floesche/LED-Display_G4_Hardware_Driver/README.md

---
title: Panel PCB 2017
parent: Hardware
grand_parent: Generation 4
---

# G4 Panel

```
├── Design      - OrCAD `.BRD` file
├── Production  - Gerber + BOM
└── Schematic   - pdf with schematic
```
