floesche/LED-Display_G4_Hardware_Driver/driver_40mm_atmega_v1/production_v1/placement_pin1.txt

VERSION = 2.0
UUNITS = MILLIMETERS

#    refdes          !   symbol_x !   symbol_y ! rotation ! mirror ! symbol_name                      ! embedded_layer                  
#-----------------------------------------------------------------------------------------------------------------------
Y1                   !    15.5000 !    11.7000 !      180 !        ! CSTCE_V_C                        !                                 
Y2                   !    14.2000 !    33.2000 !        0 !        ! CSTCE_V_C                        !                                 
Y3                   !     7.7000 !    22.5000 !        0 !        ! CSTCE_V_C                        !                                 
Y4                   !    13.2000 !     3.6000 !       90 !        ! CSTCE_V_C                        !                                 
R11                  !    15.8001 !    31.3000 !      180 !        ! EIA0402                          !                                 
R12                  !    19.5250 !    29.8657 !      270 !        ! EIA0402                          !                                 
R13                  !    18.7440 !    29.8657 !      270 !        ! EIA0402                          !                                 
R14                  !    15.8077 !    35.3012 !      180 !        ! EIA0402                          !                                 
R15                  !    15.8077 !    36.0822 !      180 !        ! EIA0402                          !                                 
R16                  !    17.9630 !    38.2375 !       90 !        ! EIA0402                          !                                 
R17                  !    18.7440 !    38.2375 !       90 !        ! EIA0402                          !                                 
R18                  !    19.5250 !    38.2375 !       90 !        ! EIA0402                          !                                 
R2                   !    18.6193 !    13.5894 !      180 !        ! EIA0402                          !                                 
R20                  !    16.4944 !    19.8689 !      270 !        ! EIA0402                          !                                 
R21                  !    15.7134 !    19.8689 !      270 !        ! EIA0402                          !                                 
R22                  !    12.4647 !    21.5556 !      180 !        ! EIA0402                          !                                 
R23                  !    12.4647 !    24.9920 !      180 !        ! EIA0402                          !                                 
R24                  !    12.4647 !    25.7730 !      180 !        ! EIA0402                          !                                 
R25                  !    14.8390 !    28.5531 !       90 !        ! EIA0402                          !                                 
R26                  !    15.7762 !    28.5531 !       90 !        ! EIA0402                          !                                 
R27                  !    16.5572 !    28.5531 !       90 !        ! EIA0402                          !                                 
R29                  !    15.3391 !     3.4364 !      180 !        ! EIA0402                          !                                 
R3                   !    22.4928 !    11.9027 !      270 !        ! EIA0402                          !                                 
R30                  !    19.2126 !     1.9059 !      270 !        ! EIA0402                          !                                 
R31                  !    18.4316 !     1.9059 !      270 !        ! EIA0402                          !                                 
R32                  !    15.4953 !     7.1852 !      180 !        ! EIA0402                          !                                 
R33                  !    15.4953 !     7.9662 !      180 !        ! EIA0402                          !                                 
R34                  !    17.9630 !    10.4339 !       90 !        ! EIA0402                          !                                 
R35                  !    18.7440 !    10.4339 !       90 !        ! EIA0402                          !                                 
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
R54                  !    22.8999 !    24.6000 !        0 !        ! EIA0402                          !                                 
R55                  !    22.8999 !    25.4000 !        0 !        ! EIA0402                          !                                 
R56                  !    22.8999 !    26.2000 !        0 !        ! EIA0402                          !                                 
R57                  !    22.8999 !    27.0000 !        0 !        ! EIA0402                          !                                 
R58                  !    22.8999 !    27.8000 !        0 !        ! EIA0402                          !                                 
R59                  !    18.8000 !    19.6001 !      270 !        ! EIA0402                          !                                 
R60                  !    19.6000 !    19.6001 !      270 !        ! EIA0402                          !                                 
R61                  !    29.8371 !     3.6830 !      180 !        ! EIA0402                          !                                 
R62                  !    26.9161 !     3.6830 !      180 !        ! EIA0402                          !                                 
R63                  !    25.9080 !     9.0091 !      270 !        ! EIA0402                          !                                 
R64                  !    29.7101 !     8.1280 !      180 !        ! EIA0402                          !                                 
R65                  !    33.7741 !     7.7470 !      180 !        ! EIA0402                          !                                 
R66                  !    36.0680 !     7.1199 !       90 !        ! EIA0402                          !                                 
R67                  !    35.4251 !     3.6830 !      180 !        ! EIA0402                          !                                 
R68                  !    32.7581 !     3.6830 !      180 !        ! EIA0402                          !                                 
R1                   !     1.0934 !    12.2151 !      270 !        ! EIA0402                          !                                 
R10                  !    28.5001 !    28.0000 !      180 !        ! EIA0402                          !                                 
R19                  !    12.1521 !    28.5846 !        0 !        ! EIA0402                          !                                 
R28                  !    38.7376 !    13.4017 !       90 !        ! EIA0402                          !
