floesche/LED-Display_G4_Hardware_Driver/docs/assets/driver_v1p2_back_photo.jpg

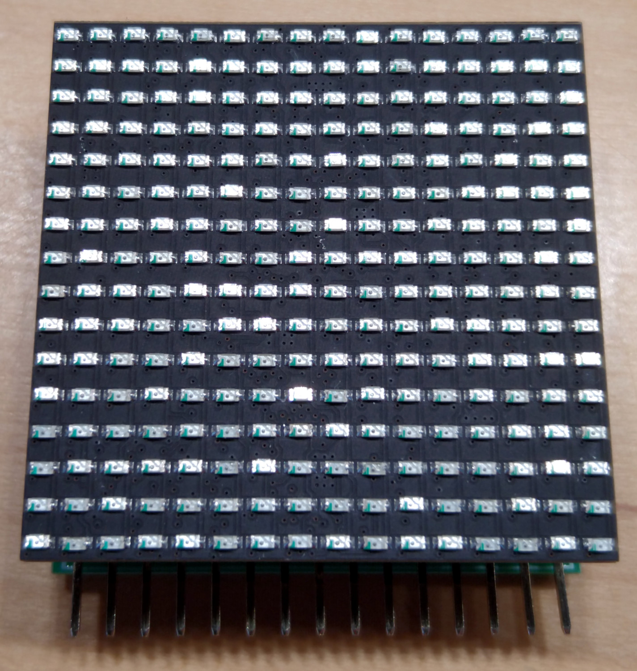
docs/assets/driver_v1p2_back_photo.jpg
