floesche/LED-Display_G4_Hardware_Driver/docs/assets/driver_v1p6_front_iso-photo.png

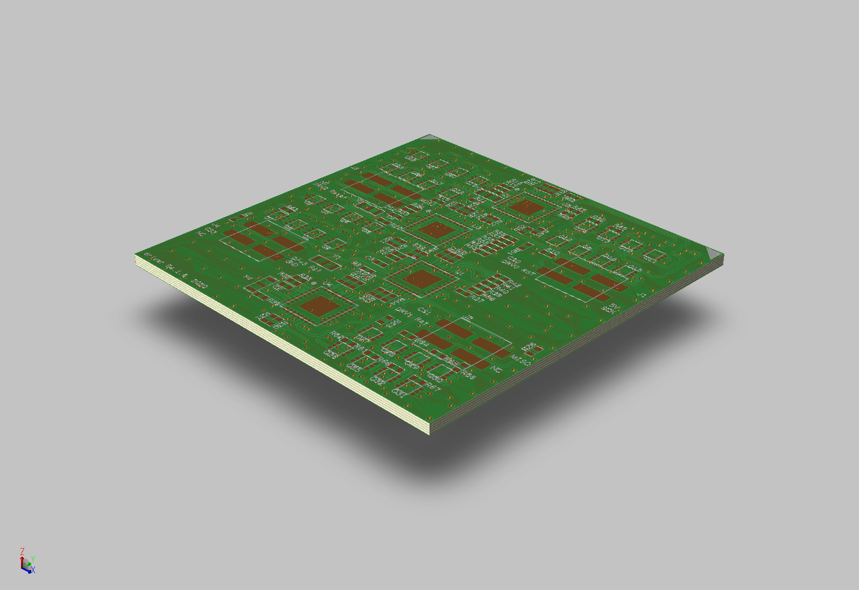
docs/assets/driver_v1p6_front_iso-photo.png
