floesche/LED-Display_G4_Hardware_Driver/docs/assets/driver_v1p6_front_render.jpg

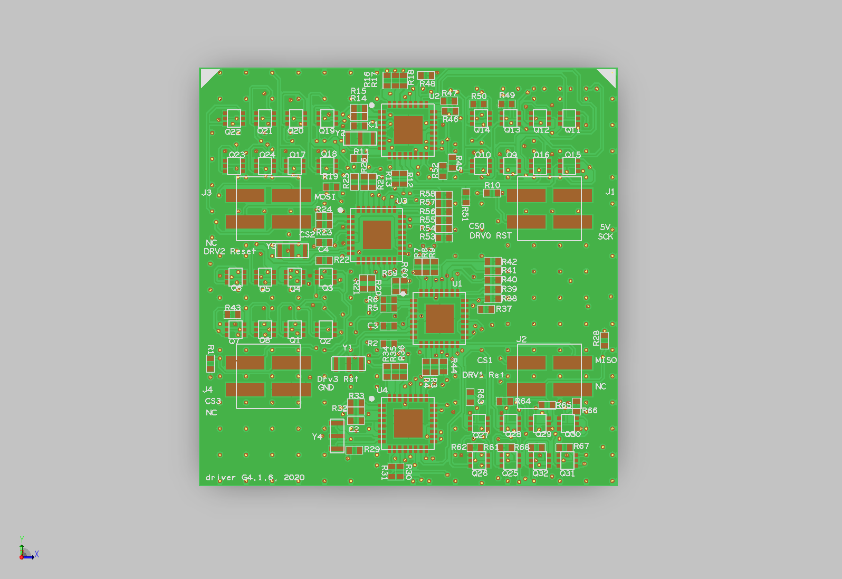
docs/assets/driver_v1p6_front_render.jpg
