floesche/LED-Display_G4_Hardware_Driver/docs/assets/driver_v2p0_back_photo.jpg

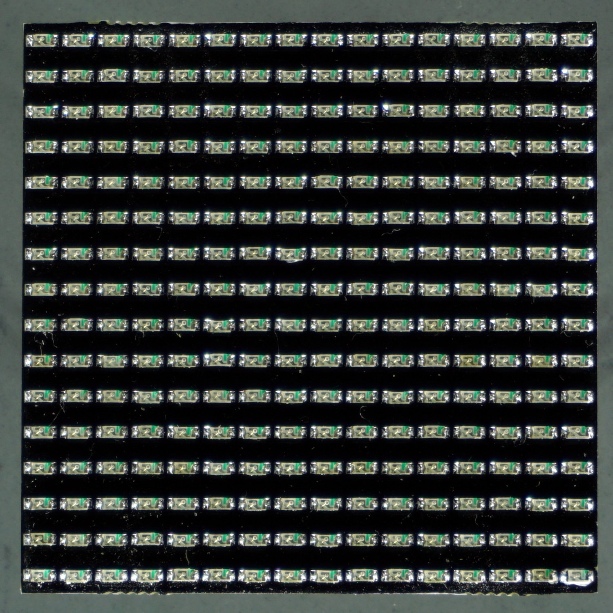
docs/assets/driver_v2p0_back_photo.jpg
