floesche/LED-Display_G4_Hardware_Driver/driver_40mm_max6960_v0/BOM.xls

Item # | Qty | Reference | Description | P/N | Vendor
1 | 1 | C1 | 0.47uf capacitor, SM0603 | 718-1609-6-ND | Digikey
2 | 2 | C2,C3 | 0.1uF capacitor, SM0603 | 1276-1258-6-ND | Digkey
3 | 2 | P1, P2 | 15x2 SMD conector, male | PTSHSM-515-D-06-T-AP- -XX-X-LF, note XX-X can be TR-P, TP-P or TR-0 | Major League Electronics
4 | 1 | P3 | 15 position right angle male header, 0.1” pitch | A32702-40-ND | Digikey
5 | 1 | P4 | 15 position right angle female header, 0.1” pitch | S5490-ND | Digikey
6 | 2 | U1, U3 | 8x8 Matrix Graphic LED Driver | 700-MAX6963ATH | Mouser
7 | 1 | U2 | Single buffer gate with 3-State Output | 74AHC1G126SE-7DIDKR-ND | Digikey
