floesche/LED-Display_G4_Hardware_Driver/driver_32mm_atmega_v0p2/BOM.xls

Sheet: Sheet1
Item# | Qty | References | part desc. | mfg P/N | vendor | price | $100 | $500 | $1000 | $1500 | $2000 | 100 | 500 | 1000 | 1500 | 2000 | price/board_100 | price/board_500 | price/board_1000 | price/board_1500 | price/board_2000 | MOQ | Availability | Comments_Lj | Your Comments
1 | 1 | U1 | IC DRIVER DARL 8CH 50V.5A 18-SO | ULN2804AFWG(CELHACT-ND) | Digikey | 0.92 | 0.63 | 0.462 | 0.3675 | 0.336 | 0.3045 | 100 | 500 | 1000 | 1500 | 2000 | 0.63 | 0.462 | 0.3675 | 0.336 | 0.3045 | 1 | 26688
2 | 1 | IC1 | IC AVR MCU 16K 20MHZ 32TQFP | ATMEGA168-20AU-ND | Digikey | 4.32 | 2.412 | 2.412 | 2.412 | 2.412 | 2.412 | 100 | 500 | 1000 | 1500 | 2000 | 2.412 | 2.412 | 2.412 | 2.412 | 2.412 | 1 | 53937
3 | 2 | P3, P4 | 8 POS PEEL-A-WAY SIP CONN. | Custom | Adv. Interconn. |  |  |  |  |  |  |  |  |  | 3000 | 4000 | 0 | 0 | 0 | 0 | 0 |  |  |  | Already purchased. This is a 32 position strip. The board requires 2x8 pos strips.
4 | 8 | R1, R2, R3, R4, R5, R6, R7, R8 | RES 0603 82 OHM 1/10W 1% | P82.0HCT-ND | Digikey | 0.8 | 0.0105 | 0.00576 | 0.00384 | 0.00198 | 0.00198 | 800 | 4000 | 8000 | 12000 | 16000 | 0.084 | 0.04608 | 0.03072 | 0.01584 | 0.01584 | 1 | 77007
5 | 1 | R9 | RES 0603 10K OHM 1/10W 5% | P10KGCT-ND | Digikey | 0.1 | 0.007 | 0.00384 | 0.00256 | 0.00256 | 0.00256 | 100 | 500 | 1000 | 1500 | 2000 | 0.007 | 0.00384 | 0.00256 | 0.00256 | 0.00256 | 1 | 13551465
6 | 2 | C1, C2 | CAP 0603 0.33 uF | PCC2274CT-ND | Digikey | 0.5 | 0.0573 | 0.0293 | 0.0207 | 0.0172 | 0.0172 | 200 | 1000 | 2000 | 3000 | 4000 | 0.1146 | 0.0586 | 0.0414 | 0.0344 | 0.0344 | 1 | 138896 | No stock available with major suppliers. Please provide an alternate p/n. | Providing alternative part number. Please purchase the 4,000 MOQ and keep the surplus in stock. We will be placing recurring orders.
7 | 1 | P2 | CONN RIGHT-ANGLE, 8 POS, MALE | LTSHR-108-S-02-A-T | MLE |  |  |  |  |  |  |  |  | 1000 | 1500 | 2000 | 0 | 0 | 0 | 0 | 0 |  |  |  | Already purchased
8 | 1 | P1 | CONN RIGHT-ANGLE, 8 POS, FEMALE | SSHR-108-S-02-L-T | MLE |  |  |  |  |  |  |  |  | 1000 | 1500 | 2000 | 0 | 0 | 0 | 0 | 0 |  |  |  | Already purchased
9 | 1 | X1 | CERAMIC RES 20 MHz | 490-1199-6-ND | Digikey | 0.95 | 0.4731 | 0.35862 | 0.32809 | 0.25637 | 0.25637 | 100 | 500 | 1000 | 1500 | 2000 | 0.4731 | 0.35862 | 0.32809 | 0.25637 | 0.25637 | 1 | 34790
 |  |  |  |  |  |  |  |  |  |  |  |  |  |  |  |  | 3.7207 | 3.34114 | 3.18227 | 3.05717 | 3.02567

Sheet: BOM_SS
Item# | Qty | References | part desc. | mfg P/N | vendor
2 | 1 | IC1 | IC AVR MCU 16K 20MHZ 32TQFP | ATMEGA168-20AU-ND | Digikey
3 | 16 | P3, P4 | PIN RECEPTACLES | Elpacko PN 4007-2-01-32-12 | Straight Road Electronics ( see * below)
4 | 8 | R1, R2, R3, R4, R5, R6, R7, R8 | RES 0603 160 OHM 1/10W 0.1% | RG16P160BCT-ND | Digikey
5 | 1 | R9 | RES 0603 10K OHM 1/10W 5% | P10KGCT-ND | Digikey
6 | 2 | C1, C2 | CAP 0603 0.33 uF | 445-12434-1-ND | Digikey
7 | 1 | P2 | CONN RIGHT-ANGLE, 8 POS, MALE | S1111EC-08-ND | Digikey
8 | 1 | P1 | CONN RIGHT-ANGLE, 8 POS, FEMALE | SAM1195-08-ND | Digikey
9 | 1 | X1 | CERAMIC RES 20 MHz | 490-1199-6-ND | Digikey
8 | 8 | U1-U8 | MOSFET N/P-CH 20V SOT563 | DMC2400UV-7DICT-ND | Digikey
* Supplied by Straight Road electronics http://www.straightroadelectronics.com/ Contact: Debby Arrin (949) 215-9449.
