floesche/LED-Display_G4_Hardware_Driver/driver_40mm_atmega_v0p1/BOM.xls

Item # | Qty | Reference | Description | P/N | Vendor
1 | 4 | C1 – C4 | 0.1uF ceramic capacitor, SM0603 | 1276-1258-1-ND | Digikey
2 | 4 | IC1 – IC4 | Atmel Atmega328 20MHz | ATMEGA328P-MURDKR-ND | Digikey
3 | 2 | P1, P2 | 3x2 female header, 0.1” pitch | S7106-ND | Digikey
4 | 4 | R1 – R4 | 1k Ohm resistor, SM0603 | P1.0KGCT-ND | Digikey
5 | 32 | R5 – R36 | 180 Ohm resistor, SM0603 | P180GCT-ND | Digikey
6 | 4 | X1 - X4 | 20MHz ceramic resonator | 490-1199-6-ND | Digikey
7 | 8 | K1 – K8 | 8x1 Recepticals for 0.015 to 0.021” Pins | NA | Customer will supply
