floesche/LED-Display_G4_Hardware_Driver/driver_40mm_atmega_v0p2/BOM.xls

Modifiied Components: P1-P4, R1-R4,
Item # | Qty | Reference | Description | P/N | Vendor
1 | 4 | C1 – C4 | 0.1uF ceramic capacitor, SM0603 | 1276-1258-1-ND | Digikey
2 | 4 | IC1 – IC4 | Atmel Atmega328 20MHz | ATMEGA328P-MURDKR-ND | Digikey
3 | 2 | P1-P4 | 2x2 male header, 0.1” pitch | 952-2119-ND | Digikey
4 | 4 | R1 – R4 | 4.7k Ohm resistor, SM0603 | 311-4.7KGRCT-ND | Digikey
5 | 32 | R5 – R36 | 180 Ohm resistor, SM0603, 1% | 311-180HRCT-ND | Digikey
6 | 4 | X1 - X4 | 20MHz ceramic resonator | 490-1199-6-ND | Digikey
7 | 8 | K1 – K8 | 8x1 Recepticals for 0.015 to 0.021” Pins | PN 4007-2-01-32-12 and PN 14-3-8-4007-2-TG | Elpacko (* see note below)
 |  |  |  |  | * Pin recepticals PN 4007-2-01-32-12 with PN 14-3-8-4007-2-TG single row, on the 8-pin pull away aluminum carrier w/ 0.1" pitch
 |  |  |  |  | Supplied by Straight Road electronics http://www.straightroadelectronics.com/ .
 |  |  |  |  | Contact: Debby Arrin (949) 215-9449.
