floesche/LED-Display_G4_Hardware_Driver/driver_40mm_max6960_v0/adapter_20mm-40mm_v0p1/BOM.xls

Item # | Qty | Reference | Description | P/N | Vendor
1 | 8 | K1 – K8 | 8x1 Recepticals for 0.015 to 0.021” Pins | NA | Customer will supply
2 | 1 | P1, P2 | 15x2 SMD connector, female | PSSHSM-515-D-T-AP- -XX-X-LF (Note, XX-X can be TR-P, TP-P, TP-0)
