floesche/LED-Display_G4_Hardware_Driver/driver_40mm_atmega_v1/production_v1/BOM.xlsx

item | Layer | Part number | SYM_NAME | COMP_DEVICE_TYPE | Digikey number | QUANTITY | Notes | COMP_CLASS | QUANTITY | REFDES
1 | TOP | CSTNE20M0V53Z000R0 | CSTCE_V_C | CERAMIC RES 20.0000MHZ 15PF SMD | 490-17955-6-ND | 4 |  | IC | 4 | Y1;Y2;Y3;Y4
2 | TOP | CC0402ZRY5V7BB104 | EIA0402 | CAP NP_EIA0402_CAP NP | 311-1047-6-ND | 4 | or similar | IC | 4 | C1;C2;C3;C4
3 | TOP | RC0402FR-074K7L | EIA0402 | RESISTOR_EIA0402_4.7K/1% | 311-4.7KLRDKR-ND | 36 | or similar | IC | 36 | R1;R10;R19;R28;R37;R38;R39;R40;R41;R42;R43;R44;R45;R46;R47;R48;R49;R50;R51;R52;R53;R54;R55;R56;R57;R58;R59;R60;R61;R62;R63;R64;R65;R66;R67;R68
4 | TOP | RT0402BRD07210RL | EIA0402 | RESISTOR_EIA0402_210/0.1% | YAG4205DKR-ND | 32 | Or similar; needs to match item 6 | IC | 32 | R2;R3;R4;R5;R6;R7;R8;R9;R11;R12;R13;R14;R15;R16;R17;R18;R20;R21;R22;R23;R24;R25;R26;R27;R29;R30;R31;R32;R33;R34;R35;R36
5 | TOP | 15912040 | HDR-SMD-2X2 | CONN HEADER SMD 4POS 2.54MM | WM9514-ND | 4 |  | IC | 4 | J1;J2;J3;J4
6 | BOTTOM | LTST-C191KGKT | LED-0603 | LED_LED-0603_LED | 160-1446-6-ND | 256 | an example, use whatever color required | IC | 256 | D1;D2;D3;D4;D5;D6;D7;D8;D9;D10;D11;D12;D13;D14;D15;D16;D17;D18;D19;D20;D21;D22;D23;D24;D25;D26;D27;D28;D29;D30;D31;D32;D33;D34;D35;D36;D37;D38;D39;D40;D41;D42;D43;D44;D45;D46;D47;D48;D49;D50;D51;D52;D53;D54;D55;D56;D57;D58;D59;D60;D61;D62;D63;D64;D65;D66;D67;D68;D69;D70;D71;D72;D73;D74;D75;D76;D77;D78;D79;D80;D81;D82;D83;D84;D85;D86;D87;D88;D89;D90;D91;D92;D93;D94;D95;D96;D97;D98;D99;D100;D101;D102;D103;D104;D105;D106;D107;D108;D109;D110;D111;D112;D113;D114;D115;D116;D117;D118;D119;D120;D121;D122;D123;D124;D125;D126;D127;D128;D129;D130;D131;D132;D133;D134;D135;D136;D137;D138;D139;D140;D141;D142;D143;D144;D145;D146;D147;D148;D149;D150;D151;D152;D153;D154;D155;D156;D157;D158;D159;D160;D161;D162;D163;D164;D165;D166;D167;D168;D169;D170;D171;D172;D173;D174;D175;D176;D177;D178;D179;D180;D181;D182;D183;D184;D185;D186;D187;D188;D189;D190;D191;D192;D193;D194;D195;D196;D197;D198;D199;D200;D201;D202;D203;D204;D205;D206;D207;D208;D209;D210;D211;D212;D213;D214;D215;D216;D217;D218;D219;D220;D221;D222;D223;D224;D225;D226;D227;D228;D229;D230;D231;D232;D233;D234;D235;D236;D237;D238;D239;D240;D241;D242;D243;D244;D245;D246;D247;D248;D249;D250;D251;D252;D253;D254;D255;D256
7 | TOP | ATMEGA328P-MUR | QFN32 | ATMEGA328P-MU_6_QFN32_ATMEGA328 | ATMEGA328P-MURDKR-ND | 4 |  | IC | 4 | U1;U2;U3;U4
8 | TOP | DMC2400UV-7 | SOT563 | MPM3002_0_SOT563_DMC2400UV | DMC2400UV-7DIDKR-ND | 32 |  | IC | 32 | Q1;Q2;Q3;Q4;Q5;Q6;Q7;Q8;Q9;Q10;Q11;Q12;Q13;Q14;Q15;Q16;Q17;Q18;Q19;Q20;Q21;Q22;Q23;Q24;Q25;Q26;Q27;Q28;Q29;Q30;Q31;Q32
