floesche/LED-Display_G4_Hardware_Driver/(threads)

Thread 1 (2022-12-16):

Files for the panel driver v2

phifisch, 2022-12-16:
Hi,
Thanks for the work, but I am missing the files for the version 2 of the driver panel. Information about it is included on the web page (github.io), so I suppose it is missing here, or is there a reason for that?
Best,
Philippe

floesche, 2022-12-16:
Hi @phifisch, thanks for your question. Can you please paste the link to the website where the missing information is mentioned? That would help identifying the problem.

floesche, 2022-12-16:
You probably mean this page, right? https://reiserlab.github.io/Modular-LED-Display/Generation%204/Panel/docs/driver.html#driver-v2

If so: we have not characterized the driver-v2 as well as v1, so we chose not to share it yet. I would like to understand better how and if we can help you with this. So if you shoot me an email (see https://reiserlab.github.io/Modular-LED-Display/Contact.html), maybe we continue the conversation that way?
