floesche/LED-Display_G4_Hardware_Driver/docs/assets/driver_40mm_atmega_v0p1_schematic.pdf

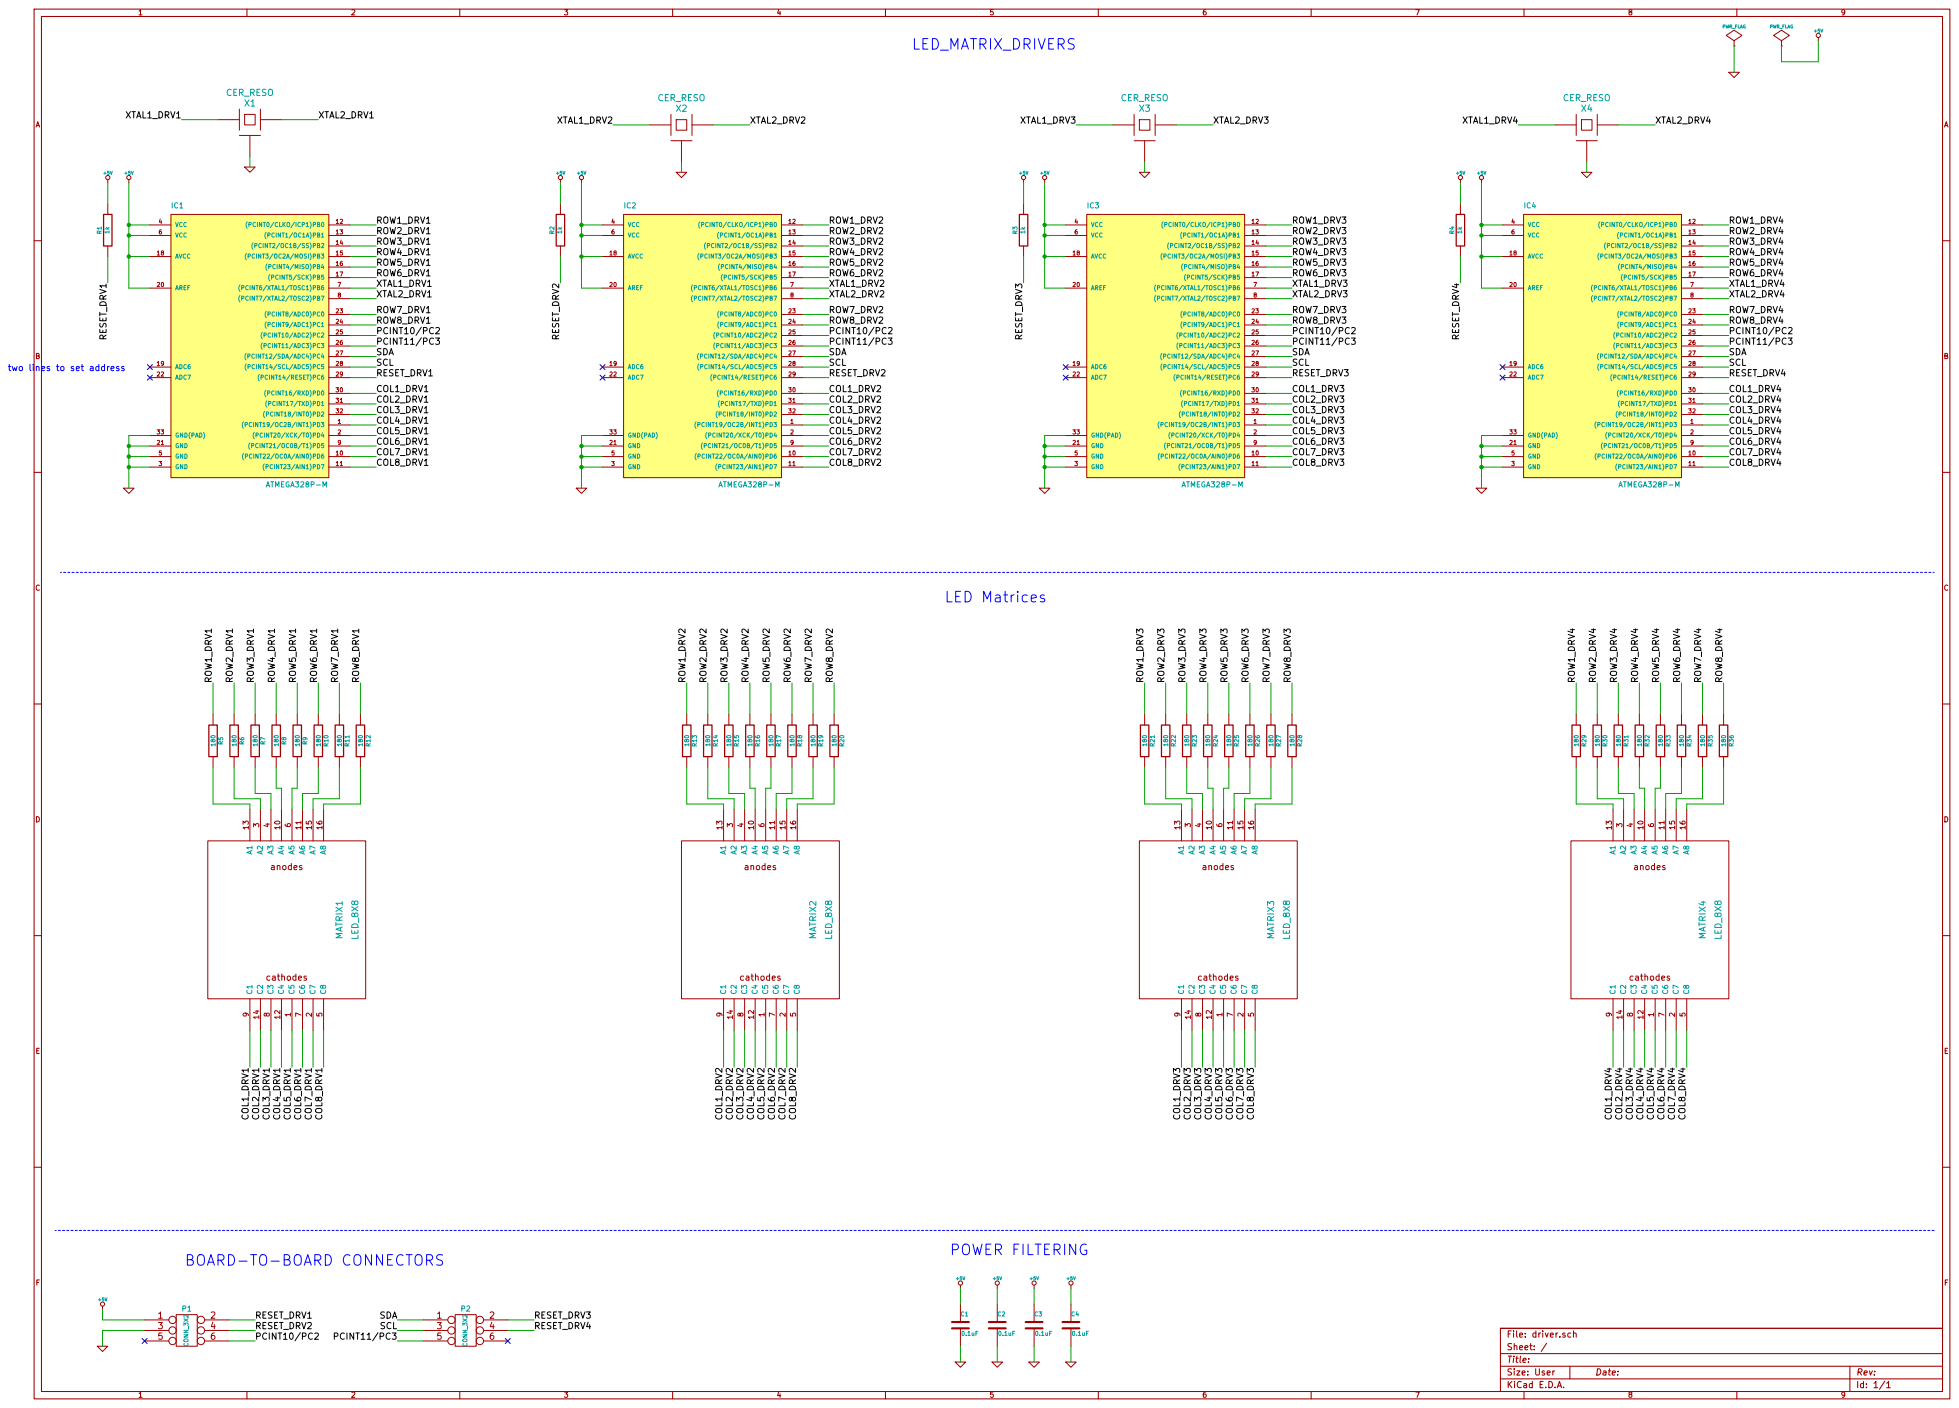
[picture p45: page 1]

two lines to set address

BOARD-TO-BOARD CONNECTORS

Id: 1/1 Title: File: driver.sch Sheet: /
