floesche/LED-Display_G4_Hardware_Driver/docs/assets/driver_40mm_atmega_v0p3_schematic.pdf

BOARD-TO-BOARD CONNECTORS

Id: 1/1 Title: File: driver.sch Sheet: /
