floesche/LED-Display_G4_Hardware_Driver/docs/assets/driver_40mm_atmega_v0p5_schematic.pdf

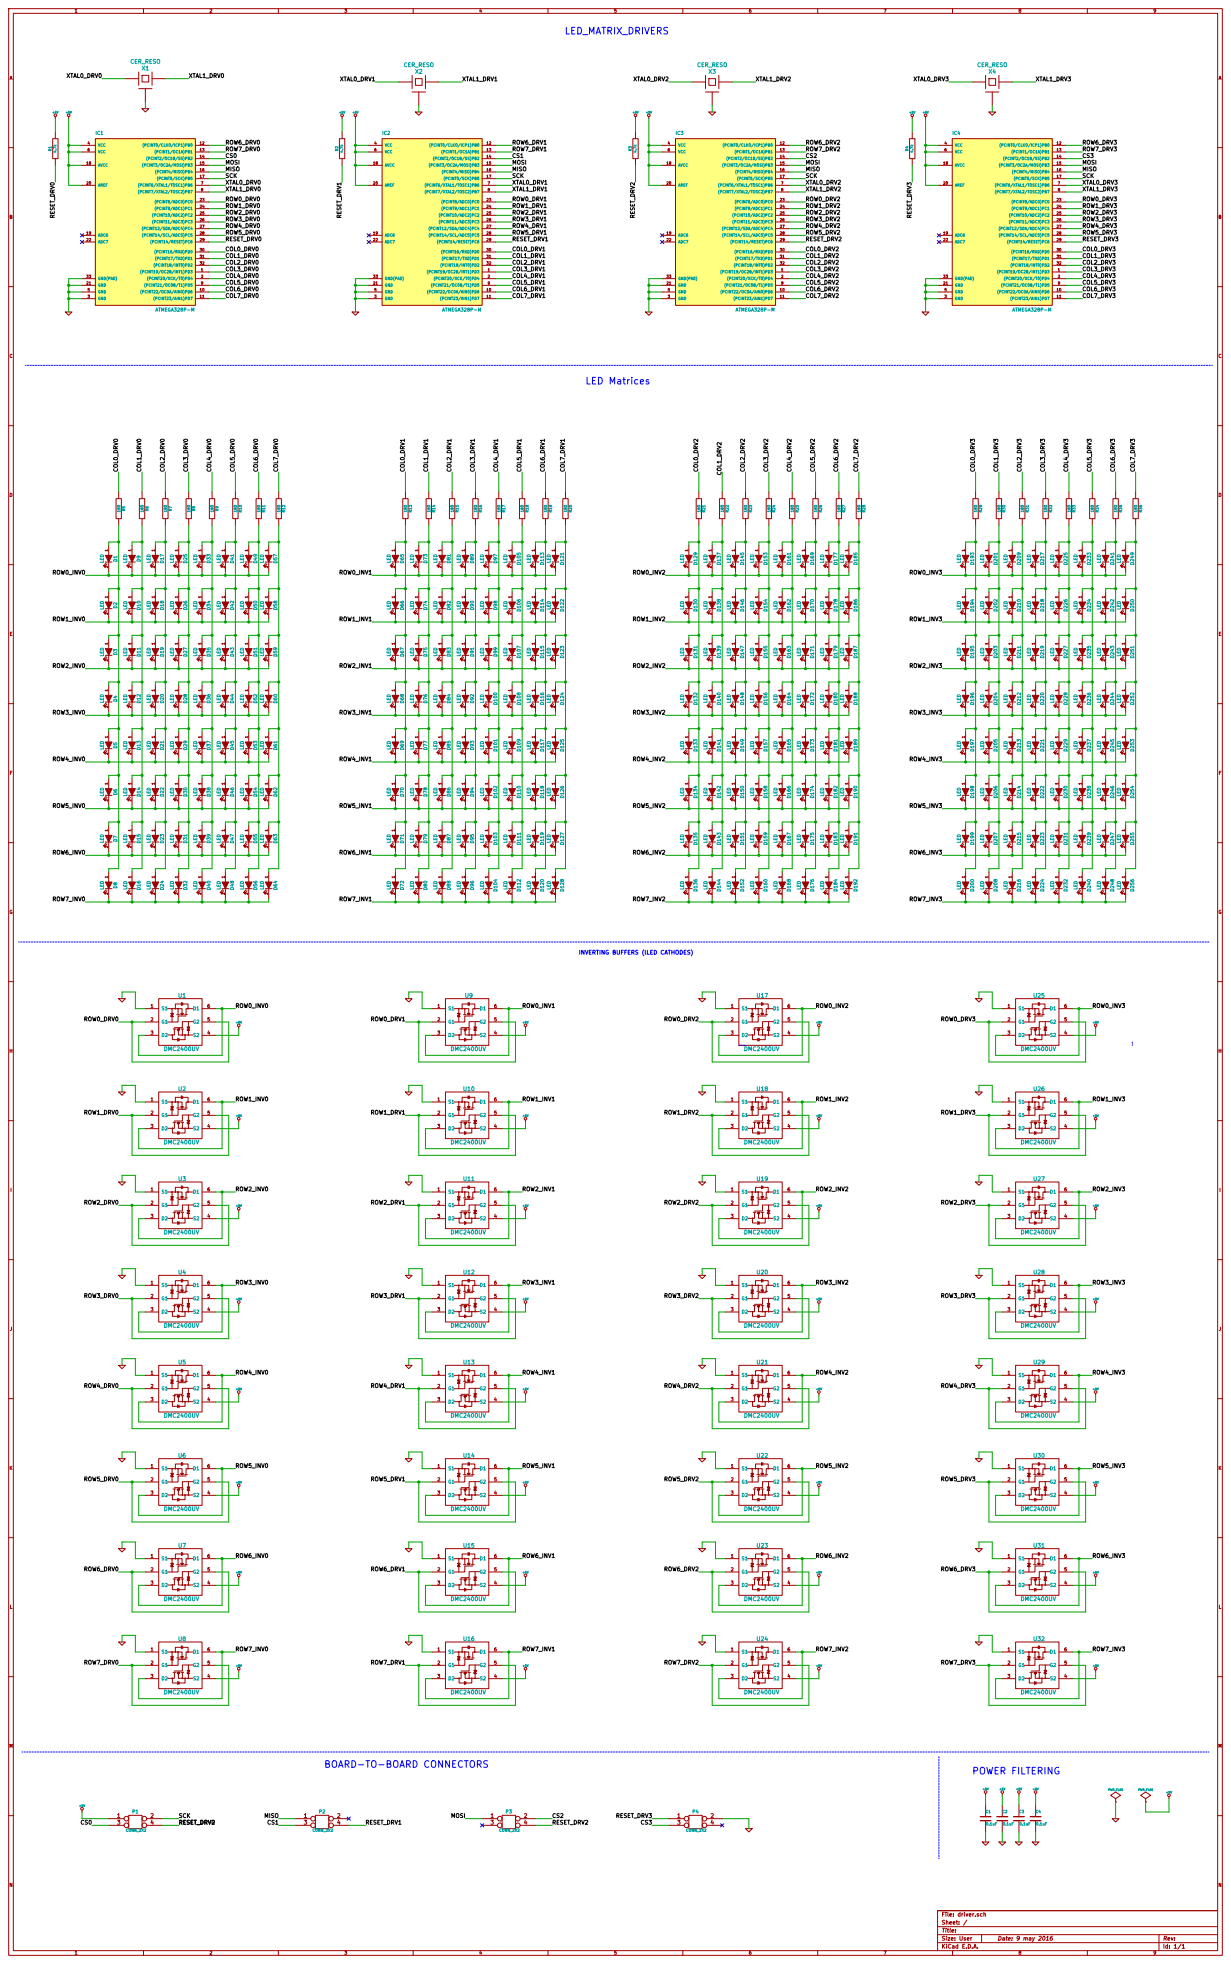
[picture p47: page 1]

INVERTING BUFFERS (lLED CATHODES)

BOARD-TO-BOARD CONNECTORS

Id: 1/1 Title: File: driver.sch Sheet: /
