floesche/LED-Display_G4_Hardware_Driver/docs/assets/driver_40mm_atmega_v0p4_schematic.pdf

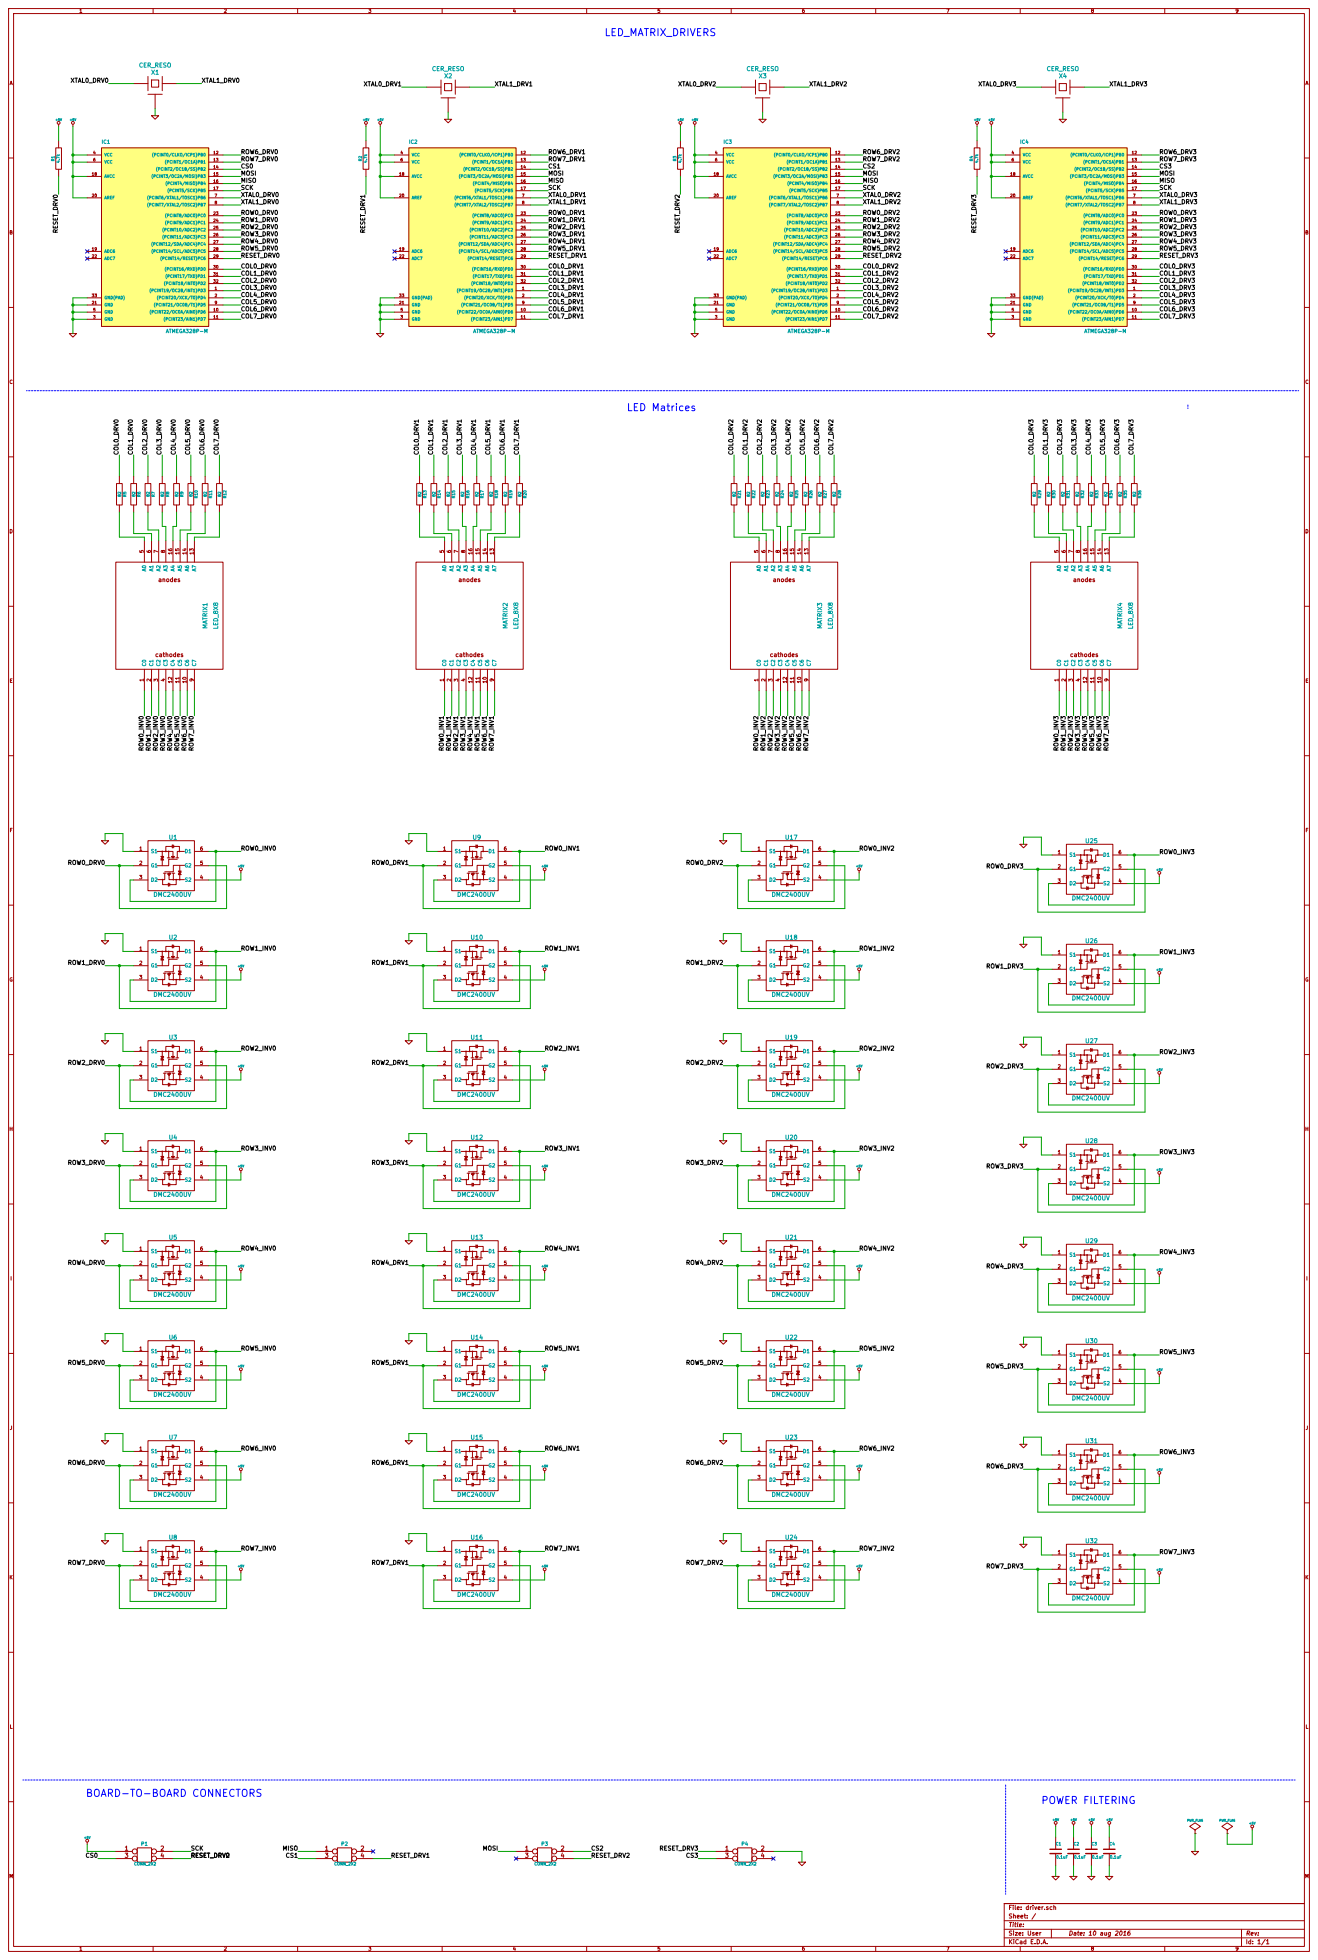
[picture p48: page 1]

BOARD-TO-BOARD CONNECTORS

Id: 1/1 Title: File: driver.sch Sheet: /
