floesche/LED-Display_G4_Hardware_Driver/docs/assets/driver_40mm_atmega_v1_schematic.pdf

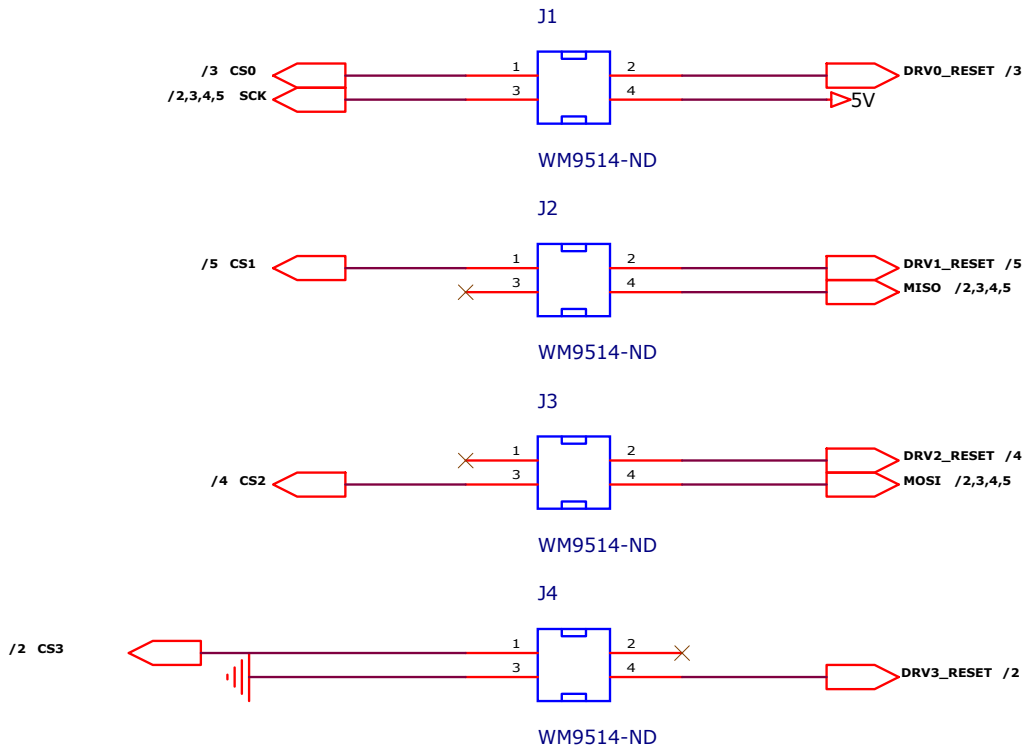
[picture p49: page 1]
DRV0_RESET /3; /2,3,4,5 SCK; DRV1_RESET /5; MOSI /2,3,4,5; DRV2_RESET /4; DRV3_RESET /2; MISO /2,3,4,5; Monday, November 07, 2016

Title
LED Matrix Connector

Size B | Document Number <Doc> | Rev A

Date: | Sheet of

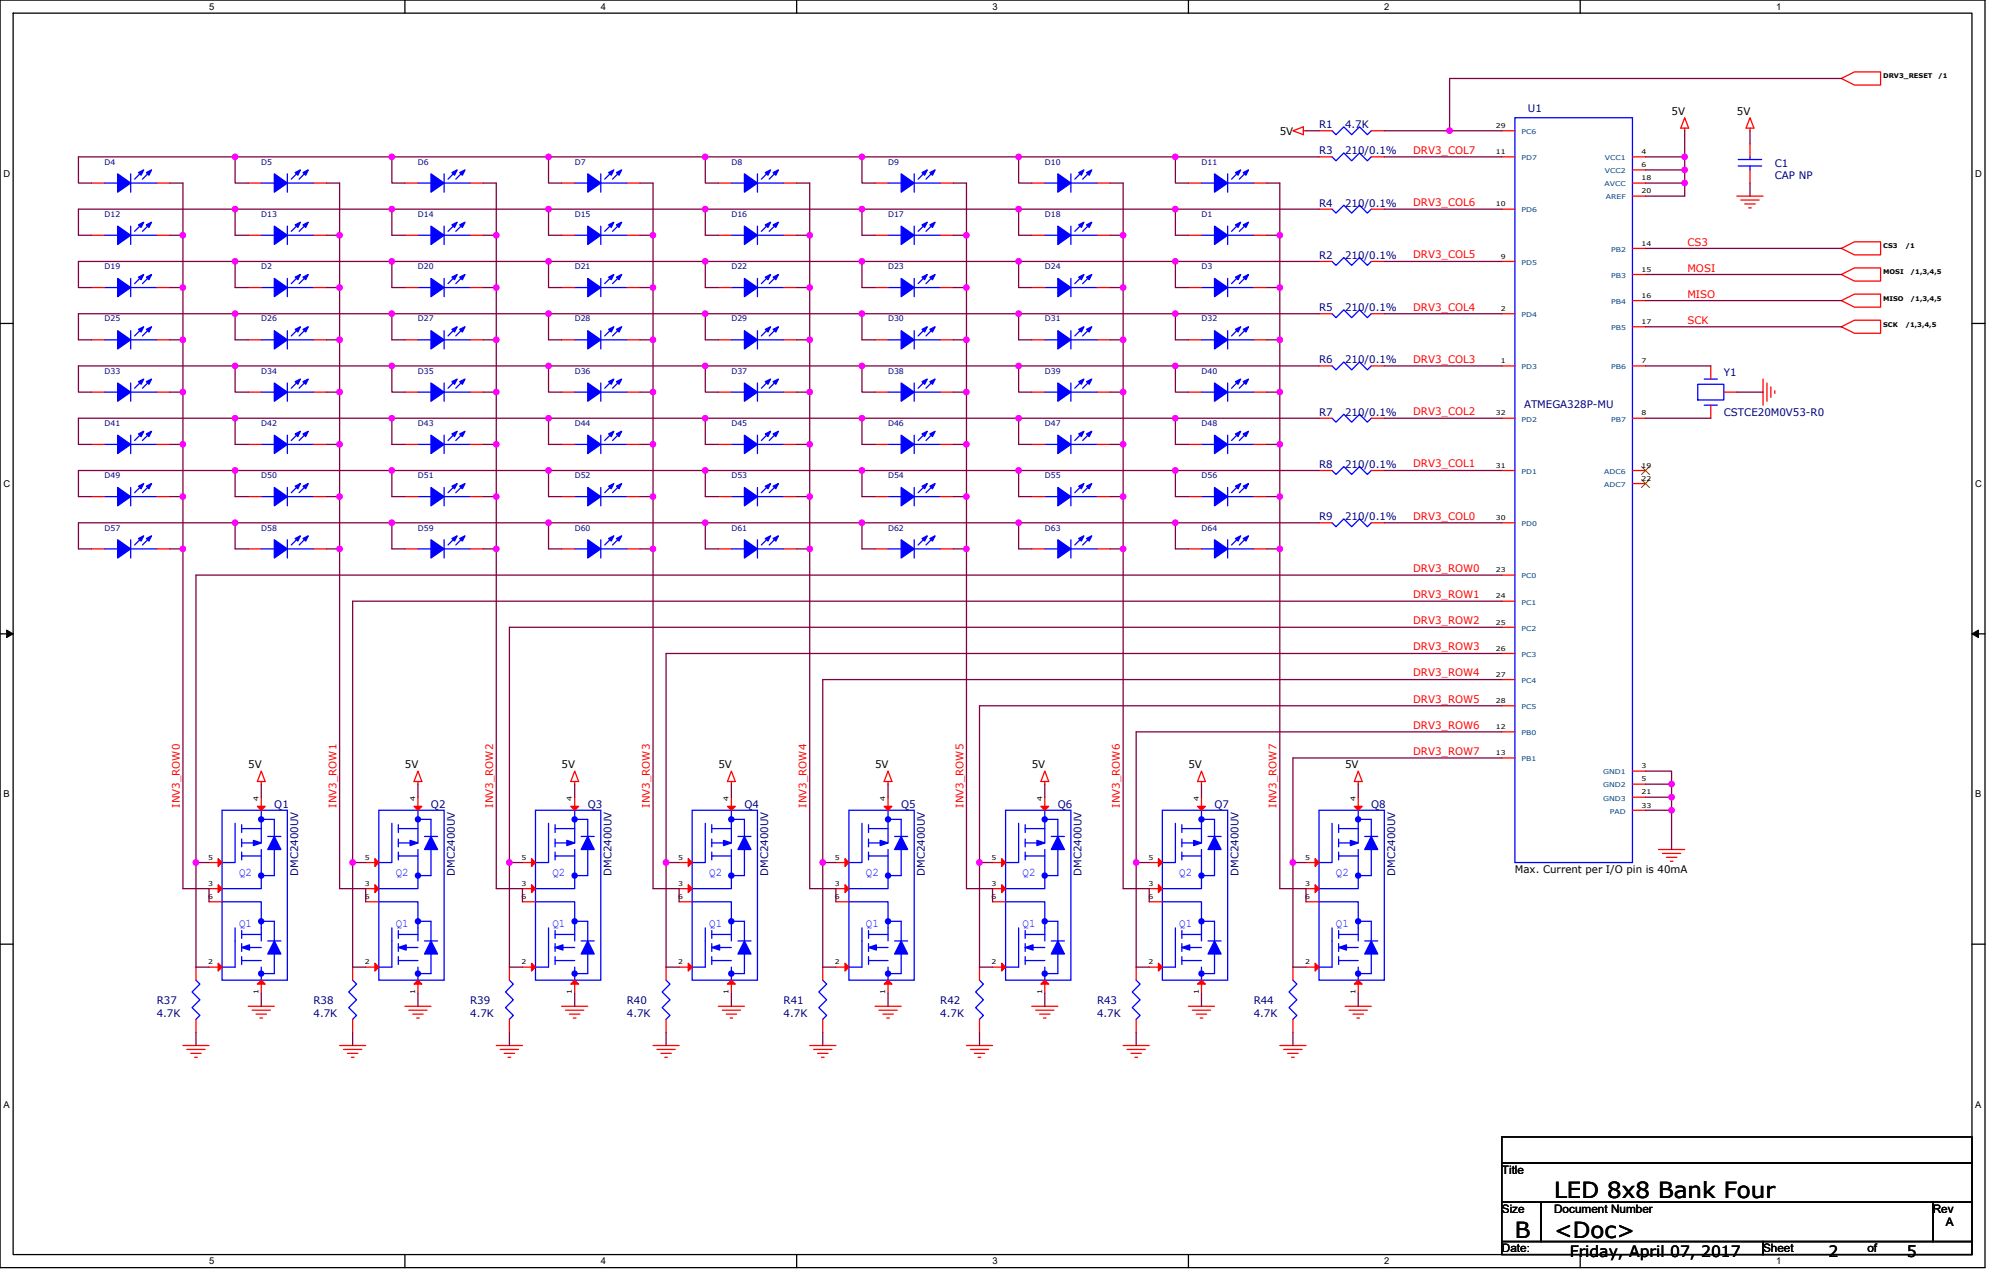
[picture p50: page 2]

5V | | | | | | | DRV3_ROW1 24

5V | | | | | | DRV3_ROW2 25

5V | | | | | DRV3_ROW3 26

5V | | | | DRV3_ROW4 27

5V | | | DRV3_ROW5 28

5V | | DRV3_ROW6 12

5V | 13
5V

Max. Current per I/O pin is 40mA

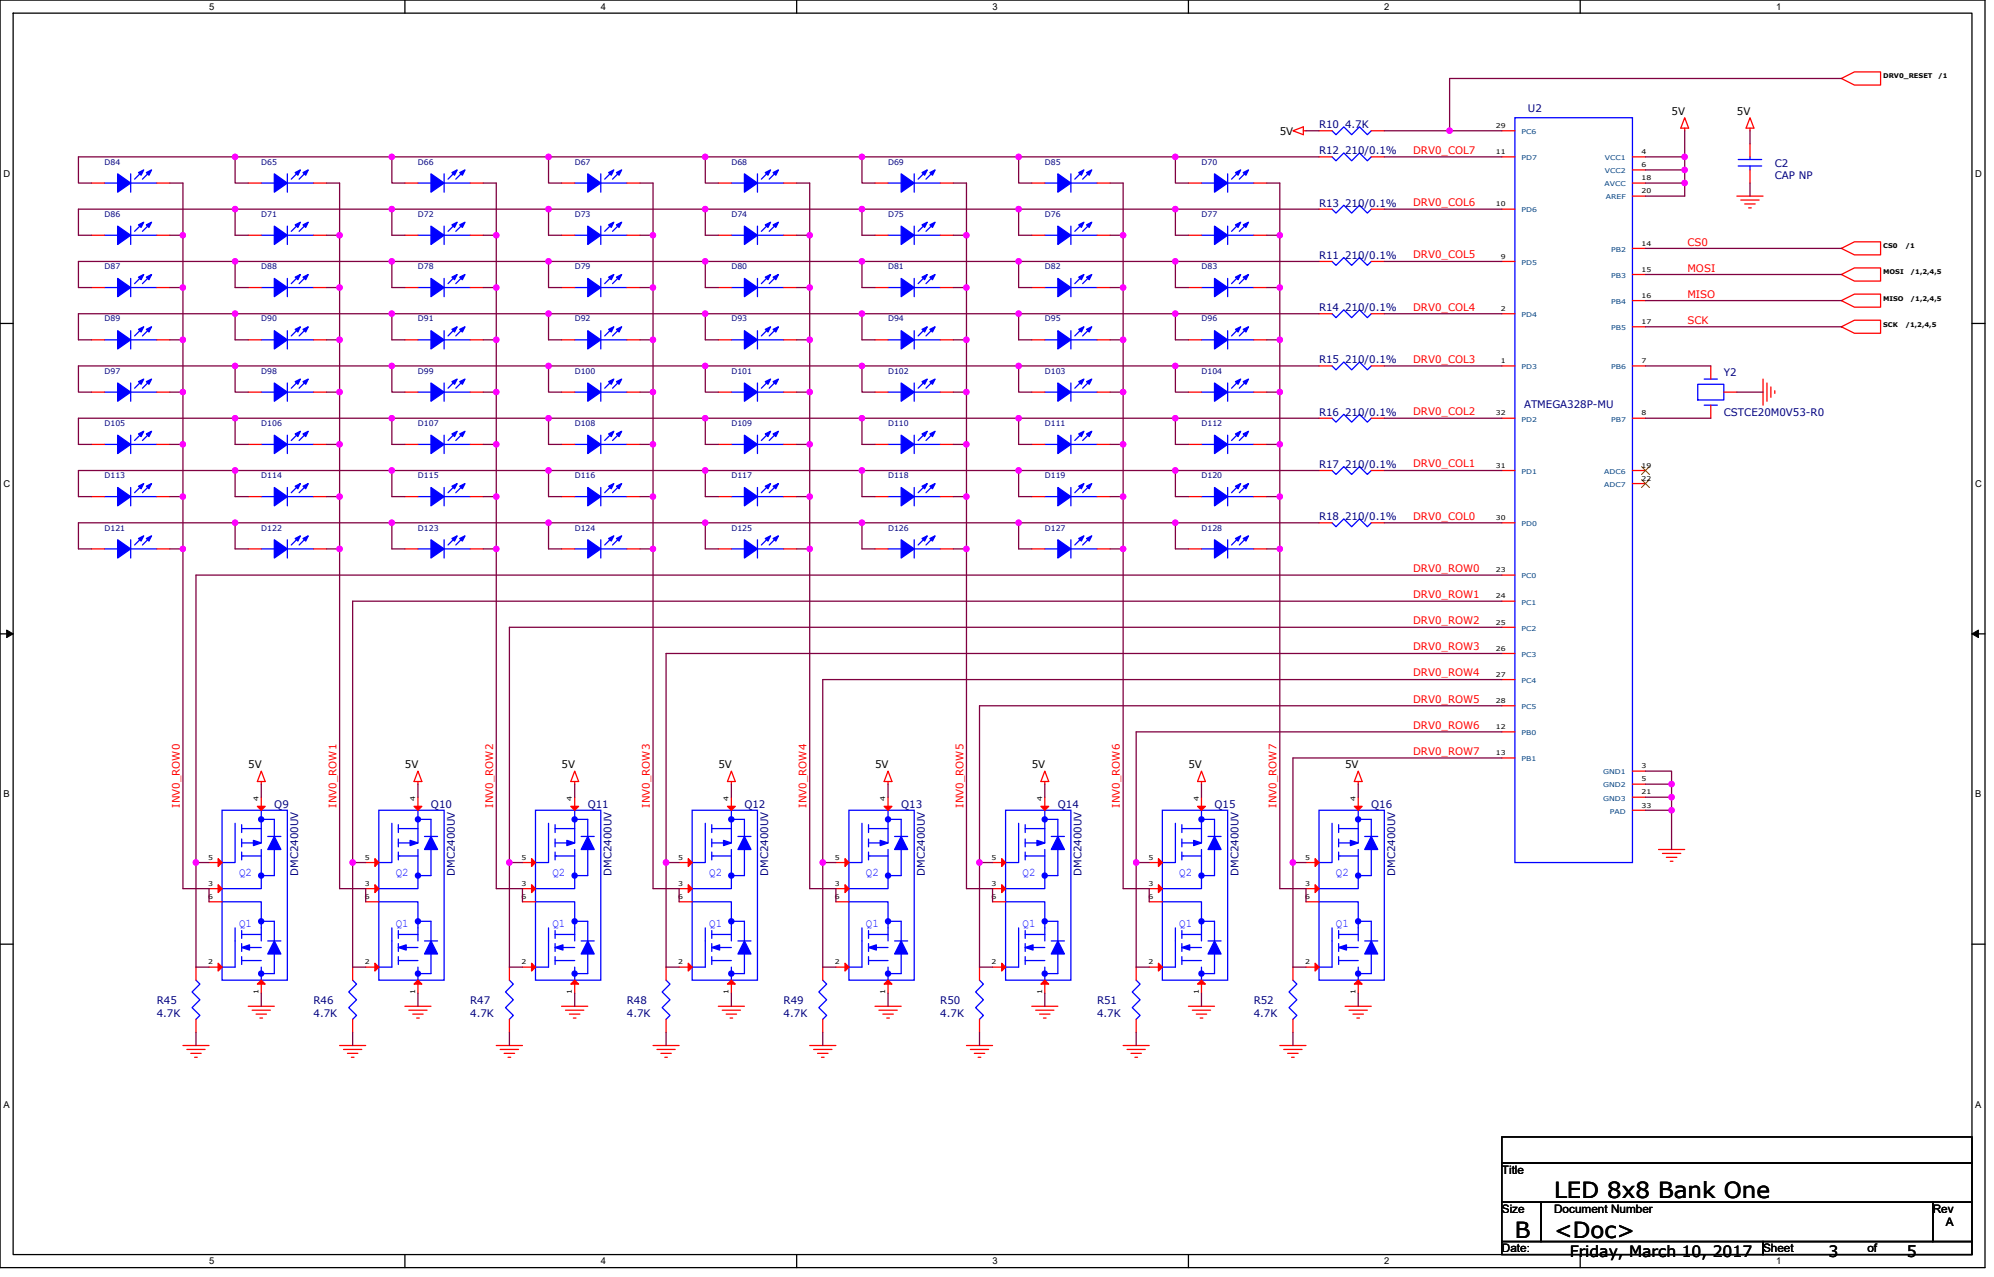
[picture p51: page 3]

5V | | | | | | | DRV0_ROW1 24

5V | | | | | | DRV0_ROW2 25

5V | | | | | DRV0_ROW3 26

5V | | | | DRV0_ROW4 27

5V | | | DRV0_ROW5 28

5V | | DRV0_ROW6 12

5V | 13
5V

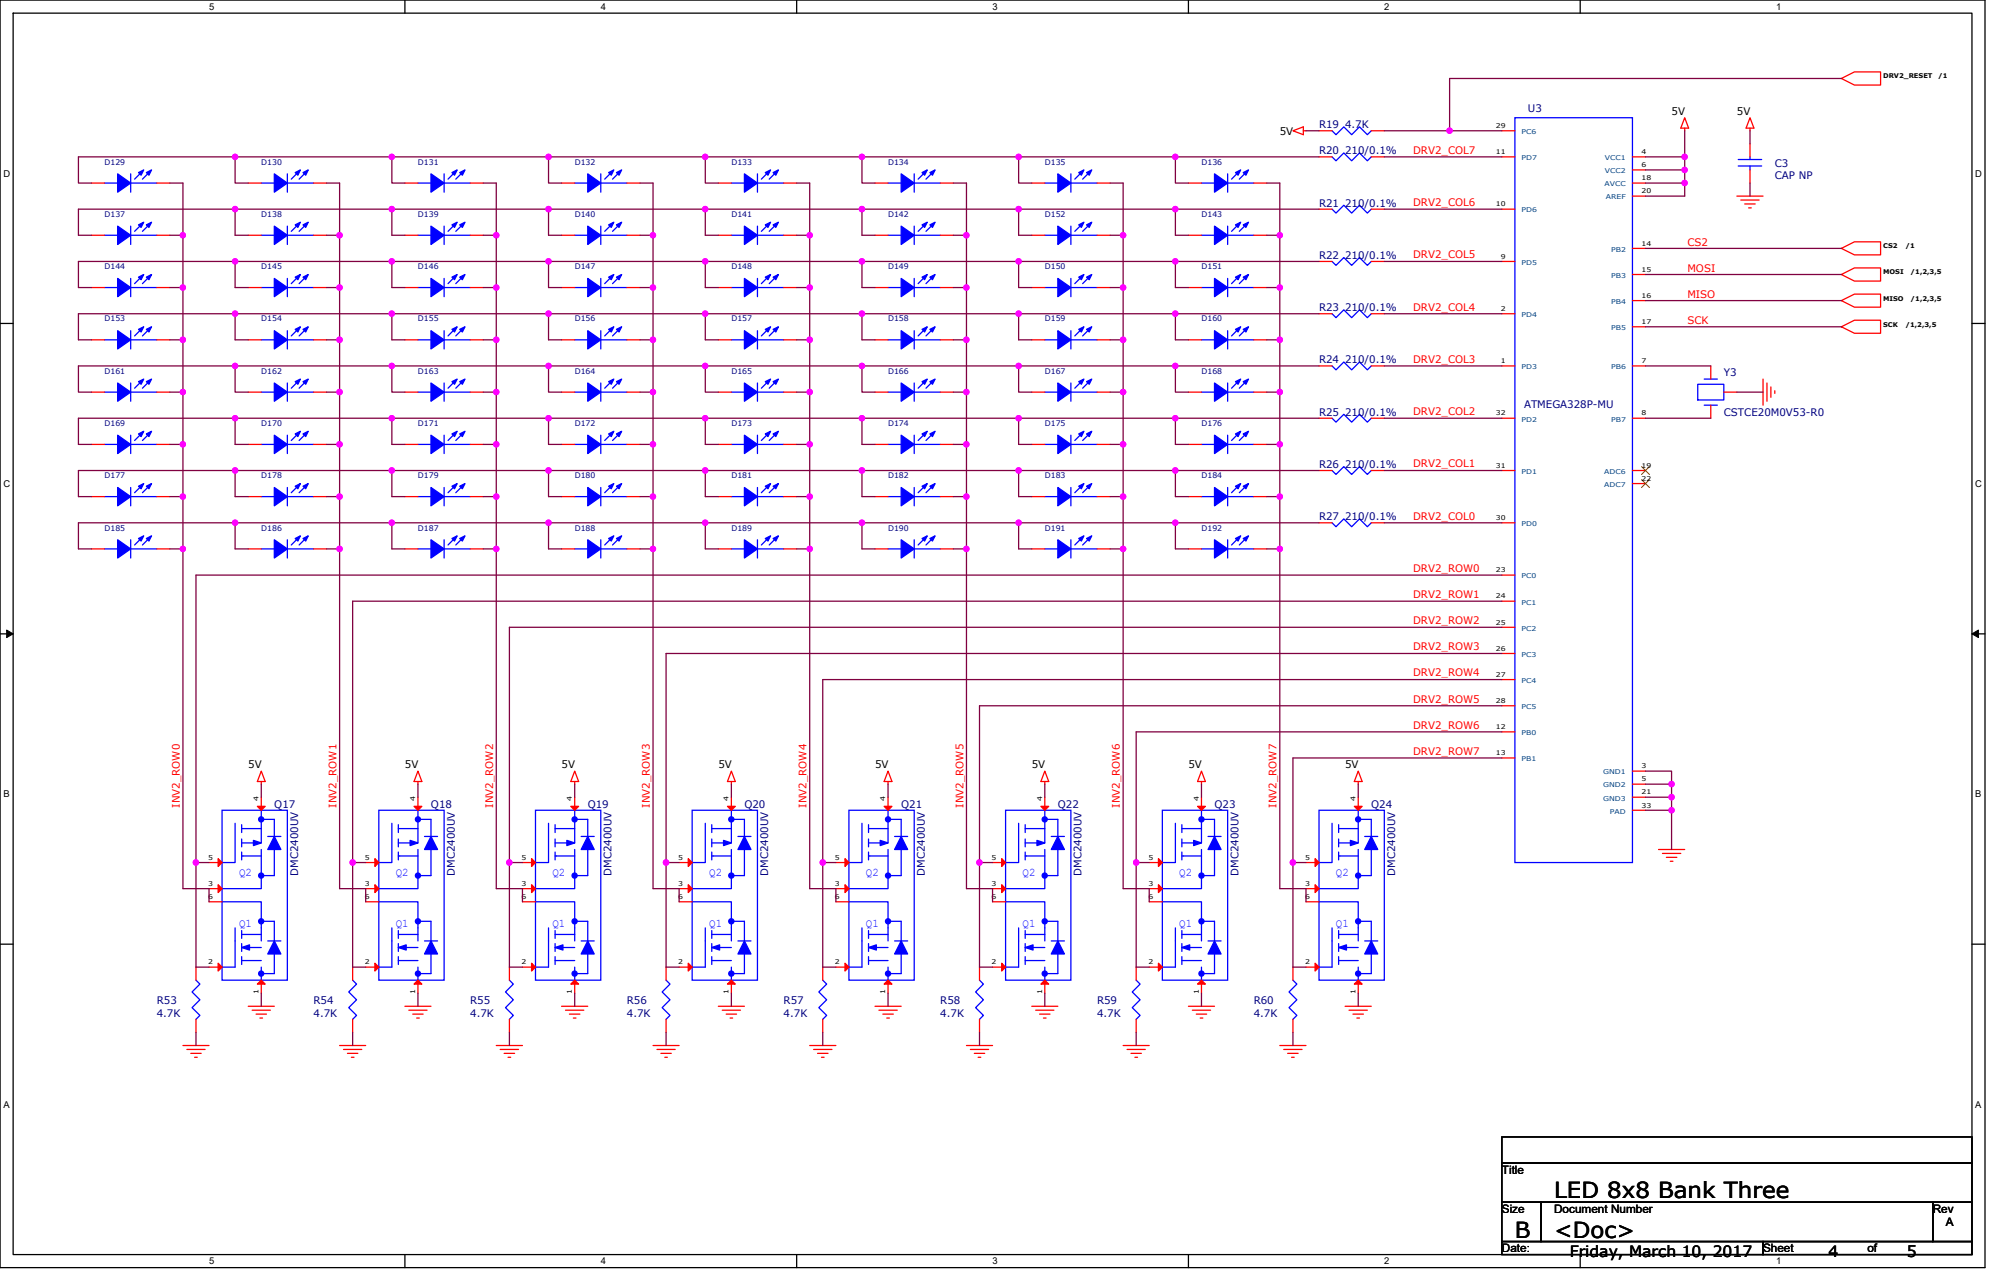
[picture p52: page 4]

5V | | | | | | | DRV2_ROW1 24

5V | | | | | | DRV2_ROW2 25

5V | | | | | DRV2_ROW3 26

5V | | | | DRV2_ROW4 27

5V | | | DRV2_ROW5 28

5V | | DRV2_ROW6 12

5V | 13
5V

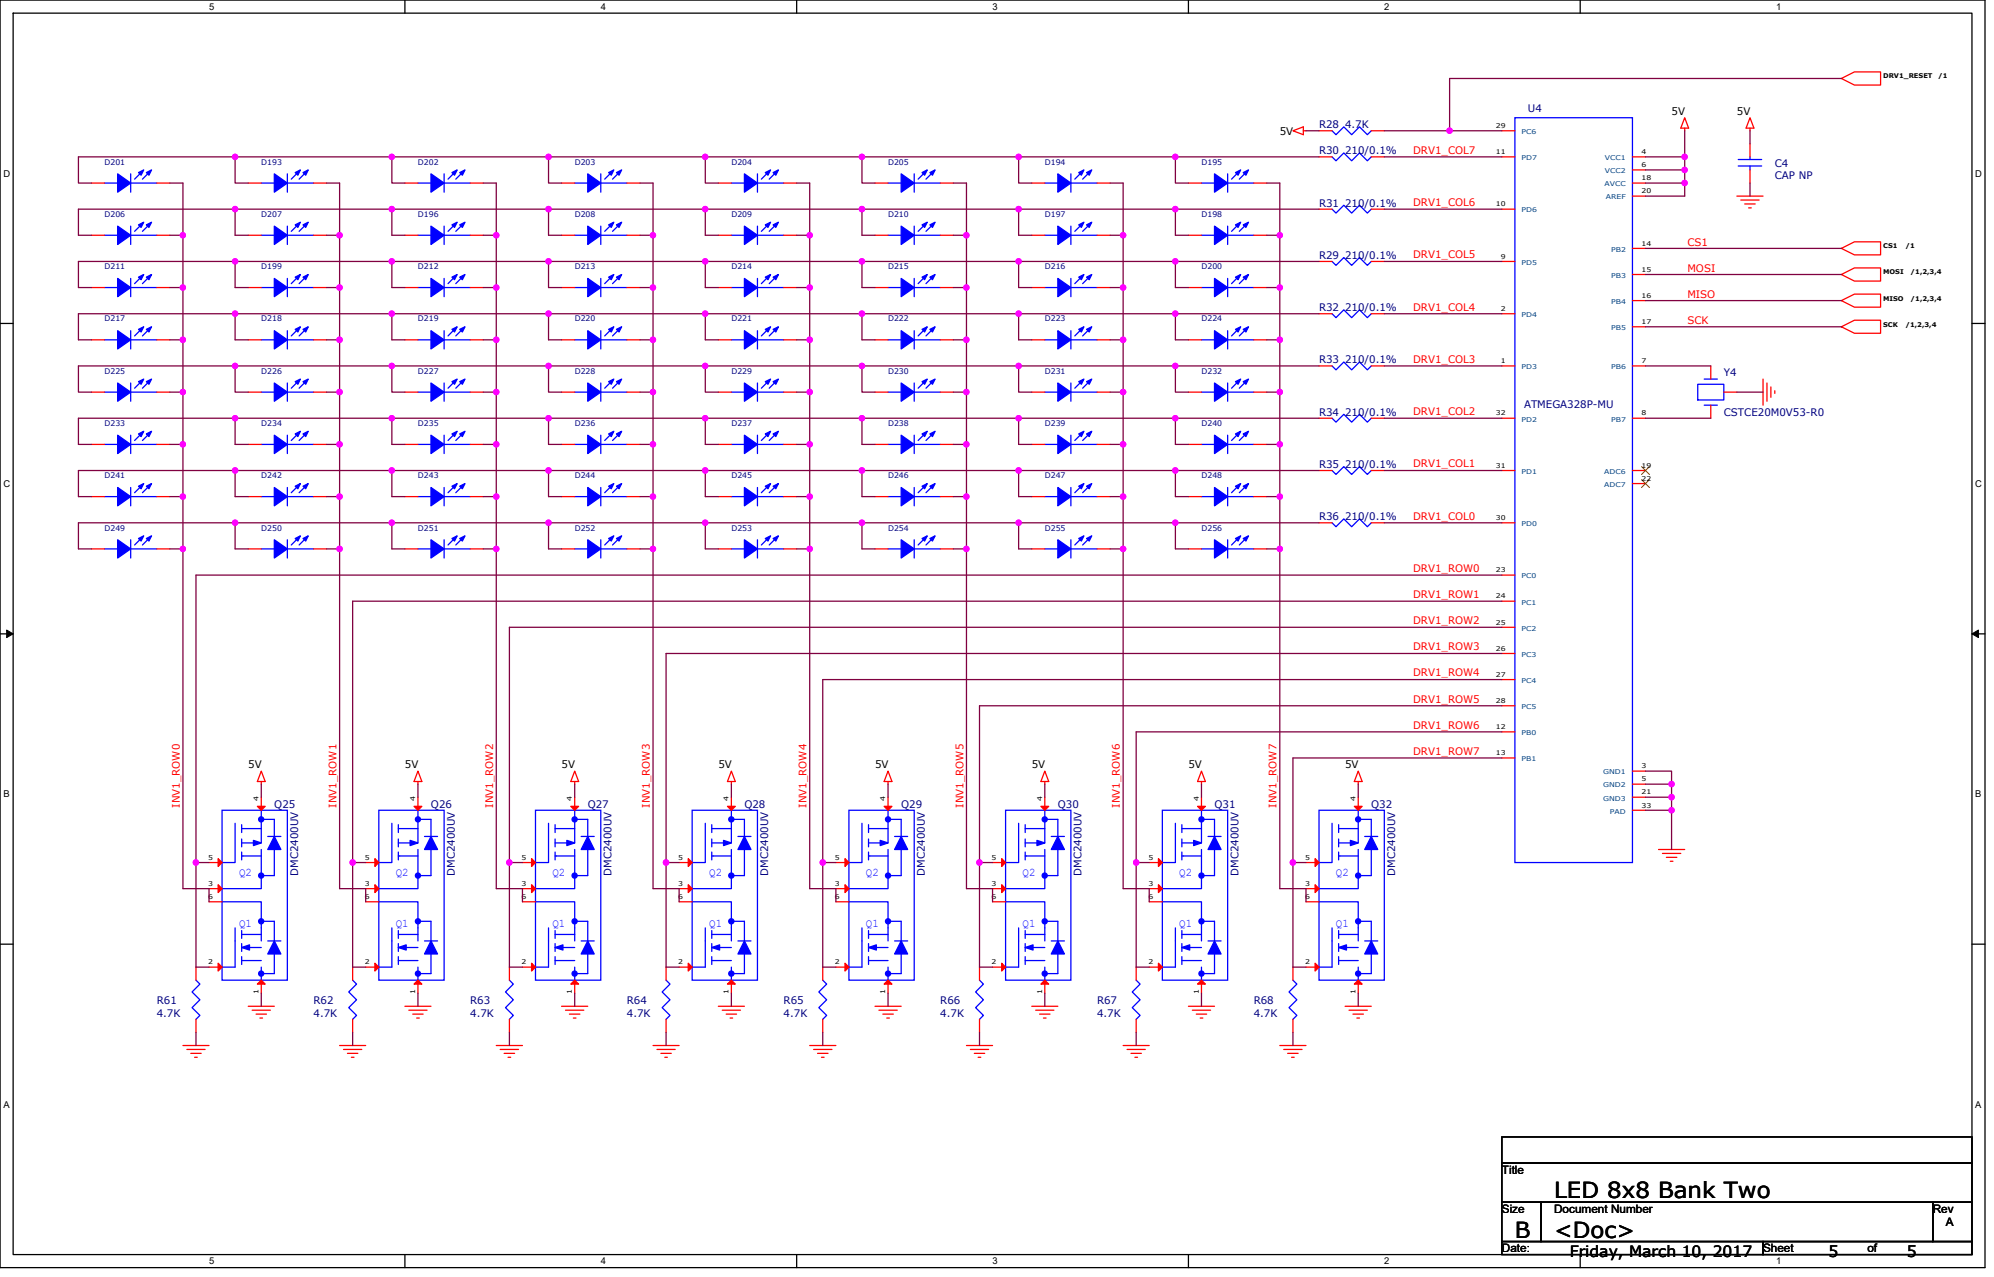
[picture p53: page 5]

5V | | | | | | | DRV1_ROW1 24

5V | | | | | | DRV1_ROW2 25

5V | | | | | DRV1_ROW3 26

5V | | | | DRV1_ROW4 27

5V | | | DRV1_ROW5 28

5V | | DRV1_ROW6 12

5V | 13
5V
