floesche/LED-Display_G4_Hardware_Driver/docs/assets/adapter_32-32mm-32-64mm-D_v0p1_schematic.pdf

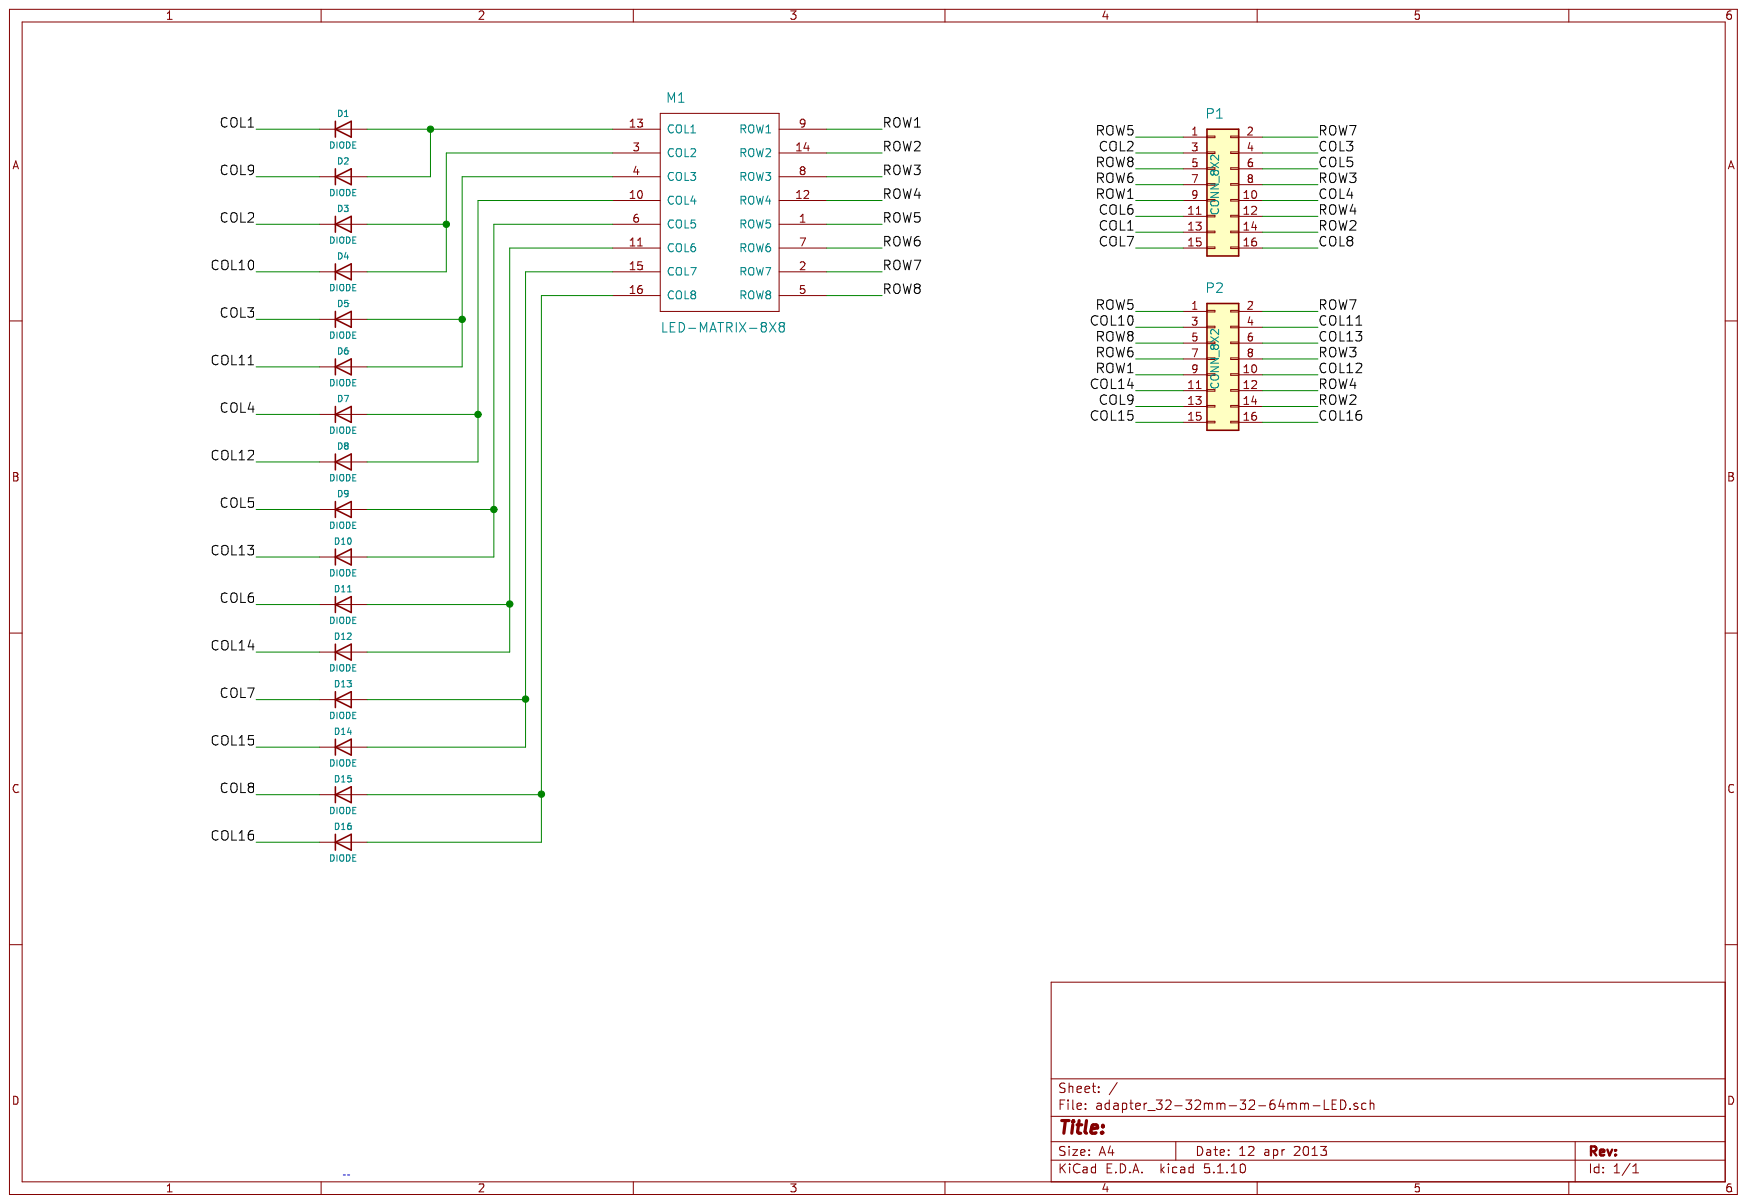
[picture p54: page 1]
