floesche/LED-Display_G4_Hardware_Driver/docs/assets/adapter_32-32mm-32-64mm_v0p1_schematic.pdf

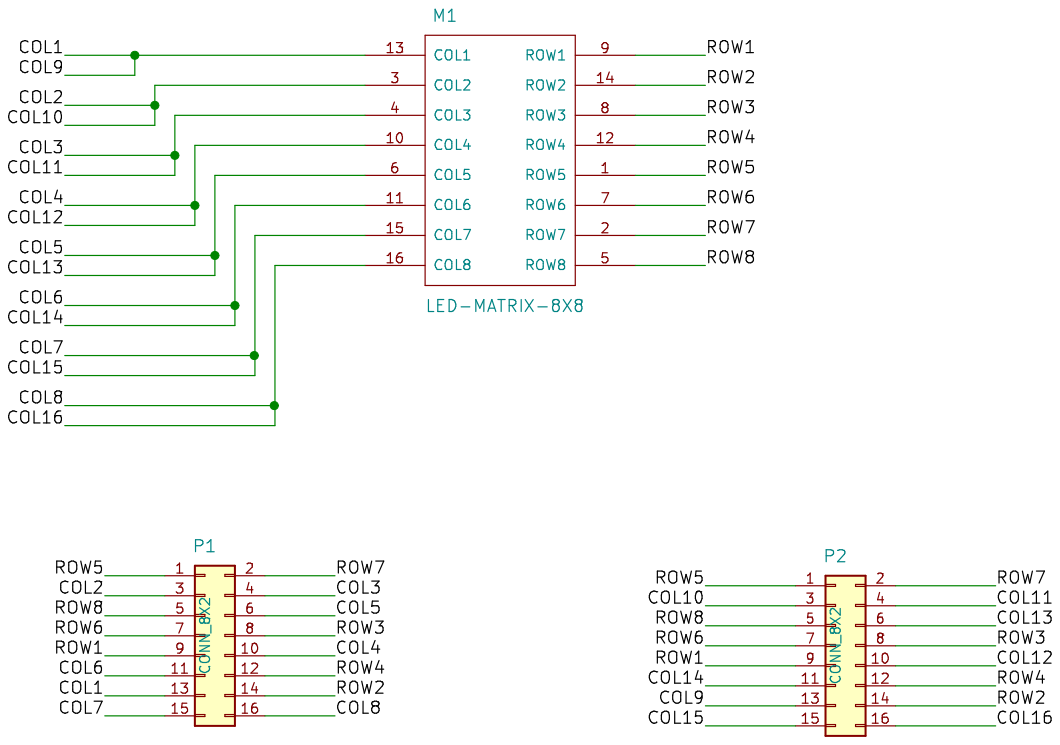
[picture p55: page 1]
