floesche/LED-Display_G4_Hardware_Driver/docs/assets/adapter_32-64mm-32-64mm_v0p1_schematic.pdf

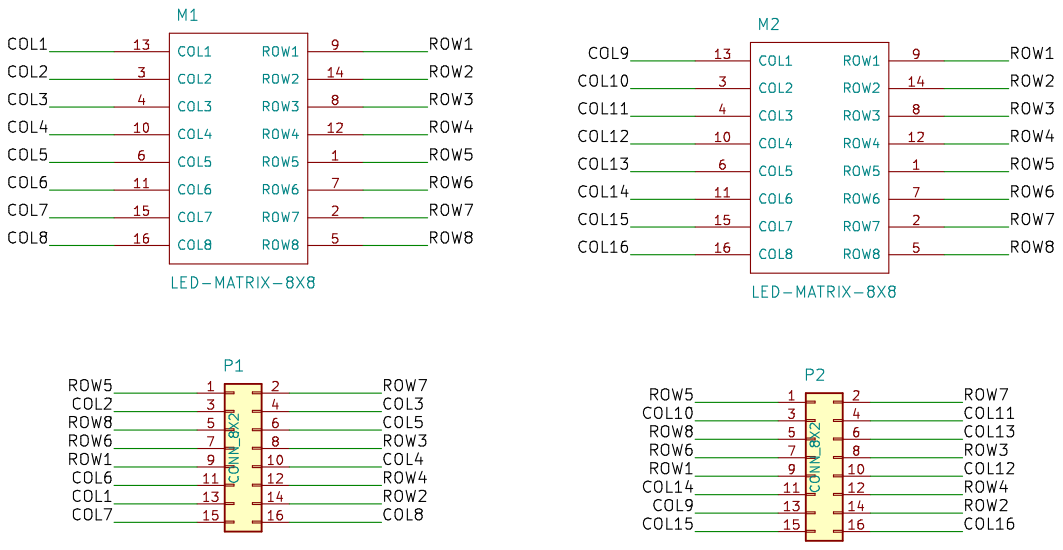
[picture p56: page 1]
