floesche/LED-Display_G4_Hardware_Driver/docs/assets/driver_32-64mm_max6960_v0p1_schematic.pdf

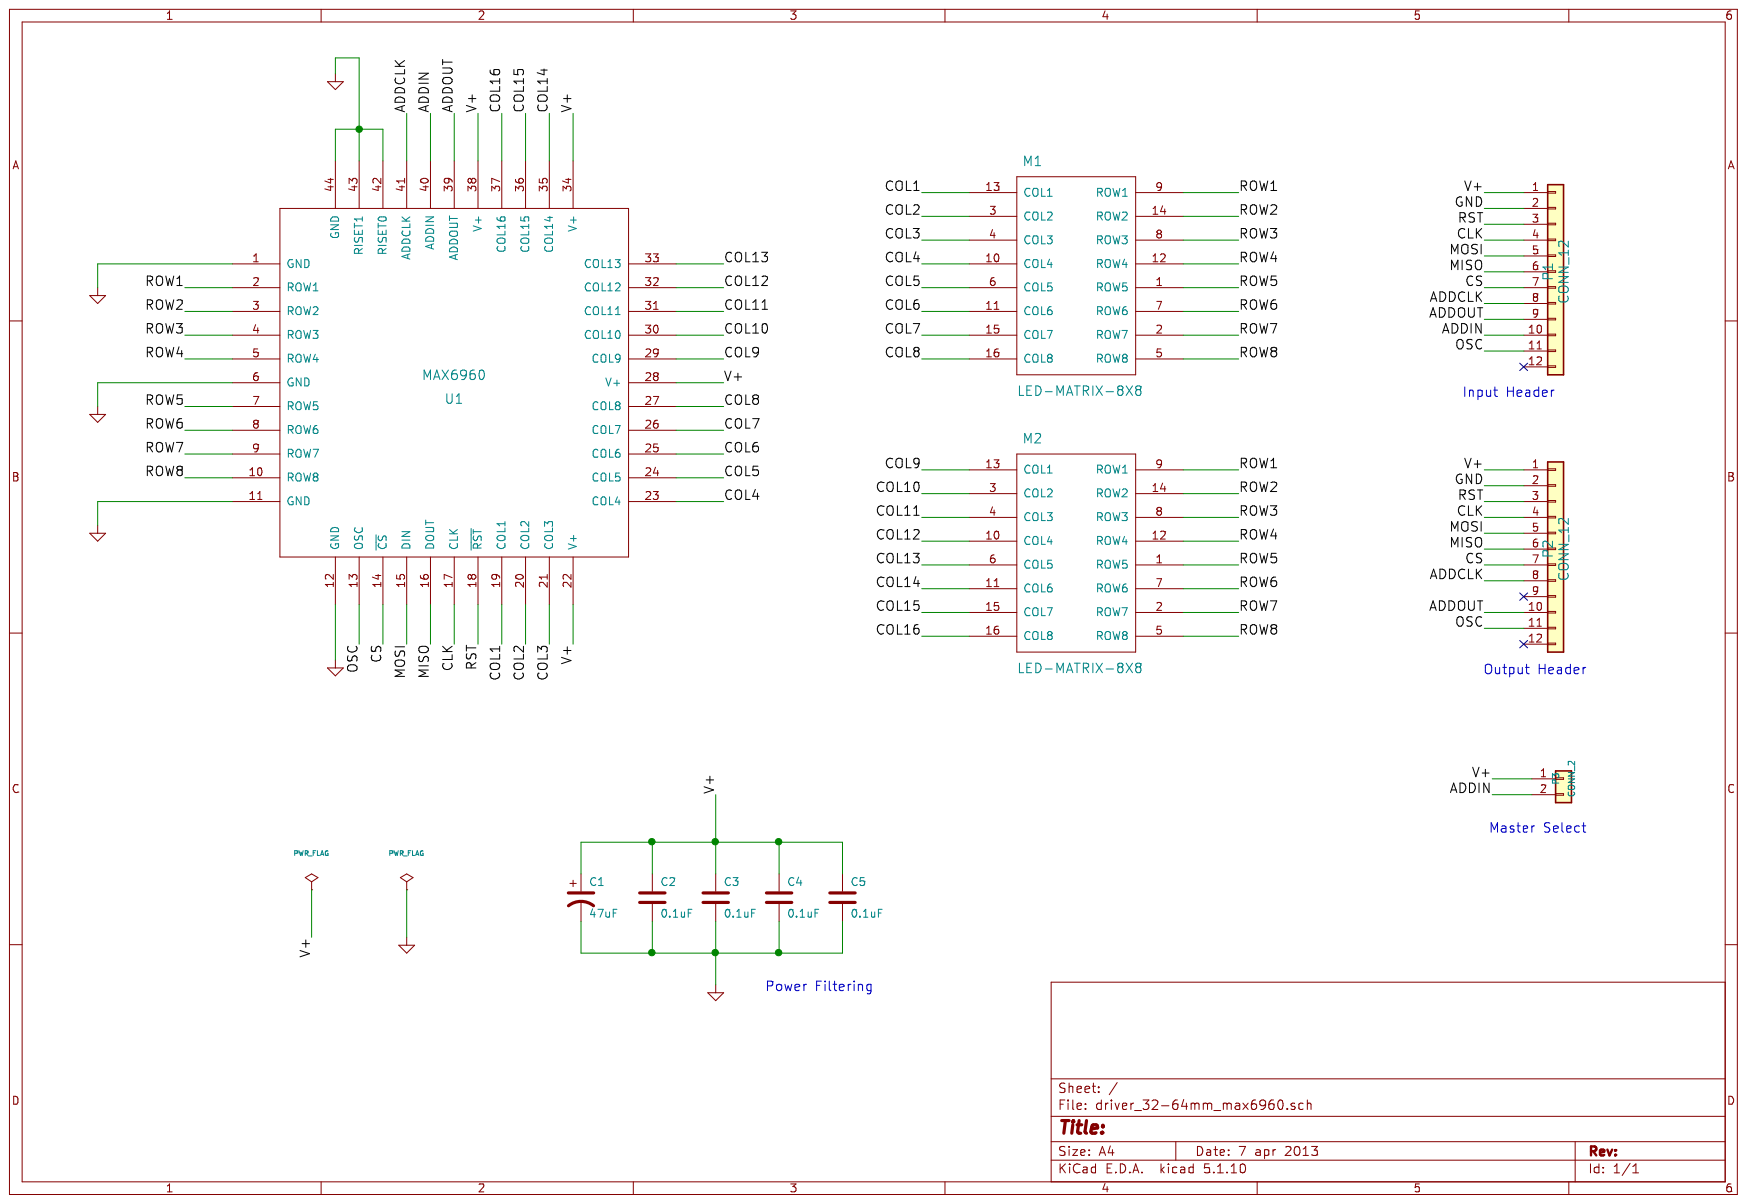
[picture p57: page 1]
