floesche/LED-Display_G4_Hardware_Driver/docs/assets/adapter_32mm-32mm_v0p1_schematic.pdf

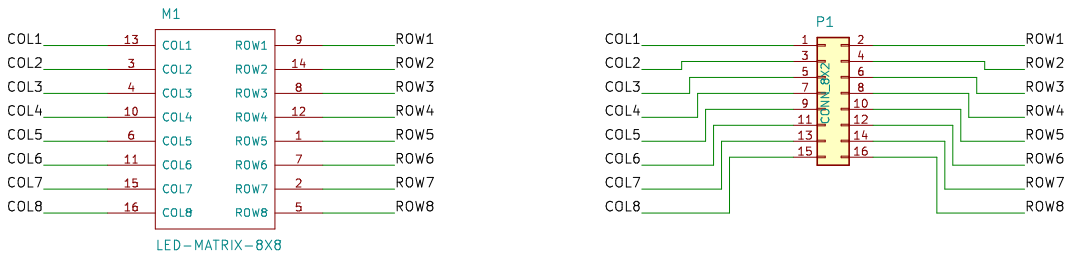
[picture p58: page 1]
