floesche/LED-Display_G4_Hardware_Driver/docs/assets/adapter_20mm-40mm_v0p1_schematic.pdf

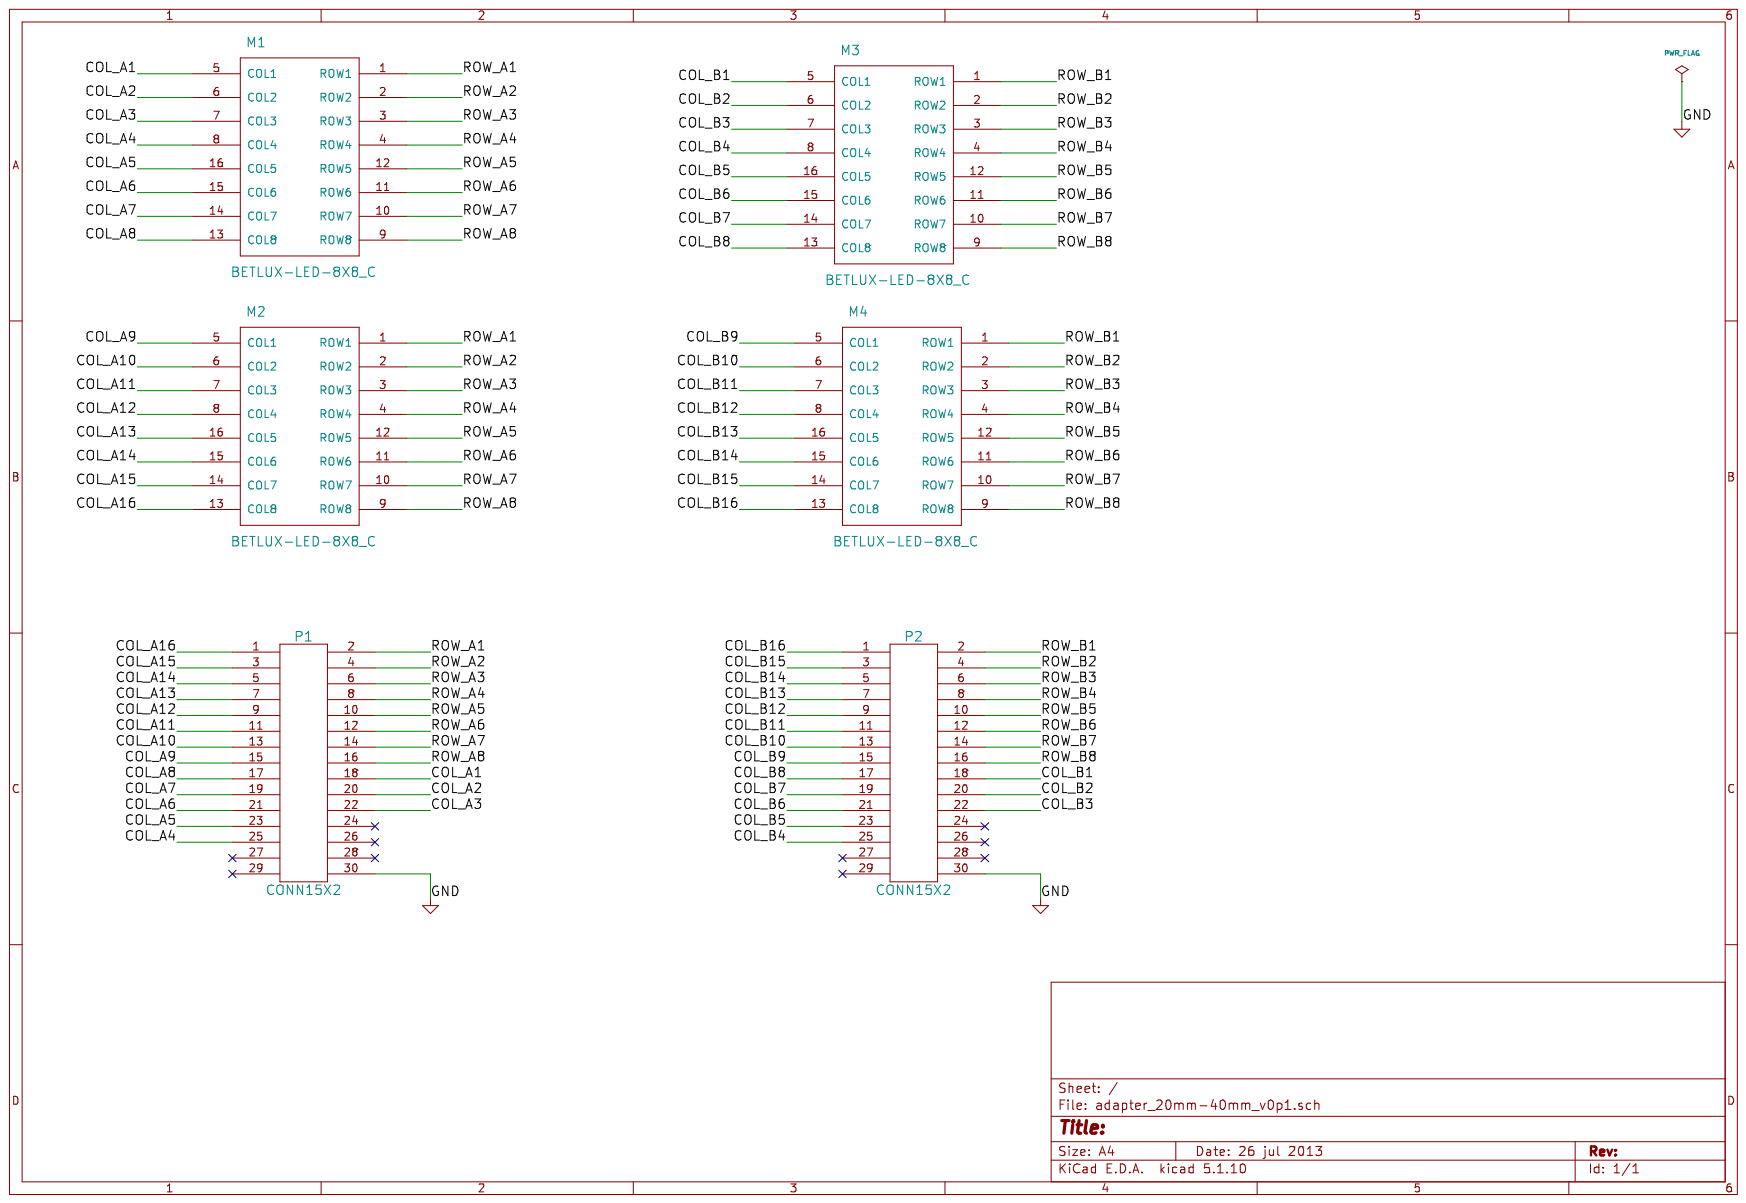
[picture p60: page 1]
