floesche/LED-Display_G4_Hardware_Driver/docs/assets/adapter_20mm-40mm_v0p2_schematic.pdf

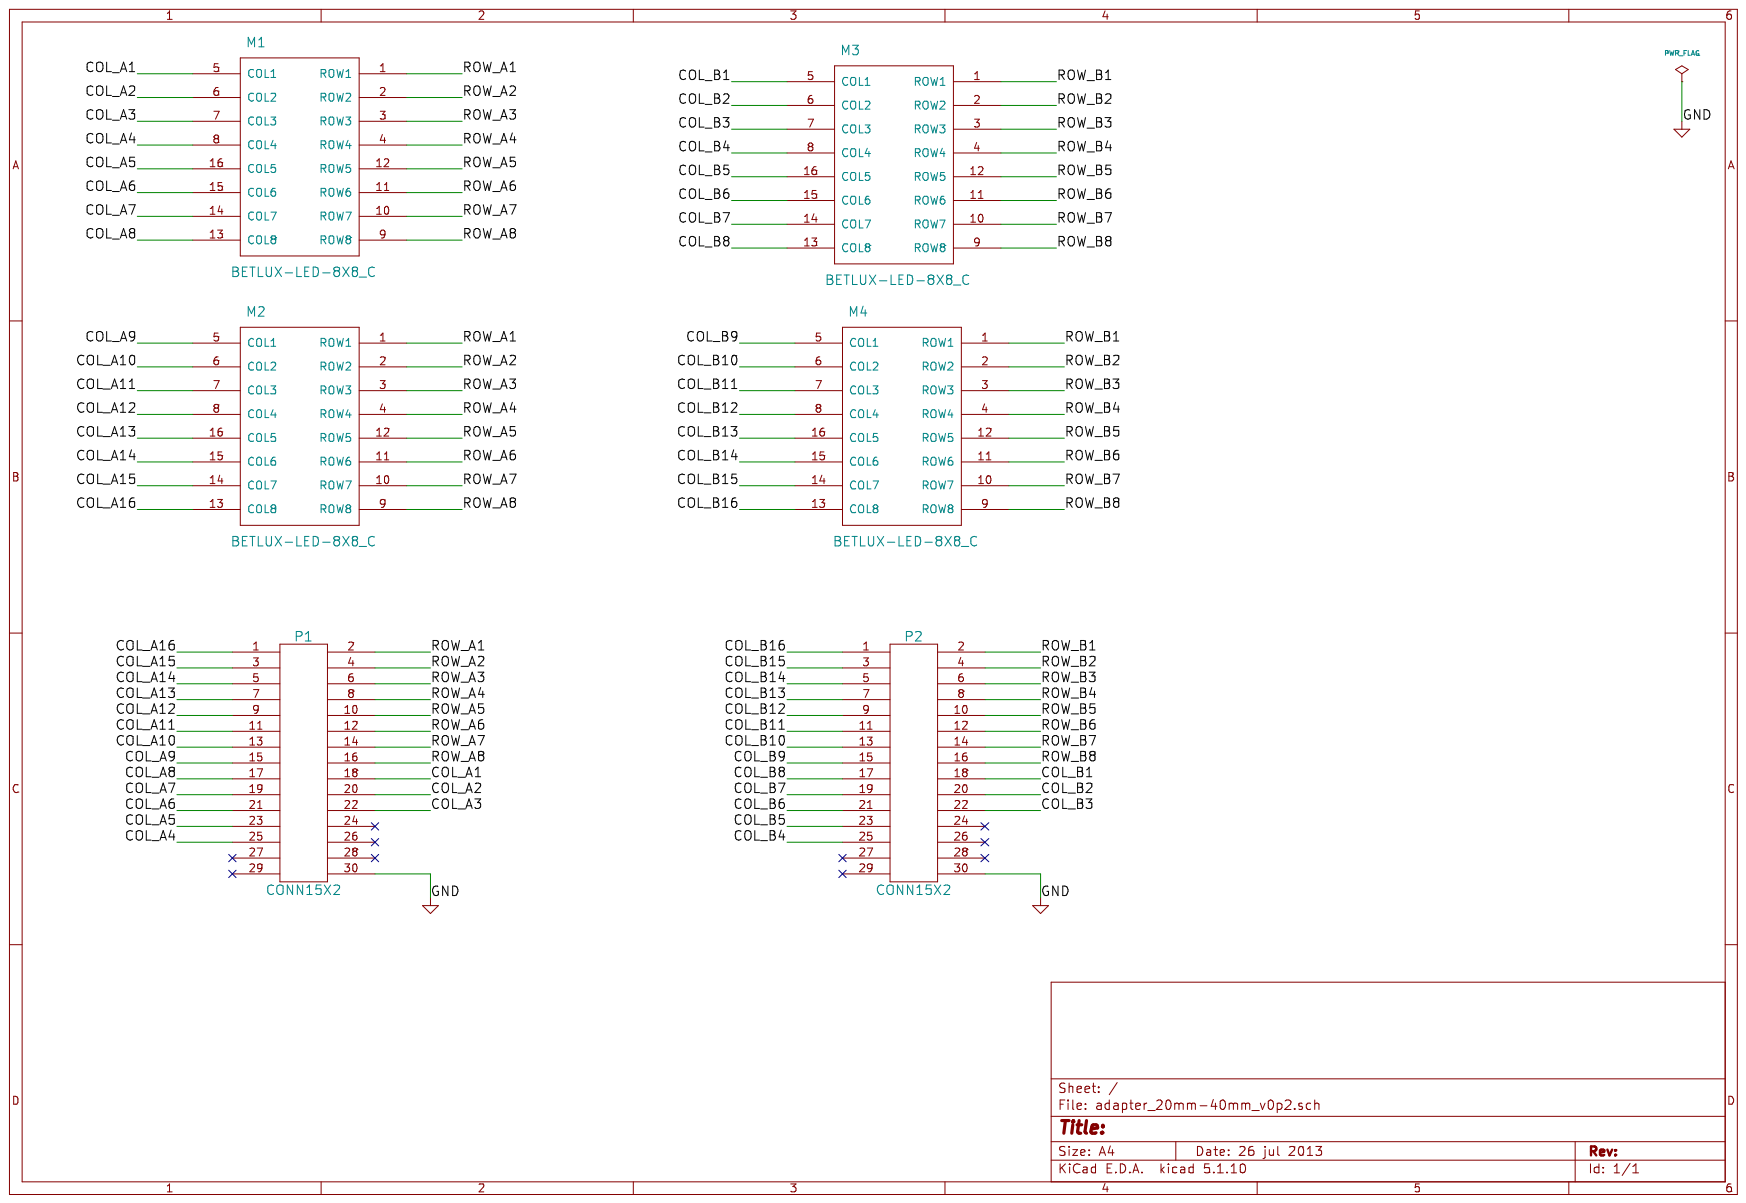
[picture p61: page 1]
