floesche/LED-Display_G4_Hardware_Driver/docs/assets/adapter_32mm-64mm_v0p1_schematic.pdf

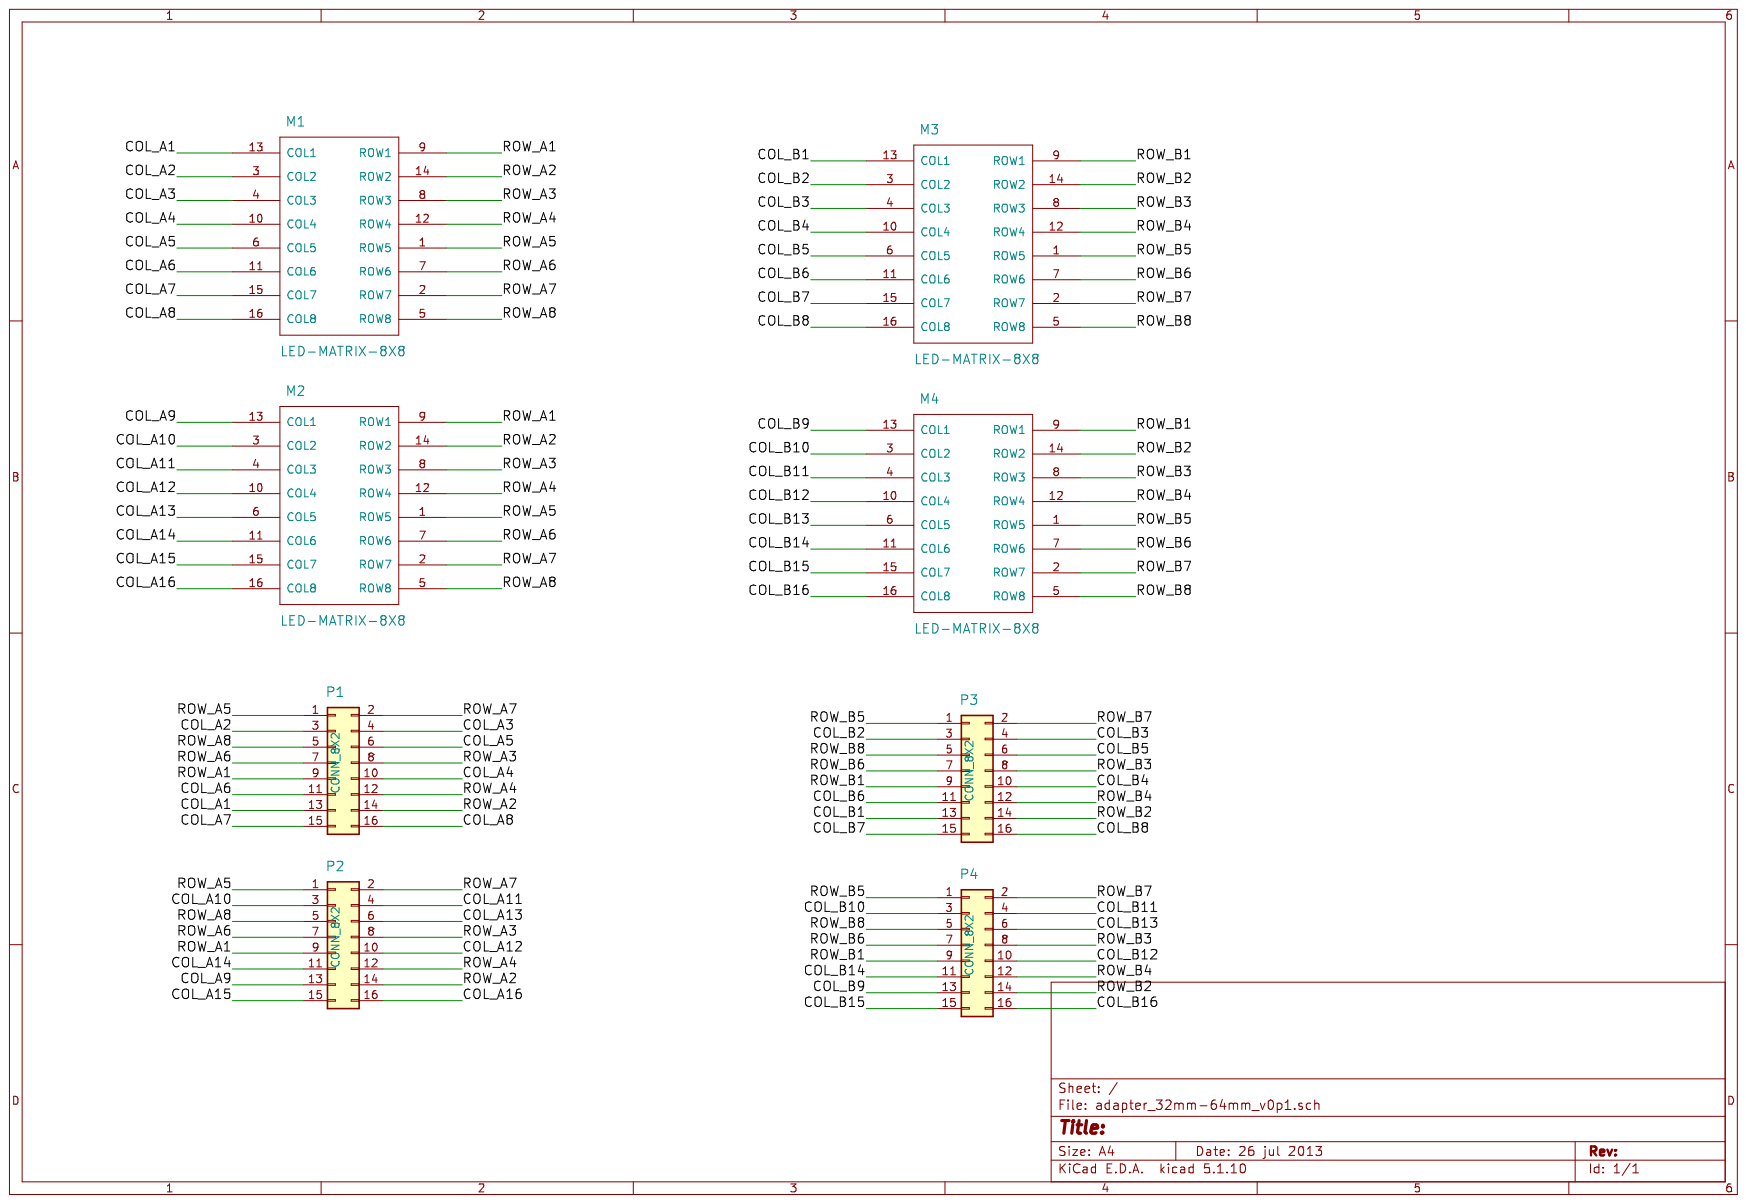
[picture p62: page 1]
