floesche/LED-Display_G4_Hardware_Driver/docs/assets/driver_40mm_max6960_v0p1_schematic.pdf

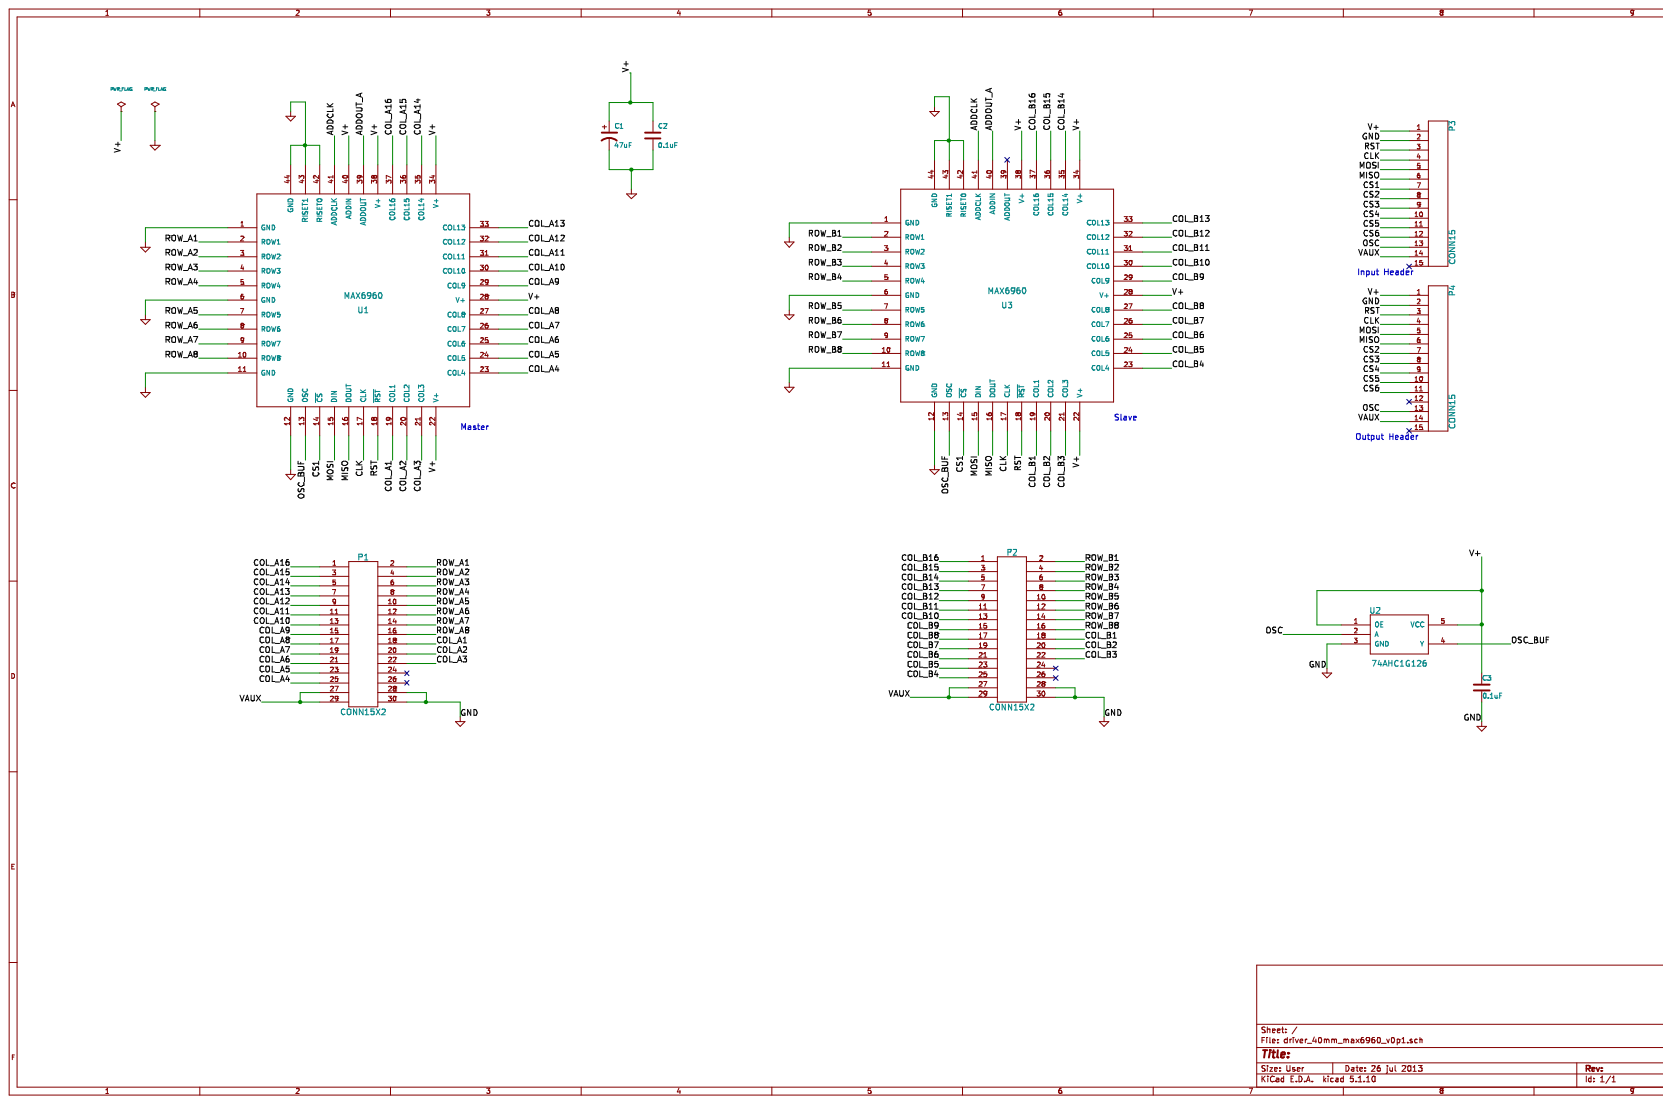
[picture p63: page 1]
