floesche/LED-Display_G4_Hardware_Driver/docs/assets/driver_64mm_max6960_v0p1_schematic.pdf

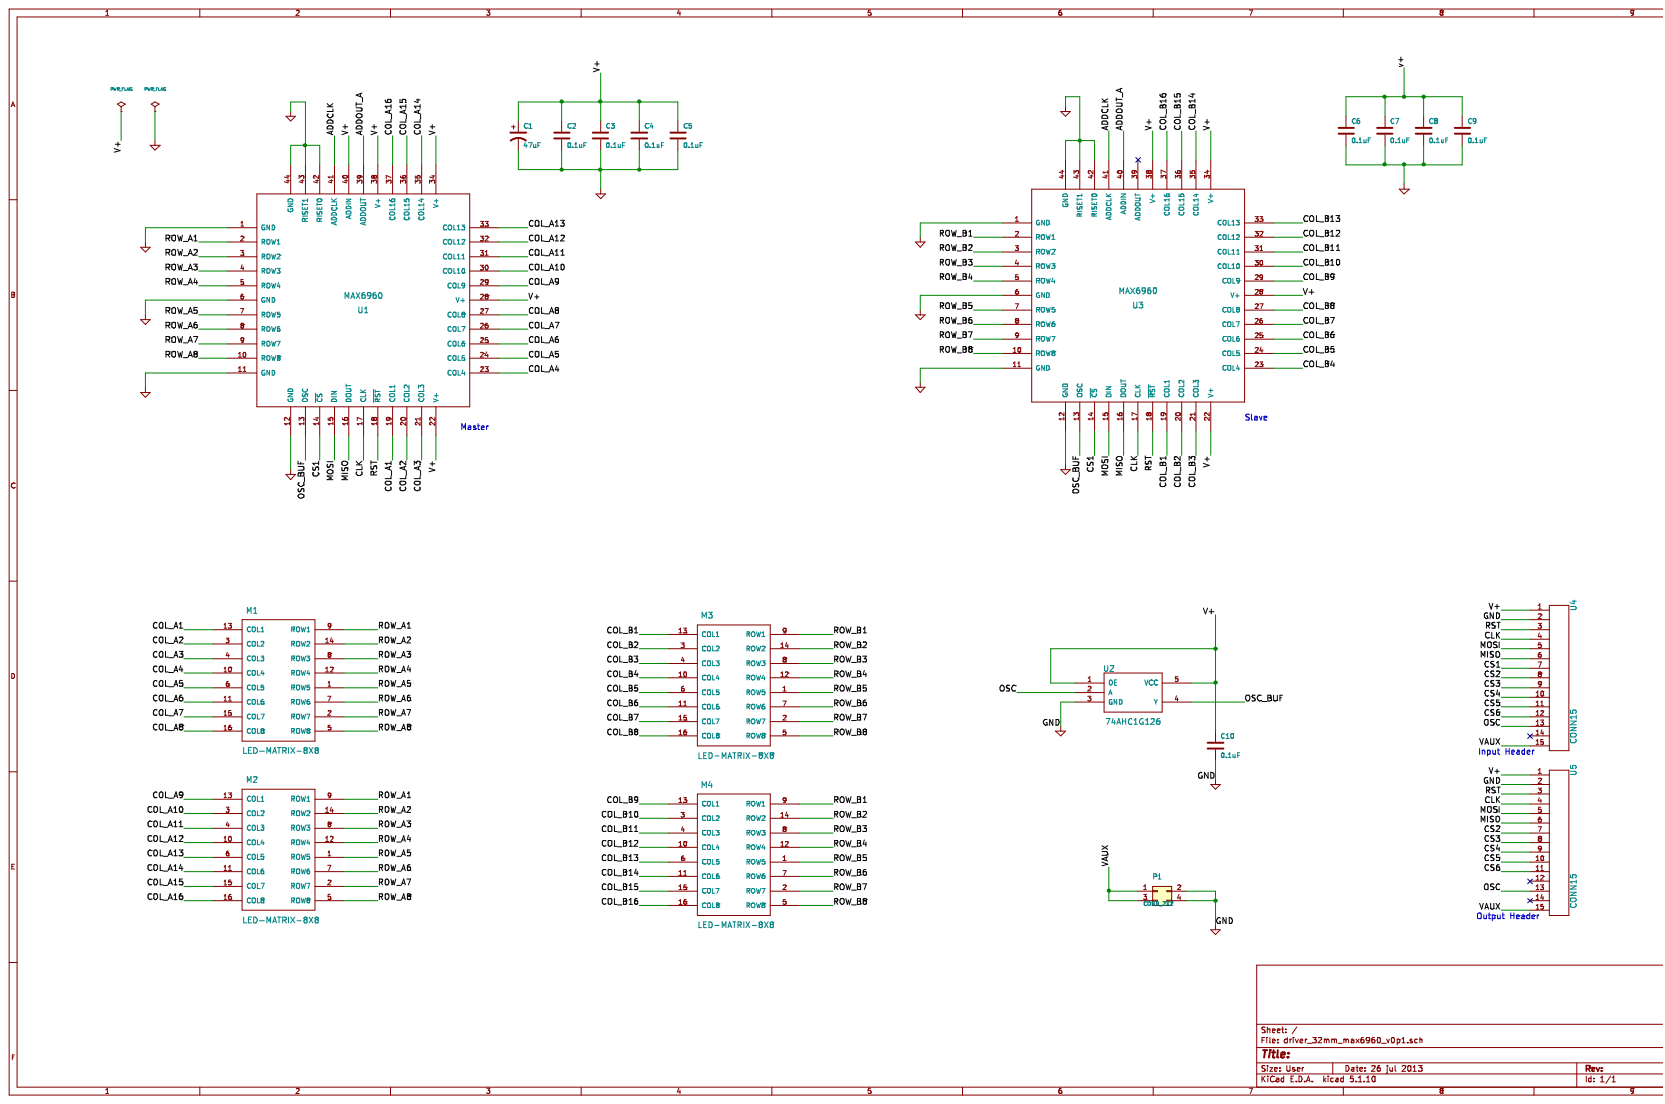
[picture p64: page 1]
