floesche/LED-Display_G4_Hardware_Driver/docs/assets/driver_32mm_atmega_v0p2_schematic.pdf

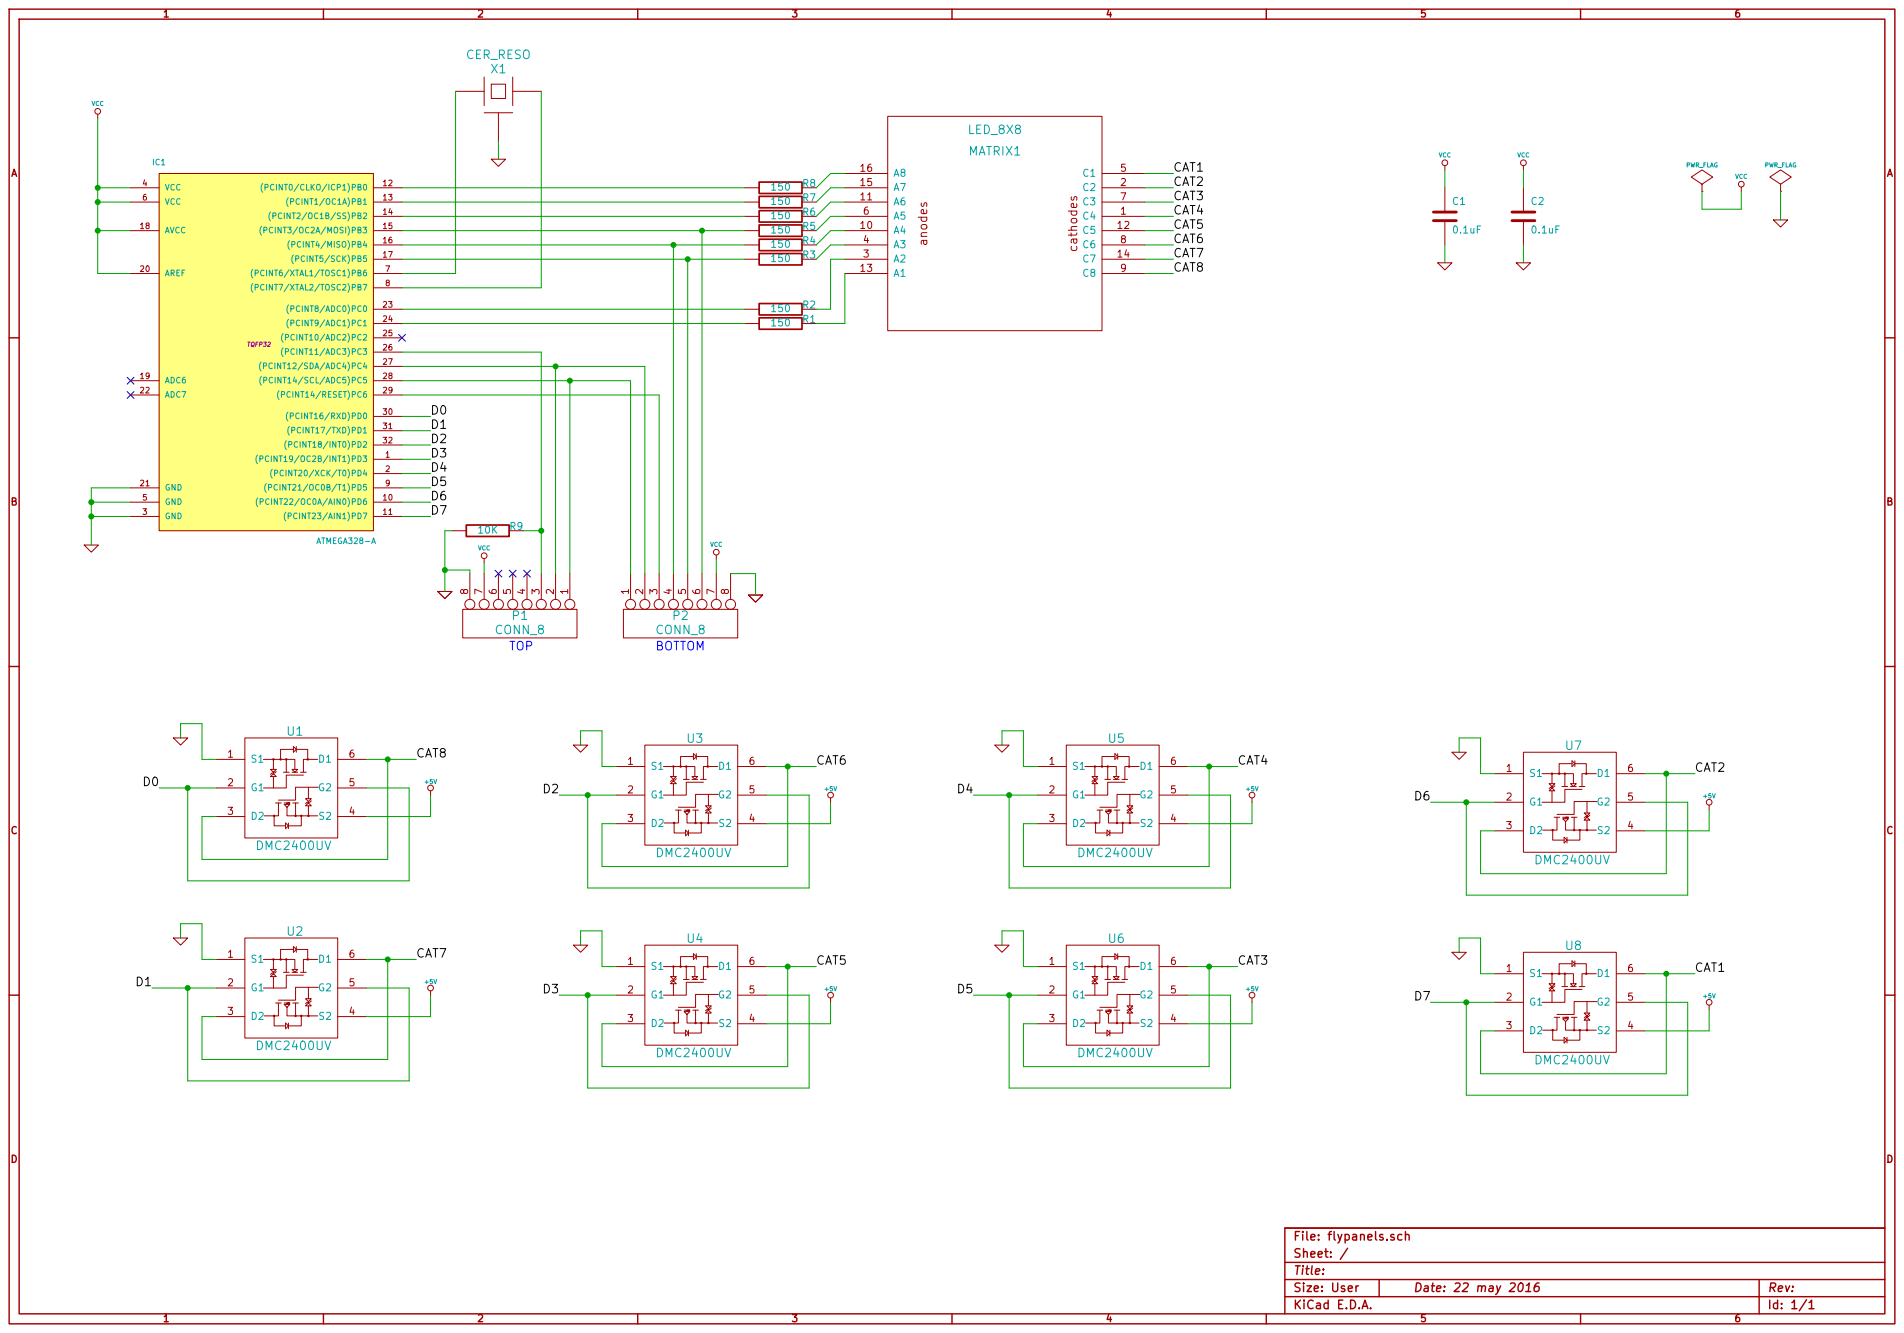
[picture p65: page 1]

Id: 1/1 Title: File: flypanels.sch
Sheet: /
