floesche/LED-Display_G4_Hardware_Driver/driver_32-64mm_max6960_v0/adapter_32-32mm-32-64mm-D/adapter_32-32mm-32-64mm-D.kicad_pcb

## KiCad design driver_32-64mm_max6960_v0/adapter_32-32mm-32-64mm-D/adapter_32-32mm-32-64mm-D.kicad_pcb (2021-11-16)

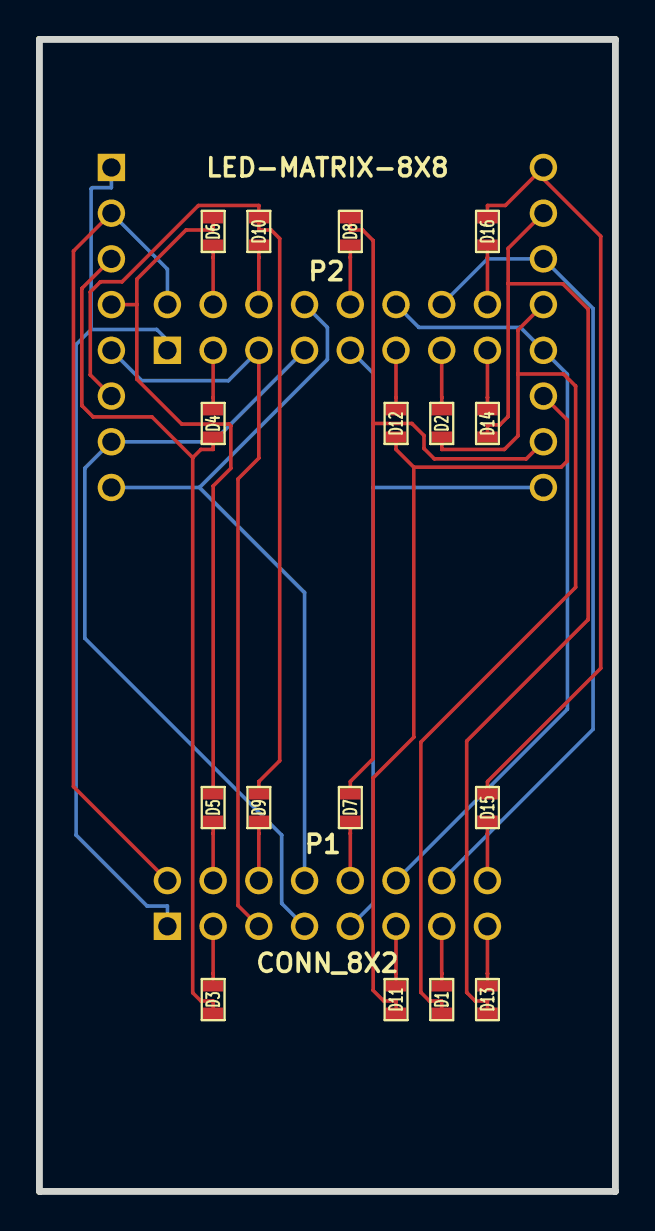
[picture p67: board adapter_32-32mm-32-64mm-D.kicad_pcb from above]

Board: 2 copper layers, 32.0 x 64.0 mm, 19 parts (0 on the bottom side), 32 nets.

Parts:
D1, D2, D3, D4, D5, D6, D7, D8, D9, D10, D11, D12, D13, D14, D15, D16: DIODE; SM0603
M1: LED-MATRIX-8X8; LED_8x8
P1, P2: CONN_8X2; pin_array_8x2_custom

Connections:
/COL1: D1.1, P1.13
/COL2: D3.1, P1.3
/COL3: D5.1, P1.4
/COL4: D7.1, P1.10
/COL5: D9.1, P1.6
/COL6: D11.1, P1.11
/COL7: D13.1, P1.15
/COL8: D15.1, P1.16
/COL9: D2.1, P2.13
/COL10: D4.1, P2.3
/COL11: D6.1, P2.4
/COL12: D8.1, P2.10
/COL13: D10.1, P2.6
/COL14: D12.1, P2.11
/COL15: D14.1, P2.15
/COL16: D16.1, P2.16
/ROW1: M1.9, P1.9, P2.9
/ROW2: M1.14, P1.14, P2.14
/ROW3: M1.8, P1.8, P2.8
/ROW4: M1.12, P1.12, P2.12
/ROW5: M1.1, P1.1, P2.1
/ROW6: M1.7, P1.7, P2.7
/ROW7: M1.2, P1.2, P2.2
/ROW8: M1.5, P1.5, P2.5
unnamed: D5.2, D6.2, M1.4
unnamed: D15.2, D16.2, M1.16
unnamed: D13.2, D14.2, M1.15
unnamed: D11.2, D12.2, M1.11
unnamed: D7.2, D8.2, M1.10
unnamed: D3.2, D4.2, M1.3
unnamed: D1.2, D2.2, M1.13
unnamed: D9.2, D10.2, M1.6
