floesche/LED-Display_G4_Hardware_Driver/driver_32-64mm_max6960_v0/adapter_32-64mm-32-64mm/adapter_32-64mm-32-64mm.kicad_pcb

## KiCad design driver_32-64mm_max6960_v0/adapter_32-64mm-32-64mm/adapter_32-64mm-32-64mm.kicad_pcb (2021-11-16)

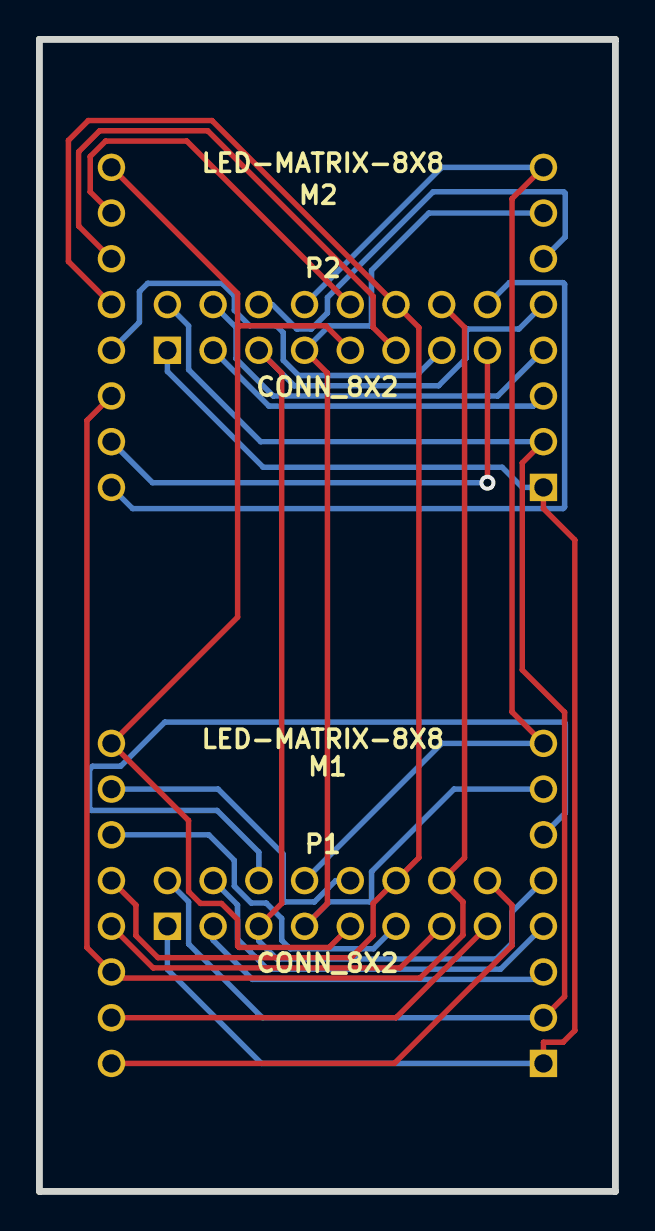
[picture p68: board adapter_32-64mm-32-64mm.kicad_pcb from above]

Board: 2 copper layers, 32.0 x 64.0 mm, 4 parts (0 on the bottom side), 24 nets.

Parts:
M1, M2: LED-MATRIX-8X8; LED_8x8
P1, P2: CONN_8X2; pin_array_8x2_custom

Connections:
/COL1: M1.13, P1.13
/COL2: M1.3, P1.3
/COL3: M1.4, P1.4
/COL4: M1.10, P1.10
/COL5: M1.6, P1.6
/COL6: M1.11, P1.11
/COL7: M1.15, P1.15
/COL8: M1.16, P1.16
/COL9: M2.13, P2.13
/COL10: M2.3, P2.3
/COL11: M2.4, P2.4
/COL12: M2.10, P2.10
/COL13: M2.6, P2.6
/COL14: M2.11, P2.11
/COL15: M2.15, P2.15
/COL16: M2.16, P2.16
/ROW1: M1.9, M2.9, P1.9, P2.9
/ROW2: M1.14, M2.14, P1.14, P2.14
/ROW3: M1.8, M2.8, P1.8, P2.8
/ROW4: M1.12, M2.12, P1.12, P2.12
/ROW5: M1.1, M2.1, P1.1, P2.1
/ROW6: M1.7, M2.7, P1.7, P2.7
/ROW7: M1.2, M2.2, P1.2, P2.2
/ROW8: M1.5, M2.5, P1.5, P2.5
