floesche/LED-Display_G4_Hardware_Driver/driver_32-64mm_max6960_v0/driver_32-64mm_max6960.kicad_pcb

## KiCad design driver_32-64mm_max6960_v0/driver_32-64mm_max6960.kicad_pcb (2021-11-16)

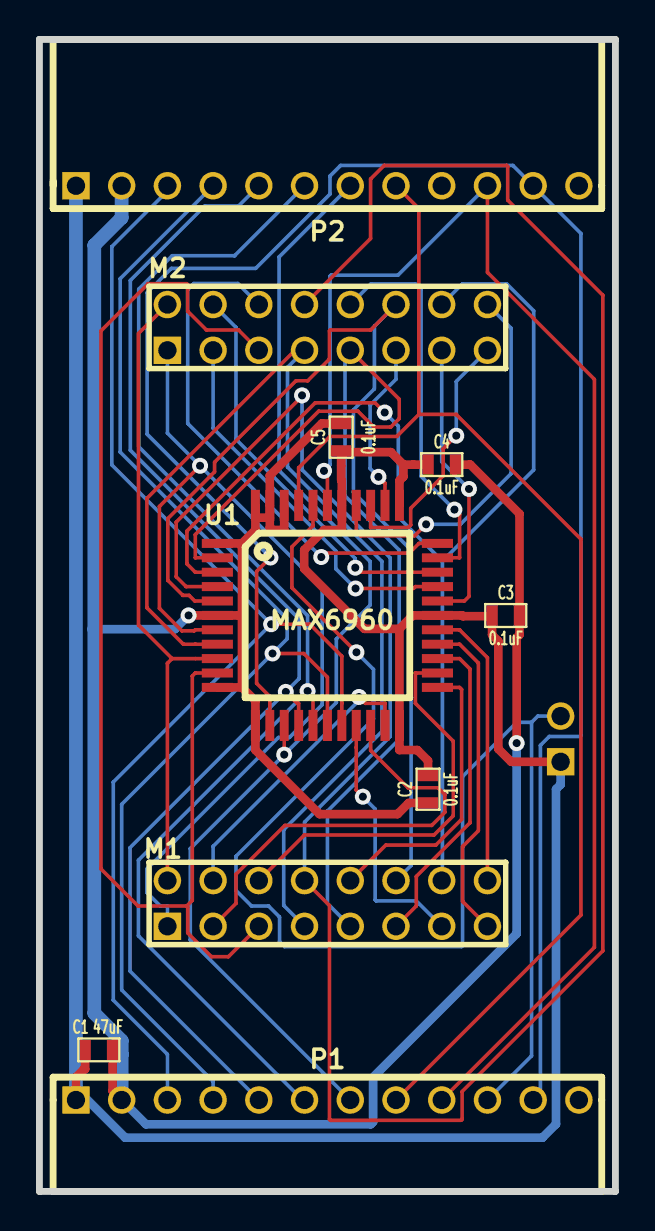
[picture p69: board driver_32-64mm_max6960.kicad_pcb from above]

Board: 2 copper layers, 32.0 x 64.0 mm, 11 parts (1 on the bottom side), 35 nets.

Parts:
C1: 47uF; SM0603
C2, C3, C4, C5: 0.1uF; SM0603
M1, M2: LED-MATRIX-8X8; pin_array_8x2
P1: CONN_12; HEADER_BOT
P2: CONN_12; HEADER_TOP
P3: CONN_2; PIN_ARRAY_2X1
U1: MAX6960; MQFP44

Connections:
/ADDCLK: P1.8, P2.8, U1.41
/ADDIN: P1.10, P3.2, U1.40
/ADDOUT: P1.9, P2.10, U1.39
/CLK: P1.4, P2.4, U1.17
/COL1: M1.13, U1.19
/COL2: M1.3, U1.20
/COL3: M1.4, U1.21
/COL4: M1.10, U1.23
/COL5: M1.6, U1.24
/COL6: M1.11, U1.25
/COL7: M1.15, U1.26
/COL8: M1.16, U1.27
/COL9: M2.13, U1.29
/COL10: M2.3, U1.30
/COL11: M2.4, U1.31
/COL12: M2.10, U1.32
/COL13: M2.6, U1.33
/COL14: M2.11, U1.35
/COL15: M2.15, U1.36
/COL16: M2.16, U1.37
/CS: P1.7, P2.7, U1.14
/MISO: P1.6, P2.6, U1.16
/MOSI: P1.5, P2.5, U1.15
/OSC: P1.11, P2.11, U1.13
/ROW1: M1.9, M2.9, U1.2
/ROW2: M1.14, M2.14, U1.3
/ROW3: M1.8, M2.8, U1.4
/ROW4: M1.12, M2.12, U1.5
/ROW5: M1.1, M2.1, U1.7
/ROW6: M1.7, M2.7, U1.8
/ROW7: M1.2, M2.2, U1.9
/ROW8: M1.5, M2.5, U1.10
/RST: P1.3, P2.3, U1.18
/V+: C1.1, C2.1, C3.1, C4.1, C5.1, P1.1, P2.1, P3.1, U1.22, U1.28, U1.34, U1.38
GND: C1.2, C2.2, C3.2, C4.2, C5.2, P1.2, P2.2, U1.1, U1.6, U1.11, U1.12, U1.42, U1.43, U1.44
