floesche/LED-Display_G4_Hardware_Driver/driver_32mm_max6960_v0/driver_32mm_max6960.kicad_pcb

## KiCad design driver_32mm_max6960_v0/driver_32mm_max6960.kicad_pcb (2021-11-16)

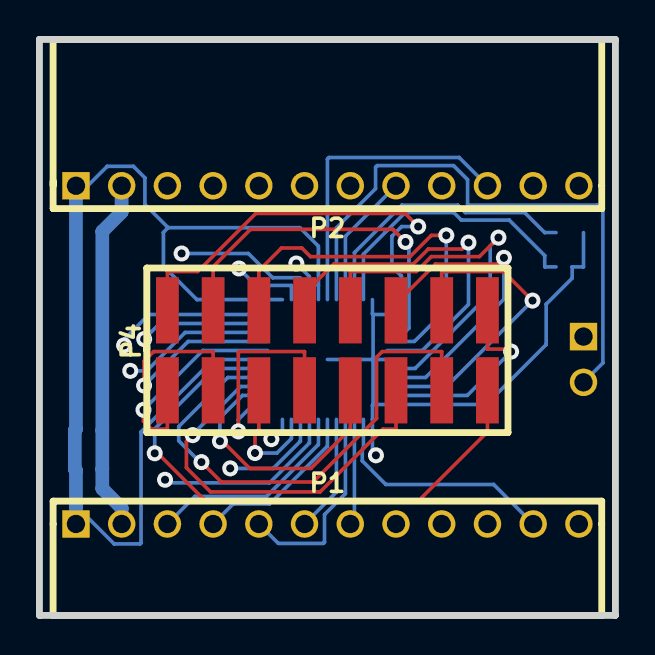
[picture p70: board driver_32mm_max6960.kicad_pcb from above]

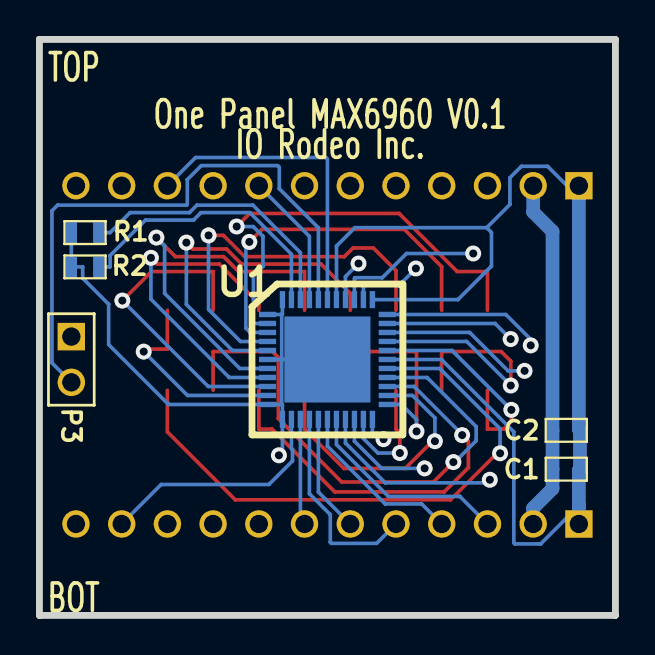
[picture p71: board driver_32mm_max6960.kicad_pcb from below]

Board: 4 copper layers, 32.0 x 32.0 mm, 9 parts (6 on the bottom side), 29 nets.

Parts:
C1: 47uF; SM0603
C2: 0.1uF; SM0603
P1: CONN_12; HEADER_BOT
P2: CONN_12; HEADER_TOP
P3: CONN_2; PIN_ARRAY_2X1
P4: CONN_8X2; SMD_HEADER_8X2
R1, R2: R; SM0603
U1: MAX6960; T4477-3

Connections:
/ADDCLK: P1.8, P2.8, U1.41
/ADDIN: P1.10, P3.2, U1.40
/ADDOUT: P1.9, P2.10, U1.39
/CLK: P1.4, P2.4, U1.17
/COL1: P4.1, U1.19, U1.29
/COL10: P4.3, U1.20, U1.30
/COL11: P4.5, U1.21, U1.31
/COL12: P4.7, U1.23, U1.32
/COL13: P4.9, U1.24, U1.33
/COL14: P4.11, U1.25, U1.35
/COL15: P4.13, U1.26, U1.36
/COL16: P4.15, U1.27, U1.37
/CS: P1.7, P2.7, U1.14
/MISO: P1.6, P2.6, U1.16
/MOSI: P1.5, P2.5, U1.15
/OSC: P1.11, P2.11, U1.13
/ROW1: P4.2, U1.2
/ROW2: P4.4, U1.3
/ROW3: P4.6, U1.4
/ROW4: P4.8, U1.5
/ROW5: P4.10, U1.7
/ROW6: P4.12, U1.8
/ROW7: P4.14, U1.9
/ROW8: P4.16, U1.10
/RST: P1.3, P2.3, U1.18
/V+: C1.1, C2.1, P1.1, P2.1, P3.1, U1.22, U1.28, U1.34, U1.38
GND: C1.2, C2.2, P1.2, P2.2, R1.2, R2.2, U1.1, U1.6, U1.11, U1.12, U1.44, U1.45
unnamed: R2.1, U1.43
unnamed: R1.1, U1.42
