floesche/LED-Display_G4_Hardware_Driver/driver_40mm_max6960_v0/adapter_20mm-40mm_v0p2/adapter_20mm-40mm_v0p2.kicad_pcb

## KiCad design driver_40mm_max6960_v0/adapter_20mm-40mm_v0p2/adapter_20mm-40mm_v0p2.kicad_pcb (2021-11-15)

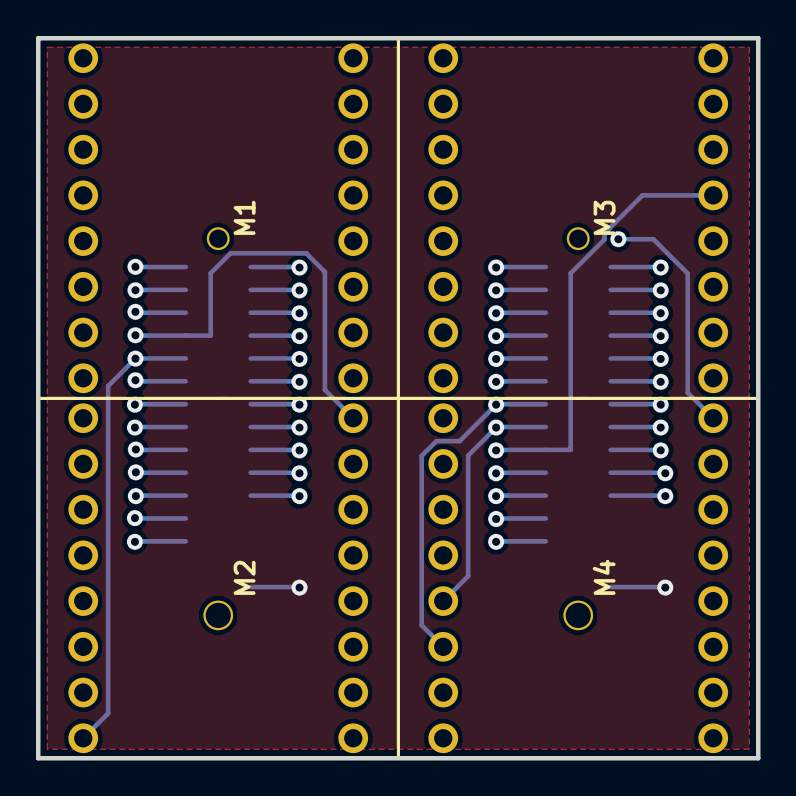
[picture p72: board adapter_20mm-40mm_v0p2.kicad_pcb from above]

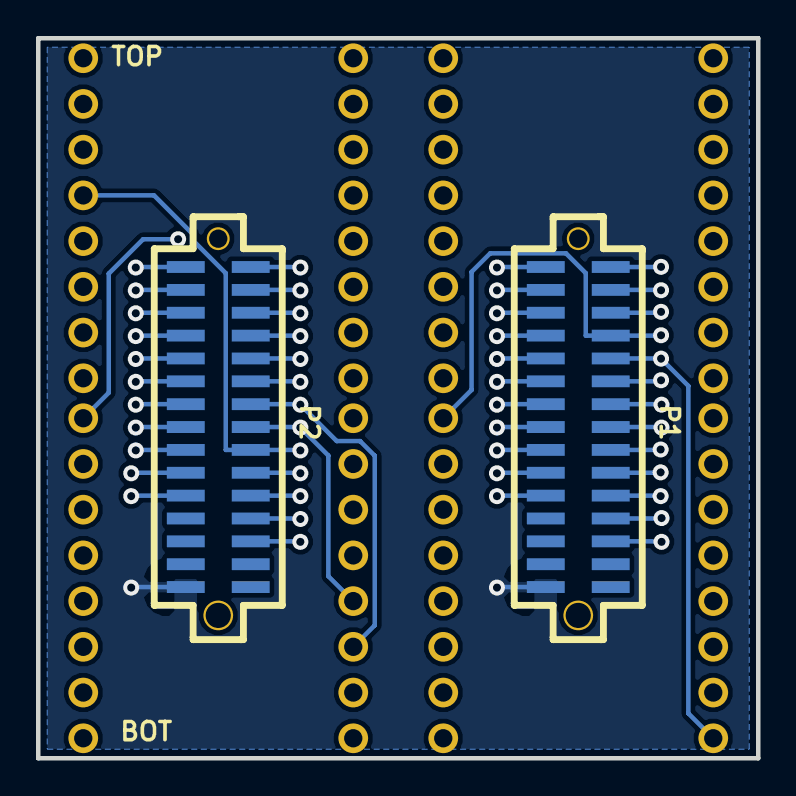
[picture p73: board adapter_20mm-40mm_v0p2.kicad_pcb from below]

Board: 4 copper layers, 40.0 x 40.0 mm, 6 parts (2 on the bottom side), 49 nets.

Parts:
M1, M2, M3, M4: BETLUX-LED-8X8_C; LED_MATRIX_20MM_8x8
P1, P2: CONN15X2; SMD_PIN_ARRAY_F_0P5IN_15X2

Connections:
/COL_A1: M1.5, P1.18
/COL_A2: M1.6, P1.20
/COL_A3: M1.7, P1.22
/COL_A4: M1.8, P1.25
/COL_A5: M1.16, P1.23
/COL_A6: M1.15, P1.21
/COL_A7: M1.14, P1.19
/COL_A8: M1.13, P1.17
/COL_A9: M2.5, P1.15
/COL_A10: M2.6, P1.13
/COL_A11: M2.7, P1.11
/COL_A12: M2.8, P1.9
/COL_A13: M2.16, P1.7
/COL_A14: M2.15, P1.5
/COL_A15: M2.14, P1.3
/COL_A16: M2.13, P1.1
/COL_B1: M3.5, P2.18
/COL_B2: M3.6, P2.20
/COL_B3: M3.7, P2.22
/COL_B4: M3.8, P2.25
/COL_B5: M3.16, P2.23
/COL_B6: M3.15, P2.21
/COL_B7: M3.14, P2.19
/COL_B8: M3.13, P2.17
/COL_B9: M4.5, P2.15
/COL_B10: M4.6, P2.13
/COL_B11: M4.7, P2.11
/COL_B12: M4.8, P2.9
/COL_B13: M4.16, P2.7
/COL_B14: M4.15, P2.5
/COL_B15: M4.14, P2.3
/COL_B16: M4.13, P2.1
/ROW_A1: M1.1, M2.1, P1.2
/ROW_A2: M1.2, M2.2, P1.4
/ROW_A3: M1.3, M2.3, P1.6
/ROW_A4: M1.4, M2.4, P1.8
/ROW_A5: M1.12, M2.12, P1.10
/ROW_A6: M1.11, M2.11, P1.12
/ROW_A7: M1.10, M2.10, P1.14
/ROW_A8: M1.9, M2.9, P1.16
/ROW_B1: M3.1, M4.1, P2.2
/ROW_B2: M3.2, M4.2, P2.4
/ROW_B3: M3.3, M4.3, P2.6
/ROW_B4: M3.4, M4.4, P2.8
/ROW_B5: M3.12, M4.12, P2.10
/ROW_B6: M3.11, M4.11, P2.12
/ROW_B7: M3.10, M4.10, P2.14
/ROW_B8: M3.9, M4.9, P2.16
GND: P1.30, P2.30
