floesche/LED-Display_G4_Hardware_Driver/driver_40mm_max6960_v0/driver_40mm_max6960_v0p1.kicad_pcb

## KiCad design driver_40mm_max6960_v0/driver_40mm_max6960_v0p1.kicad_pcb (2021-11-15)

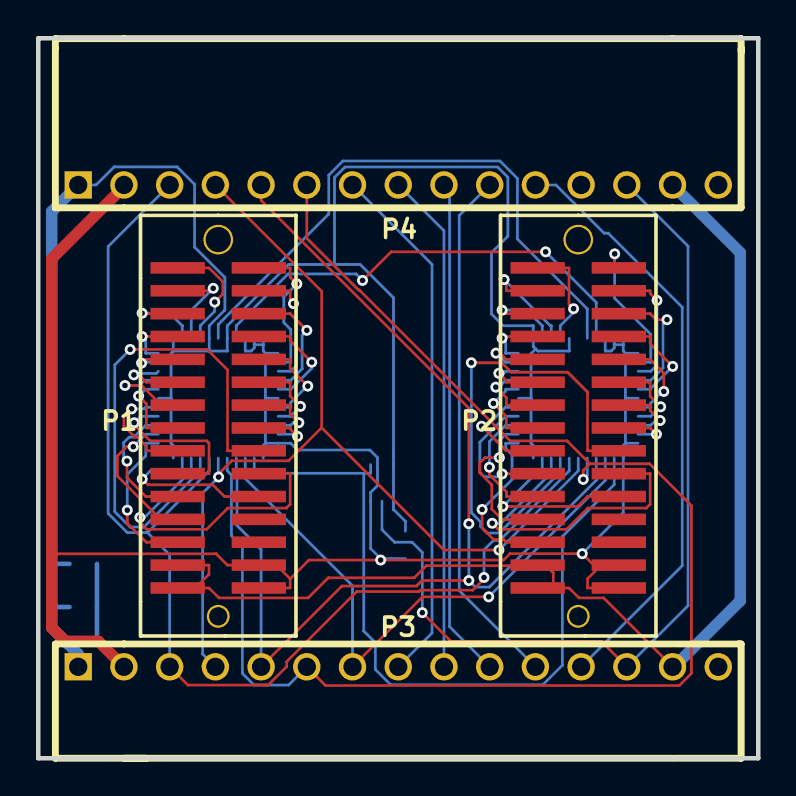
[picture p74: board driver_40mm_max6960_v0p1.kicad_pcb from above]

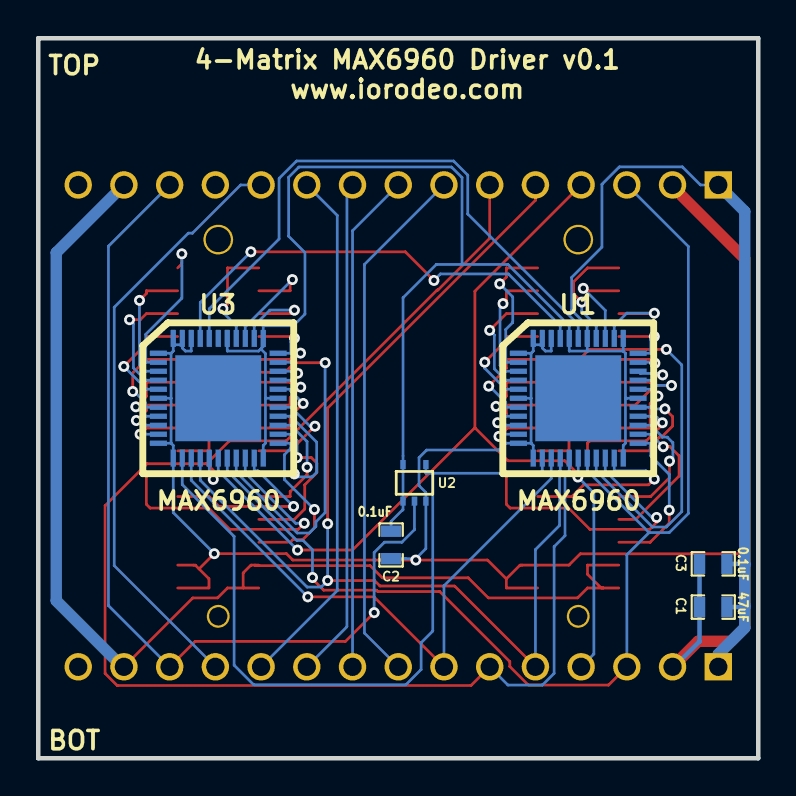
[picture p75: board driver_40mm_max6960_v0p1.kicad_pcb from below]

Board: 2 copper layers, 40.0 x 40.0 mm, 10 parts (6 on the bottom side), 65 nets.

Parts:
C1: 47uF; SM0603_Capa
C2, C3: 0.1uF; SM0603_Capa
P1, P2: CONN15X2; SMD_PIN_ARRAY_M_0P5IN_15X2
P3: CONN15; HEADER_BOT
P4: CONN15; HEADER_TOP
U1, U3: MAX6960; T4477-3
U2: 74AHC1G126; SOT353

Connections:
/ADDCLK: U1.41, U3.41
/ADDOUT_A: U1.39, U3.40
/CLK: P3.4, P4.4, U1.17, U3.17
/COL_A1: P1.18, U1.19
/COL_A2: P1.20, U1.20
/COL_A3: P1.22, U1.21
/COL_A4: P1.25, U1.23
/COL_A5: P1.23, U1.24
/COL_A6: P1.21, U1.25
/COL_A7: P1.19, U1.26
/COL_A8: P1.17, U1.27
/COL_A9: P1.15, U1.29
/COL_A10: P1.13, U1.30
/COL_A11: P1.11, U1.31
/COL_A12: P1.9, U1.32
/COL_A13: P1.7, U1.33
/COL_A14: P1.5, U1.35
/COL_A15: P1.3, U1.36
/COL_A16: P1.1, U1.37
/COL_B1: P2.18, U3.19
/COL_B2: P2.20, U3.20
/COL_B3: P2.22, U3.21
/COL_B4: P2.25, U3.23
/COL_B5: P2.23, U3.24
/COL_B6: P2.21, U3.25
/COL_B7: P2.19, U3.26
/COL_B8: P2.17, U3.27
/COL_B9: P2.15, U3.29
/COL_B10: P2.13, U3.30
/COL_B11: P2.11, U3.31
/COL_B12: P2.9, U3.32
/COL_B13: P2.7, U3.33
/COL_B14: P2.5, U3.35
/COL_B15: P2.3, U3.36
/COL_B16: P2.1, U3.37
/CS1: P3.7, U1.14, U3.14
/CS2: P3.8, P4.7
/CS3: P3.9, P4.8
/CS4: P3.10, P4.9
/CS5: P3.11, P4.10
/CS6: P3.12, P4.11
/MISO: P3.6, P4.6, U1.16, U3.16
/MOSI: P3.5, P4.5, U1.15, U3.15
/OSC: P3.13, P4.13, U2.2
/OSC_BUF: U1.13, U2.4, U3.13
/ROW_A1: P1.2, U1.2
/ROW_A2: P1.4, U1.3
/ROW_A3: P1.6, U1.4
/ROW_A4: P1.8, U1.5
/ROW_A5: P1.10, U1.7
/ROW_A6: P1.12, U1.8
/ROW_A7: P1.14, U1.9
/ROW_A8: P1.16, U1.10
/ROW_B1: P2.2, U3.2
/ROW_B2: P2.4, U3.3
/ROW_B3: P2.6, U3.4
/ROW_B4: P2.8, U3.5
/ROW_B5: P2.10, U3.7
/ROW_B6: P2.12, U3.8
/ROW_B7: P2.14, U3.9
/ROW_B8: P2.16, U3.10
/RST: P3.3, P4.3, U1.18, U3.18
/V+: C1.1, C2.1, C3.1, P3.1, P4.1, U1.22, U1.28, U1.34, U1.38, U1.40, U2.1, U2.5, U3.22, U3.28, U3.34, U3.38
/VAUX: P1.27, P1.29, P2.27, P2.29, P3.14, P4.14
GND: C1.2, C2.2, C3.2, P1.28, P1.30, P2.28, P2.30, P3.2, P4.2, U1.1, U1.6, U1.11, U1.12, U1.42, U1.43, U1.44, U2.3, U3.1, U3.6, U3.11, U3.12, U3.42, U3.43, U3.44
