floesche/LED-Display_G4_Hardware_Driver/driver_32mm_atmega_v0p2/driver_32mm_atmega_v0p2.kicad_pcb

## KiCad design driver_32mm_atmega_v0p2/driver_32mm_atmega_v0p2.kicad_pcb (2021-11-15)

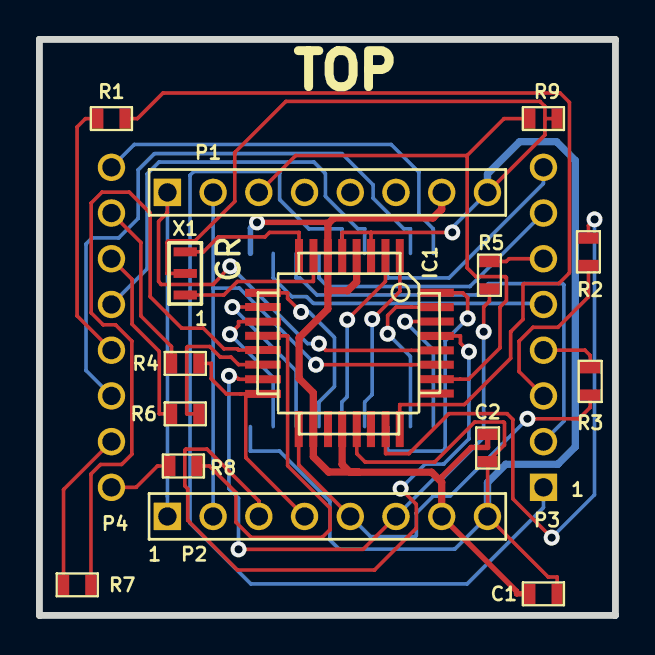
[picture p77: board driver_32mm_atmega_v0p2.kicad_pcb from above]

Board: 2 copper layers, 32.0 x 32.0 mm, 17 parts (1 on the bottom side), 40 nets.

Parts:
C1, C2: 0.1uF; SM0603
IC1: ATMEGA168-A; TQFP32
MATRIX1: LED_8X8; LED_8x8
P1, P2: CONN_8; CONN_8x1
R1, R2, R3, R4, R5, R6, R7, R8: 82; SM0603
R9: 10K; SM0603
U1: ULN2804A; XZL_SOP18
X1: CR; XZL_CR

Connections:
GND: C1.2, C2.2, IC1.3, IC1.5, IC1.21, P1.8, P2.8, R9.2, U1.9, X1.2
unnamed: MATRIX1.3, R2.1
unnamed: IC1.28, P1.1, P2.1
unnamed: MATRIX1.1, U1.14
unnamed: MATRIX1.8, U1.16
unnamed: IC1.27, P1.2, P2.2
unnamed: IC1.16, P2.4, R4.2
unnamed: IC1.15, P2.6, R5.2
unnamed: IC1.2, U1.5
unnamed: IC1.8, X1.3
unnamed: IC1.9, U1.6
unnamed: IC1.10, U1.7
unnamed: IC1.30, U1.1
unnamed: IC1.11, U1.8
unnamed: IC1.31, U1.2
unnamed: IC1.12, R8.2
unnamed: IC1.1, U1.4
unnamed: IC1.32, U1.3
unnamed: IC1.23, R2.2
unnamed: IC1.24, R1.2
unnamed: IC1.26, P1.3, R9.1
unnamed: IC1.29, P2.3
unnamed: MATRIX1.5, U1.11
unnamed: MATRIX1.9, U1.18
unnamed: IC1.14, R6.2
unnamed: MATRIX1.6, R5.1
unnamed: IC1.13, R7.2
unnamed: MATRIX1.4, R3.1
unnamed: MATRIX1.7, U1.13
unnamed: MATRIX1.10, R4.1
unnamed: MATRIX1.11, R6.1
unnamed: MATRIX1.12, U1.15
unnamed: MATRIX1.13, R1.1
unnamed: MATRIX1.14, U1.17
unnamed: MATRIX1.15, R7.1
unnamed: MATRIX1.16, R8.1
unnamed: MATRIX1.2, U1.12
unnamed: IC1.7, X1.1
unnamed: IC1.17, P2.5, R3.2
VCC: C1.1, C2.1, IC1.4, IC1.6, IC1.18, IC1.20, P1.7, P2.7, U1.10
