floesche/LED-Display_G4_Hardware_Driver/driver_40mm_atmega_v0p1/driver_40mm_atmega_v0p1.kicad_pcb

## KiCad design driver_40mm_atmega_v0p1/driver_40mm_atmega_v0p1.kicad_pcb (2021-11-15)

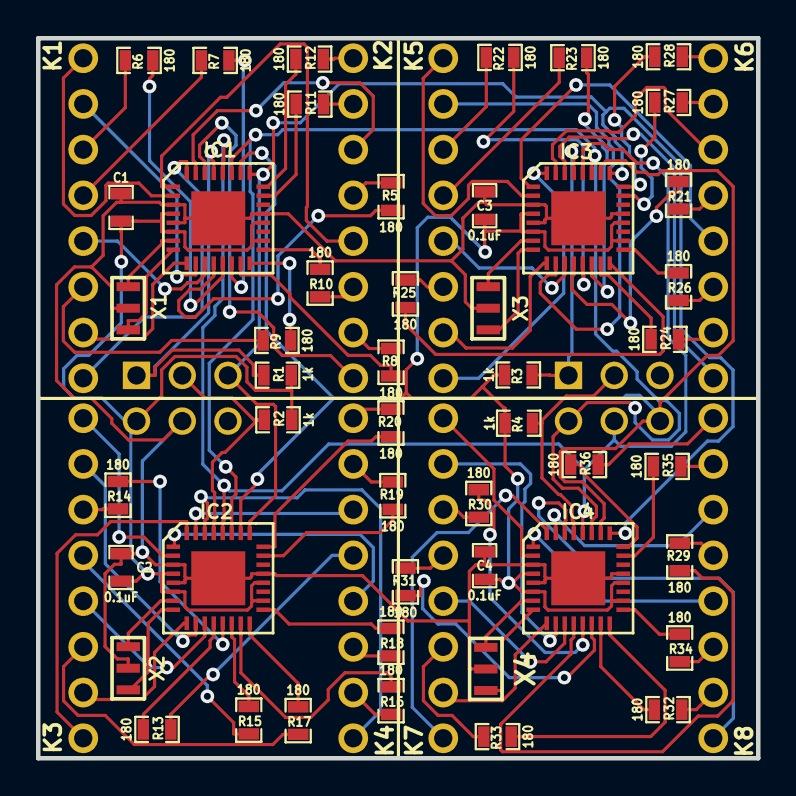
[picture p78: board driver_40mm_atmega_v0p1.kicad_pcb from above]

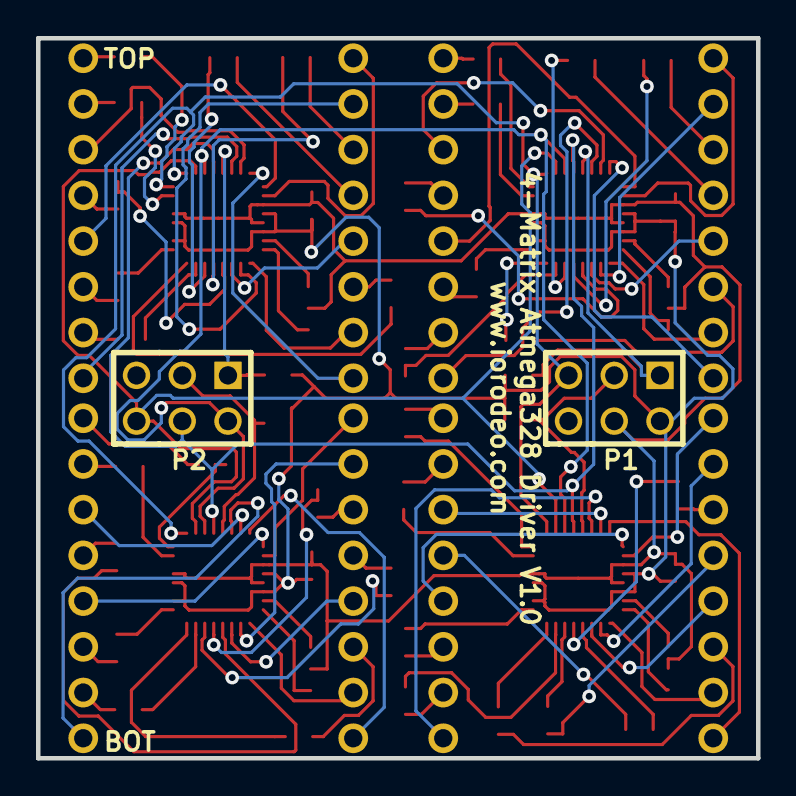
[picture p79: board driver_40mm_atmega_v0p1.kicad_pcb from below]

Board: 2 copper layers, 40.0 x 40.0 mm, 54 parts (2 on the bottom side), 114 nets.

Parts:
C1, C2, C3, C4: 0.1uF; SM0603_Capa
IC1, IC2, IC3, IC4: ATMEGA328P-M; QFN32
MATRIX1, MATRIX2, MATRIX3, MATRIX4: LED_8X8; LED_MATRIX_20MM_8x8
P1, P2: CONN_3X2; PIN_ARRAY_F_3X2
R1, R2, R3, R4: 1k; SM0603_Resistor
R5, R6, R7, R8, R9, R10, R11, R12, R13, R14, R15, R16, R17, R18, R19, R20, R21, R22, R23, R24, R25, R26, R27, R28, R29, R30, R31, R32, R33, R34, R35, R36: 180; SM0603_Resistor
X1, X2, X3, X4: CER_RESO

Connections:
+5V: C1.1, C2.1, C3.1, C4.1, IC1.4, IC1.6, IC1.18, IC1.20, IC2.4, IC2.6, IC2.18, IC2.20, IC3.4, IC3.6, IC3.18, IC3.20, IC4.4, IC4.6, IC4.18, IC4.20, P1.1, R1.2, R2.2, R3.2, R4.2
/COL1_DRV1: IC1.30, MATRIX1.9
/COL1_DRV2: IC2.30, MATRIX2.9
/COL1_DRV3: IC3.30, MATRIX3.9
/COL1_DRV4: IC4.30, MATRIX4.9
/COL2_DRV1: IC1.31, MATRIX1.14
/COL2_DRV2: IC2.31, MATRIX2.14
/COL2_DRV3: IC3.31, MATRIX3.14
/COL2_DRV4: IC4.31, MATRIX4.14
/COL3_DRV1: IC1.32, MATRIX1.8
/COL3_DRV2: IC2.32, MATRIX2.8
/COL3_DRV3: IC3.32, MATRIX3.8
/COL3_DRV4: IC4.32, MATRIX4.8
/COL4_DRV1: IC1.1, MATRIX1.12
/COL4_DRV2: IC2.1, MATRIX2.12
/COL4_DRV3: IC3.1, MATRIX3.12
/COL4_DRV4: IC4.1, MATRIX4.12
/COL5_DRV1: IC1.2, MATRIX1.1
/COL5_DRV2: IC2.2, MATRIX2.1
/COL5_DRV3: IC3.2, MATRIX3.1
/COL5_DRV4: IC4.2, MATRIX4.1
/COL6_DRV1: IC1.9, MATRIX1.7
/COL6_DRV2: IC2.9, MATRIX2.7
/COL6_DRV3: IC3.9, MATRIX3.7
/COL6_DRV4: IC4.9, MATRIX4.7
/COL7_DRV1: IC1.10, MATRIX1.2
/COL7_DRV2: IC2.10, MATRIX2.2
/COL7_DRV3: IC3.10, MATRIX3.2
/COL7_DRV4: IC4.10, MATRIX4.2
/COL8_DRV1: IC1.11, MATRIX1.5
/COL8_DRV2: IC2.11, MATRIX2.5
/COL8_DRV3: IC3.11, MATRIX3.5
/COL8_DRV4: IC4.11, MATRIX4.5
/PCINT10/PC2: IC1.25, IC2.25, IC3.25, IC4.25, P1.6
/PCINT11/PC3: IC1.26, IC2.26, IC3.26, IC4.26, P2.5
/RESET_DRV1: IC1.29, P1.2, R1.1
/RESET_DRV2: IC2.29, P1.4, R2.1
/RESET_DRV3: IC3.29, P2.2, R3.1
/RESET_DRV4: IC4.29, P2.4, R4.1
/ROW1_DRV1: IC1.12, R5.1
/ROW1_DRV2: IC2.12, R13.1
/ROW1_DRV3: IC3.12, R21.1
/ROW1_DRV4: IC4.12, R29.1
/ROW2_DRV1: IC1.13, R6.1
/ROW2_DRV2: IC2.13, R14.1
/ROW2_DRV3: IC3.13, R22.1
/ROW2_DRV4: IC4.13, R30.1
/ROW3_DRV1: IC1.14, R7.1
/ROW3_DRV2: IC2.14, R15.1
/ROW3_DRV3: IC3.14, R23.1
/ROW3_DRV4: IC4.14, R31.1
/ROW4_DRV1: IC1.15, R8.1
/ROW4_DRV2: IC2.15, R16.1
/ROW4_DRV3: IC3.15, R24.1
/ROW4_DRV4: IC4.15, R32.1
/ROW5_DRV1: IC1.16, R9.1
/ROW5_DRV2: IC2.16, R17.1
/ROW5_DRV3: IC3.16, R25.1
/ROW5_DRV4: IC4.16, R33.1
/ROW6_DRV1: IC1.17, R10.1
/ROW6_DRV2: IC2.17, R18.1
/ROW6_DRV3: IC3.17, R26.1
/ROW6_DRV4: IC4.17, R34.1
/ROW7_DRV1: IC1.23, R11.1
/ROW7_DRV2: IC2.23, R19.1
/ROW7_DRV3: IC3.23, R27.1
/ROW7_DRV4: IC4.23, R35.1
/ROW8_DRV1: IC1.24, R12.1
/ROW8_DRV2: IC2.24, R20.1
/ROW8_DRV3: IC3.24, R28.1
/ROW8_DRV4: IC4.24, R36.1
/SCL: IC1.28, IC2.28, IC3.28, IC4.28, P2.3
/SDA: IC1.27, IC2.27, IC3.27, IC4.27, P2.1
/XTAL1_DRV1: IC1.7, X1.1
/XTAL1_DRV2: IC2.7, X2.1
/XTAL1_DRV3: IC3.7, X3.1
/XTAL1_DRV4: IC4.7, X4.1
/XTAL2_DRV1: IC1.8, X1.3
/XTAL2_DRV2: IC2.8, X2.3
/XTAL2_DRV3: IC3.8, X3.3
/XTAL2_DRV4: IC4.8, X4.3
GND: C1.2, C2.2, C3.2, C4.2, IC1.3, IC1.5, IC1.21, IC1.33, IC2.3, IC2.5, IC2.21, IC2.33, IC3.3, IC3.5, IC3.21, IC3.33, IC4.3, IC4.5, IC4.21, IC4.33, P1.3, X1.2, X2.2, X3.2, X4.2
unnamed: MATRIX3.11, R26.2
unnamed: MATRIX3.15, R27.2
unnamed: MATRIX3.16, R28.2
unnamed: MATRIX4.6, R33.2
unnamed: MATRIX4.11, R34.2
unnamed: MATRIX4.15, R35.2
unnamed: MATRIX4.16, R36.2
unnamed: MATRIX3.6, R25.2
unnamed: MATRIX4.3, R30.2
unnamed: MATRIX4.4, R31.2
unnamed: MATRIX4.13, R29.2
unnamed: MATRIX4.10, R32.2
unnamed: MATRIX3.3, R22.2
unnamed: MATRIX3.4, R23.2
unnamed: MATRIX3.13, R21.2
unnamed: MATRIX3.10, R24.2
unnamed: MATRIX1.3, R6.2
unnamed: MATRIX1.4, R7.2
unnamed: MATRIX1.13, R5.2
unnamed: MATRIX1.10, R8.2
unnamed: MATRIX2.13, R13.2
unnamed: MATRIX2.3, R14.2
unnamed: MATRIX2.4, R15.2
unnamed: MATRIX2.10, R16.2
unnamed: MATRIX2.6, R17.2
unnamed: MATRIX2.11, R18.2
unnamed: MATRIX2.15, R19.2
unnamed: MATRIX2.16, R20.2
unnamed: MATRIX1.6, R9.2
unnamed: MATRIX1.11, R10.2
unnamed: MATRIX1.15, R11.2
unnamed: MATRIX1.16, R12.2
