floesche/LED-Display_G4_Hardware_Driver/driver_40mm_atmega_v0p5/driver_40mm_atmega_v0p5.kicad_pcb

## KiCad design driver_40mm_atmega_v0p5/driver_40mm_atmega_v0p5.kicad_pcb (2021-11-15)

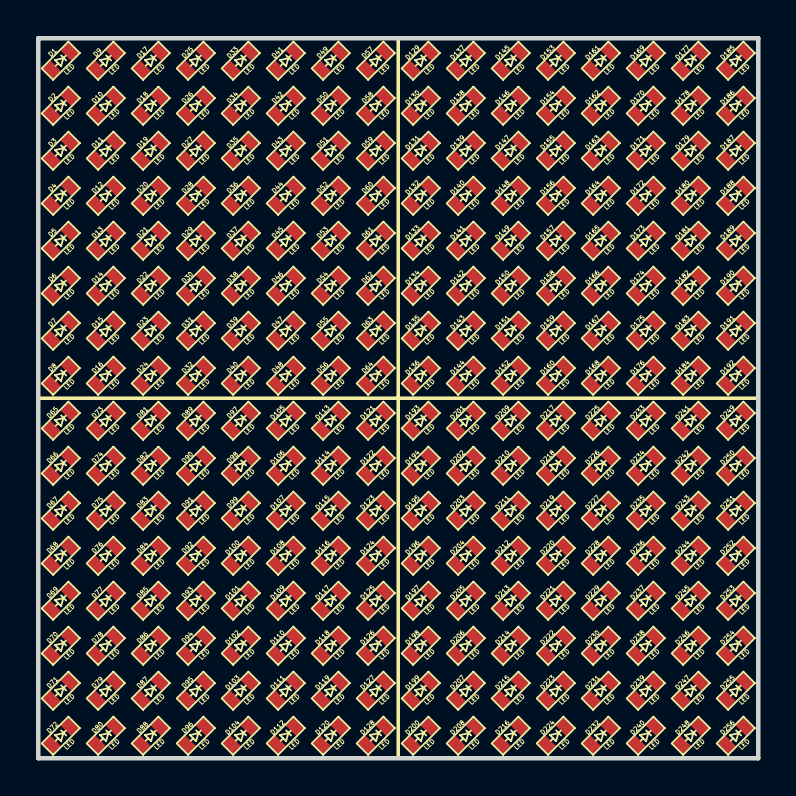
[picture p80: board driver_40mm_atmega_v0p5.kicad_pcb from above]

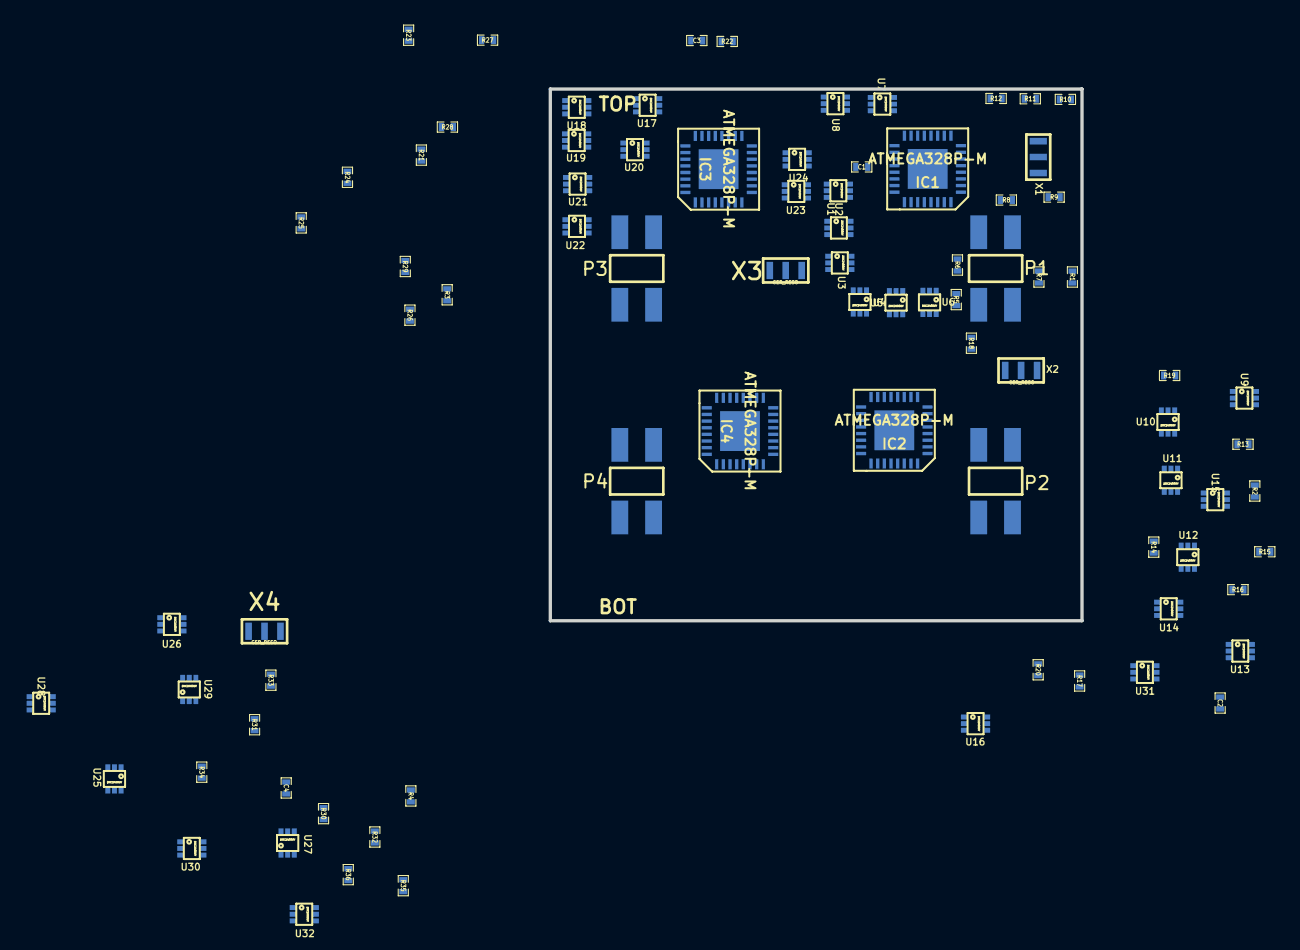
[picture p81: board driver_40mm_atmega_v0p5.kicad_pcb from below]

Board: 4 copper layers, 40.0 x 40.0 mm, 340 parts (84 on the bottom side), 148 nets, no tracks yet.

Parts:
C1, C2, C3, C4: 0.1uF; SM0402
D1, D2, D3, D4, D5, D6, D7, D8, D9, D10, D11, D12, D13, D14, D15, D16, D17, D18, D19, D20, D21, D22, D23, D24, D25, D26, D27, D28, D29, D30, D31, D32, D33, D34, D35, D36, D37, D38, D39, D40, D41, D42, D43, D44, D45, D46, D47, D48, D49, D50, D51, D52, D53, D54, D55, D56, D57, D58, D59, D60, D61, D62, D63, D64, D65, D66, D67, D68, D69, D70, D71, D72, D73, D74, D75, D76, D77, D78, D79, D80, D81, D82, D83, D84, D85, D86, D87, D88, D89, D90, D91, D92, D93, D94, D95, D96, D97, D98, D99, D100, D101, D102, D103, D104, D105, D106, D107, D108, D109, D110, D111, D112, D113, D114, D115, D116, D117, D118, D119, D120, D121, D122, D123, D124, D125, D126, D127, D128, D129, D130, D131, D132, D133, D134, D135, D136, D137, D138, D139, D140, D141, D142, D143, D144, D145, D146, D147, D148, D149, D150, D151, D152, D153, D154, D155, D156, D157, D158, D159, D160, D161, D162, D163, D164, D165, D166, D167, D168, D169, D170, D171, D172, D173, D174, D175, D176, D177, D178, D179, D180, D181, D182, D183, D184, D185, D186, D187, D188, D189, D190, D191, D192, D193, D194, D195, D196, D197, D198, D199, D200, D201, D202, D203, D204, D205, D206, D207, D208, D209, D210, D211, D212, D213, D214, D215, D216, D217, D218, D219, D220, D221, D222, D223, D224, D225, D226, D227, D228, D229, D230, D231, D232, D233, D234, D235, D236, D237, D238, D239, D240, D241, D242, D243, D244, D245, D246, D247, D248, D249, D250, D251, D252, D253, D254, D255, D256: LED; LED0603
IC1, IC2, IC3, IC4: ATMEGA328P-M; QFN32
P1, P2, P3, P4: CONN_2X2; SMD_2X2
R1, R2, R3, R4: 4.7k; SM0402
R5, R6, R7, R8, R9, R10, R11, R12, R13, R14, R15, R16, R17, R18, R19, R20, R21, R22, R23, R24, R25, R26, R27, R28, R29, R30, R31, R32, R33, R34, R35, R36: 180; SM0402
U1, U2, U3, U4, U5, U6, U7, U8, U9, U10, U11, U12, U13, U14, U15, U16, U17, U18, U19, U20, U21, U22, U23, U24, U25, U26, U27, U28, U29, U30, U31, U32: DMC2400UV
X1, X2, X3, X4: CER_RESO

Connections:
+5V: C1.1, C2.1, C3.1, C4.1, IC1.4, IC1.6, IC1.18, IC1.20, IC2.4, IC2.6, IC2.18, IC2.20, IC3.4, IC3.6, IC3.18, IC3.20, IC4.4, IC4.6, IC4.18, IC4.20, P1.1, R1.2, R2.2, R3.2, R4.2, U1.4, U2.4, U3.4, U4.4, U5.4, U6.4, U7.4, U8.4, U9.4, U10.4, U11.4, U12.4, U13.4, U14.4, U15.4, U16.4, U17.4, U18.4, U19.4, U20.4, U21.4, U22.4, U23.4, U24.4, U25.4, U26.4, U27.4, U28.4, U29.4, U30.4, U31.4, U32.4
/COL0_DRV0: IC1.30, R5.1
/COL0_DRV1: IC2.30, R13.1
/COL0_DRV2: IC3.30, R21.1
/COL0_DRV3: IC4.30, R29.1
/COL1_DRV0: IC1.31, R6.1
/COL1_DRV1: IC2.31, R14.1
/COL1_DRV2: IC3.31, R22.1
/COL1_DRV3: IC4.31, R30.1
/COL2_DRV0: IC1.32, R7.1
/COL2_DRV1: IC2.32, R15.1
/COL2_DRV2: IC3.32, R23.1
/COL2_DRV3: IC4.32, R31.1
/COL3_DRV0: IC1.1, R8.1
/COL3_DRV1: IC2.1, R16.1
/COL3_DRV2: IC3.1, R24.1
/COL3_DRV3: IC4.1, R32.1
/COL4_DRV0: IC1.2, R9.1
/COL4_DRV1: IC2.2, R17.1
/COL4_DRV2: IC3.2, R25.1
/COL4_DRV3: IC4.2, R33.1
/COL5_DRV0: IC1.9, R10.1
/COL5_DRV1: IC2.9, R18.1
/COL5_DRV2: IC3.9, R26.1
/COL5_DRV3: IC4.9, R34.1
/COL6_DRV0: IC1.10, R11.1
/COL6_DRV1: IC2.10, R19.1
/COL6_DRV2: IC3.10, R27.1
/COL6_DRV3: IC4.10, R35.1
/COL7_DRV0: IC1.11, R12.1
/COL7_DRV1: IC2.11, R20.1
/COL7_DRV2: IC3.11, R28.1
/COL7_DRV3: IC4.11, R36.1
/CS0: IC1.14, P1.3
/CS1: IC2.14, P2.3
/CS2: IC3.14, P3.2
/CS3: IC4.14, P4.3
/MISO: IC1.16, IC2.16, IC3.16, IC4.16, P2.1
/MOSI: IC1.15, IC2.15, IC3.15, IC4.15, P3.1
/RESET_DRV0: IC1.29, IC3.29, P1.4, P3.4, R1.1, R3.1
/RESET_DRV1: IC2.29, P2.4, R2.1
/RESET_DRV3: IC4.29, P4.1, R4.1
/ROW0_DRV0: IC1.23, U1.2, U1.5
/ROW0_DRV1: IC2.23, U9.2, U9.5
/ROW0_DRV2: IC3.23, U17.2, U17.5
/ROW0_DRV3: IC4.23, U25.2, U25.5
/ROW0_INV0: D1.2, D9.2, D17.2, D25.2, D33.2, D41.2, D49.2, D57.2, U1.3, U1.6
/ROW0_INV1: D65.2, D73.2, D81.2, D89.2, D97.2, D105.2, D113.2, D121.2, U9.3, U9.6
/ROW0_INV2: D129.2, D137.2, D145.2, D153.2, D161.2, D169.2, D177.2, D185.2, U17.3, U17.6
/ROW0_INV3: D193.2, D201.2, D209.2, D217.2, D225.2, D233.2, D241.2, D249.2, U25.3, U25.6
/ROW1_DRV0: IC1.24, U2.2, U2.5
/ROW1_DRV1: IC2.24, U10.2, U10.5
/ROW1_DRV2: IC3.24, U18.2, U18.5
/ROW1_DRV3: IC4.24, U26.2, U26.5
/ROW1_INV0: D2.2, D10.2, D18.2, D26.2, D34.2, D42.2, D50.2, D58.2, U2.3, U2.6
/ROW1_INV1: D66.2, D74.2, D82.2, D90.2, D98.2, D106.2, D114.2, D122.2, U10.3, U10.6
/ROW1_INV2: D130.2, D138.2, D146.2, D154.2, D162.2, D170.2, D178.2, D186.2, U18.3, U18.6
/ROW1_INV3: D194.2, D202.2, D210.2, D218.2, D226.2, D234.2, D242.2, D250.2, U26.3, U26.6
/ROW2_DRV0: IC1.25, U3.2, U3.5
/ROW2_DRV1: IC2.25, U11.2, U11.5
/ROW2_DRV2: IC3.25, U19.2, U19.5
/ROW2_DRV3: IC4.25, U27.2, U27.5
/ROW2_INV0: D3.2, D11.2, D19.2, D27.2, D35.2, D43.2, D51.2, D59.2, U3.3, U3.6
/ROW2_INV1: D67.2, D75.2, D83.2, D91.2, D99.2, D107.2, D115.2, D123.2, U11.3, U11.6
/ROW2_INV2: D131.2, D139.2, D147.2, D155.2, D163.2, D171.2, D179.2, D187.2, U19.3, U19.6
/ROW2_INV3: D195.2, D203.2, D211.2, D219.2, D227.2, D235.2, D243.2, D251.2, U27.3, U27.6
/ROW3_DRV0: IC1.26, U4.2, U4.5
/ROW3_DRV1: IC2.26, U12.2, U12.5
/ROW3_DRV2: IC3.26, U20.2, U20.5
/ROW3_DRV3: IC4.26, U28.2, U28.5
/ROW3_INV0: D4.2, D12.2, D20.2, D28.2, D36.2, D44.2, D52.2, D60.2, U4.3, U4.6
/ROW3_INV1: D68.2, D76.2, D84.2, D92.2, D100.2, D108.2, D116.2, D124.2, U12.3, U12.6
/ROW3_INV2: D132.2, D140.2, D148.2, D156.2, D164.2, D172.2, D180.2, D188.2, U20.3, U20.6
/ROW3_INV3: D196.2, D204.2, D212.2, D220.2, D228.2, D236.2, D244.2, D252.2, U28.3, U28.6
/ROW4_DRV0: IC1.27, U5.2, U5.5
/ROW4_DRV1: IC2.27, U13.2, U13.5
/ROW4_DRV2: IC3.27, U21.2, U21.5
/ROW4_DRV3: IC4.27, U29.2, U29.5
/ROW4_INV0: D5.2, D13.2, D21.2, D29.2, D37.2, D45.2, D53.2, D61.2, U5.3, U5.6
/ROW4_INV1: D69.2, D77.2, D85.2, D93.2, D101.2, D109.2, D117.2, D125.2, U13.3, U13.6
/ROW4_INV2: D133.2, D141.2, D149.2, D157.2, D165.2, D173.2, D181.2, D189.2, U21.3, U21.6
/ROW4_INV3: D197.2, D205.2, D213.2, D221.2, D229.2, D237.2, D245.2, D253.2, U29.3, U29.6
/ROW5_DRV0: IC1.28, U6.2, U6.5
/ROW5_DRV1: IC2.28, U14.2, U14.5
/ROW5_DRV2: IC3.28, U22.2, U22.5
/ROW5_DRV3: IC4.28, U30.2, U30.5
/ROW5_INV0: D6.2, D14.2, D22.2, D30.2, D38.2, D46.2, D54.2, D62.2, U6.3, U6.6
/ROW5_INV1: D70.2, D78.2, D86.2, D94.2, D102.2, D110.2, D118.2, D126.2, U14.3, U14.6
/ROW5_INV2: D134.2, D142.2, D150.2, D158.2, D166.2, D174.2, D182.2, D190.2, U22.3, U22.6
/ROW5_INV3: D198.2, D206.2, D214.2, D222.2, D230.2, D238.2, D246.2, D254.2, U30.3, U30.6
/ROW6_DRV0: IC1.12, U7.2, U7.5
/ROW6_DRV1: IC2.12, U15.2, U15.5
/ROW6_DRV2: IC3.12, U23.2, U23.5
/ROW6_DRV3: IC4.12, U31.2, U31.5
/ROW6_INV0: D7.2, D15.2, D23.2, D31.2, D39.2, D47.2, D55.2, D63.2, U7.3, U7.6
/ROW6_INV1: D71.2, D79.2, D87.2, D95.2, D103.2, D111.2, D119.2, D127.2, U15.3, U15.6
/ROW6_INV2: D135.2, D143.2, D151.2, D159.2, D167.2, D175.2, D183.2, D191.2, U23.3, U23.6
/ROW6_INV3: D199.2, D207.2, D215.2, D223.2, D231.2, D239.2, D247.2, D255.2, U31.3, U31.6
/ROW7_DRV0: IC1.13, U8.2, U8.5
/ROW7_DRV1: IC2.13, U16.2, U16.5
/ROW7_DRV2: IC3.13, U24.2, U24.5
/ROW7_DRV3: IC4.13, U32.2, U32.5
/ROW7_INV0: D8.2, D16.2, D24.2, D32.2, D40.2, D48.2, D56.2, D64.2, U8.3, U8.6
/ROW7_INV1: D72.2, D80.2, D88.2, D96.2, D104.2, D112.2, D120.2, D128.2, U16.3, U16.6
/ROW7_INV2: D136.2, D144.2, D152.2, D160.2, D168.2, D176.2, D184.2, D192.2, U24.3, U24.6
/ROW7_INV3: D200.2, D208.2, D216.2, D224.2, D232.2, D240.2, D248.2, D256.2, U32.3, U32.6
/SCK: IC1.17, IC2.17, IC3.17, IC4.17, P1.2
/XTAL0_DRV0: IC1.7, X1.1
/XTAL0_DRV1: IC2.7, X2.1
/XTAL0_DRV2: IC3.7, X3.1
/XTAL0_DRV3: IC4.7, X4.1
/XTAL1_DRV0: IC1.8, X1.3
/XTAL1_DRV1: IC2.8, X2.3
/XTAL1_DRV2: IC3.8, X3.3
/XTAL1_DRV3: IC4.8, X4.3
GND: C1.2, C2.2, C3.2, C4.2, IC1.3, IC1.5, IC1.21, IC1.33, IC2.3, IC2.5, IC2.21, IC2.33, IC3.3, IC3.5, IC3.21, IC3.33, IC4.3, IC4.5, IC4.21, IC4.33, P4.2, U1.1, U2.1, U3.1, U4.1, U5.1, U6.1, U7.1, U8.1, U9.1, U10.1, U11.1, U12.1, U13.1, U14.1, U15.1, U16.1, U17.1, U18.1, U19.1, U20.1, U21.1, U22.1, U23.1, U24.1, U25.1, U26.1, U27.1, U28.1, U29.1, U30.1, U31.1, U32.1, X1.2, X2.2, X3.2, X4.2
unnamed: D193.1, D194.1, D195.1, D196.1, D197.1, D198.1, D199.1, D200.1, R29.2
unnamed: D201.1, D202.1, D203.1, D204.1, D205.1, D206.1, D207.1, D208.1, R30.2
unnamed: D209.1, D210.1, D211.1, D212.1, D213.1, D214.1, D215.1, D216.1, R31.2
unnamed: D217.1, D218.1, D219.1, D220.1, D221.1, D222.1, D223.1, D224.1, R32.2
unnamed: D225.1, D226.1, D227.1, D228.1, D229.1, D230.1, D231.1, D232.1, R33.2
unnamed: D233.1, D234.1, D235.1, D236.1, D237.1, D238.1, D239.1, D240.1, R34.2
unnamed: D241.1, D242.1, D243.1, D244.1, D245.1, D246.1, D247.1, D248.1, R35.2
unnamed: D249.1, D250.1, D251.1, D252.1, D253.1, D254.1, D255.1, D256.1, R36.2
unnamed: D137.1, D138.1, D139.1, D140.1, D141.1, D142.1, D143.1, D144.1, R22.2
unnamed: D145.1, D146.1, D147.1, D148.1, D149.1, D150.1, D151.1, D152.1, R23.2
unnamed: D153.1, D154.1, D155.1, D156.1, D157.1, D158.1, D159.1, D160.1, R24.2
unnamed: D161.1, D162.1, D163.1, D164.1, D165.1, D166.1, D167.1, D168.1, R25.2
unnamed: D169.1, D170.1, D171.1, D172.1, D173.1, D174.1, D175.1, D176.1, R26.2
unnamed: D177.1, D178.1, D179.1, D180.1, D181.1, D182.1, D183.1, D184.1, R27.2
unnamed: D185.1, D186.1, D187.1, D188.1, D189.1, D190.1, D191.1, D192.1, R28.2
unnamed: D129.1, D130.1, D131.1, D132.1, D133.1, D134.1, D135.1, D136.1, R21.2
unnamed: D73.1, D74.1, D75.1, D76.1, D77.1, D78.1, D79.1, D80.1, R14.2
unnamed: D81.1, D82.1, D83.1, D84.1, D85.1, D86.1, D87.1, D88.1, R15.2
unnamed: D89.1, D90.1, D91.1, D92.1, D93.1, D94.1, D95.1, D96.1, R16.2
unnamed: D97.1, D98.1, D99.1, D100.1, D101.1, D102.1, D103.1, D104.1, R17.2
unnamed: D105.1, D106.1, D107.1, D108.1, D109.1, D110.1, D111.1, D112.1, R18.2
unnamed: D113.1, D114.1, D115.1, D116.1, D117.1, D118.1, D119.1, D120.1, R19.2
unnamed: D121.1, D122.1, D123.1, D124.1, D125.1, D126.1, D127.1, D128.1, R20.2
unnamed: D1.1, D2.1, D3.1, D4.1, D5.1, D6.1, D7.1, D8.1, R5.2
unnamed: D9.1, D10.1, D11.1, D12.1, D13.1, D14.1, D15.1, D16.1, R6.2
unnamed: D17.1, D18.1, D19.1, D20.1, D21.1, D22.1, D23.1, D24.1, R7.2
unnamed: D25.1, D26.1, D27.1, D28.1, D29.1, D30.1, D31.1, D32.1, R8.2
unnamed: D33.1, D34.1, D35.1, D36.1, D37.1, D38.1, D39.1, D40.1, R9.2
unnamed: D41.1, D42.1, D43.1, D44.1, D45.1, D46.1, D47.1, D48.1, R10.2
unnamed: D49.1, D50.1, D51.1, D52.1, D53.1, D54.1, D55.1, D56.1, R11.2
unnamed: D57.1, D58.1, D59.1, D60.1, D61.1, D62.1, D63.1, D64.1, R12.2
unnamed: D65.1, D66.1, D67.1, D68.1, D69.1, D70.1, D71.1, D72.1, R13.2
