floesche/LED-Display_G4_Hardware_Driver/driver_32-64mm_max6960_v0/driver_32-64mm_max6960.sch

## KiCad design driver_32-64mm_max6960_v0/driver_32-64mm_max6960.sch (2021-11-16)

Schematic: driver_32-64mm_max6960.sch

Parts:
C1: 47uF
C2, C3, C4, C5: 0.1uF
M1, M2: LED-MATRIX-8X8
P1, P2: CONN_12
P3: CONN_2
U1: MAX6960

Notes on the sheet:
Input Header
Output Header
Master Select
Power Filtering
