floesche/LED-Display_G4_Hardware_Driver/driver_32mm_atmega_v0p1/driver_32mm_atmega_v0p1.sch

## KiCad design driver_32mm_atmega_v0p1/driver_32mm_atmega_v0p1.sch (2021-11-15)

Schematic: driver_32mm_atmega_v0p1.sch

Parts:
C1, C2: 0.1uF
IC1: ATMEGA328-A; TQFP32
MATRIX1: LED_8X8
P1, P2: CONN_8
R1, R2, R3, R4, R5, R6, R7, R8: 150
R9: 10K
X1: CER_RESO

Notes on the sheet:
BOTTOM
TOP
