floesche/LED-Display_G4_Hardware_Driver/driver_32mm_max6960_v0/driver_32mm_max6960.sch

## KiCad design driver_32mm_max6960_v0/driver_32mm_max6960.sch (2021-11-16)

Schematic: driver_32mm_max6960.sch

Parts:
C1: 47uF
C2: 0.1uF
P1, P2: CONN_12
P3: CONN_2
P4: CONN_8X2
R1, R2: R
U1: MAX6960

Notes on the sheet:
Input Header
Output Header
Master Select
Power Filtering
