floesche/LED-Display_G4_Hardware_Driver/driver_32mm_max6960_v0p1/driver_32mm_max6960_v0p1.sch

## KiCad design driver_32mm_max6960_v0p1/driver_32mm_max6960_v0p1.sch (2021-11-15)

Schematic: driver_32mm_max6960_v0p1.sch

Parts:
C1: 47uF
C2, C3, C4, C5, C6, C7, C8, C9, C10: 0.1uF
M1, M2, M3, M4: LED-MATRIX-8X8
P1: CONN_2X2
U1, U3: MAX6960
U2: 74AHC1G126
U4, U5: CONN15

Notes on the sheet:
Slave
Master
Input Header
Output Header
