floesche/LED-Display_G4_Hardware_Driver/driver_40mm_atmega_v0p1/driver_40mm_atmega_v0p1.sch

## KiCad design driver_40mm_atmega_v0p1/driver_40mm_atmega_v0p1.sch (2021-11-15)

Schematic: driver_40mm_atmega_v0p1.sch

Parts:
C1, C2, C3, C4: 0.1uF
IC1, IC2, IC3, IC4: ATMEGA328P-M; MLF/QFN32
MATRIX1, MATRIX2, MATRIX3, MATRIX4: LED_8X8
P1, P2: CONN_3X2
R1, R2, R3, R4: 1k
R5, R6, R7, R8, R9, R10, R11, R12, R13, R14, R15, R16, R17, R18, R19, R20, R21, R22, R23, R24, R25, R26, R27, R28, R29, R30, R31, R32, R33, R34, R35, R36: 180
X1, X2, X3, X4: CER_RESO

Notes on the sheet:
LED_MATRIX_DRIVERS
POWER FILTERING
BOARD-TO-BOARD CONNECTORS
LED Matrices
two lines to set address
