floesche/LED-Display_G4_Hardware_Driver/driver_40mm_atmega_v0p4/driver_40mm_atmega_v0p4.sch

## KiCad design driver_40mm_atmega_v0p4/driver_40mm_atmega_v0p4.sch (2021-11-15)

Schematic: driver_40mm_atmega_v0p4.sch

Parts:
C1, C2, C3, C4: 0.1uF
IC1, IC2, IC3, IC4: ATMEGA328P-M; MLF/QFN32
MATRIX1, MATRIX2, MATRIX3, MATRIX4: LED_8X8
P1, P2, P3, P4: CONN_2X2
R1, R2, R3, R4: 4.7k
R5, R6, R7, R8, R9, R10, R11, R12, R13, R14, R15, R16, R17, R18, R19, R20, R21, R22, R23, R24, R25, R26, R27, R28, R29, R30, R31, R32, R33, R34, R35, R36: 160
U1, U2, U3, U4, U5, U6, U7, U8, U9, U10, U11, U12, U13, U14, U15, U16, U17, U18, U19, U20, U21, U22, U23, U24, U25, U26, U27, U28, U29, U30, U31, U32: DMC2400UV
X1, X2, X3, X4: CER_RESO

Notes on the sheet:
LED_MATRIX_DRIVERS
POWER FILTERING
BOARD-TO-BOARD CONNECTORS
LED Matrices
