floesche/LED-Display_G4_Hardware_Driver/driver_40mm_max6960_v0/driver_40mm_max6960_v0p1.sch

## KiCad design driver_40mm_max6960_v0/driver_40mm_max6960_v0p1.sch (2021-11-15)

Schematic: driver_40mm_max6960_v0p1.sch

Parts:
C1: 47uF
C2, C3: 0.1uF
P1, P2: CONN15X2
P3, P4: CONN15
U1, U3: MAX6960
U2: 74AHC1G126

Notes on the sheet:
Slave
Master
Input Header
Output Header
