floesche/LED-Display_G4_Hardware_Driver/(commit log)

2020-08-06 initial commit, as received from jET
    [BOM V2.xlsx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]
2020-08-10 add eagle file
    [2017-03-26_LED-Panel_G4_V1.brd]
2020-08-13 update to mm based GRB for V1, generated today
    [LED 8x8 Panel-1-6.drl, LED Panel G4 V1, 03-26-2017-1-6.drl]
2020-08-17 define version 1.2, restructure paths
    [2017-03-26_LED-Panel_G4_V1.brd, BOM.xlsx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]
2020-08-27 update panel v1
    [driver_L1-6.drl]
2020-08-27 reorganize production folder
    [BOM.xlsx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]
2020-08-31 update BOM, add paste layer
    [BOM.xlsx]
2020-11-11 rename schematic file
    [2017-03-26_LED-Panel_G4_V1.brd]
2020-11-12 received design file from jET, generated fabrication files from that
    [driver_G4_v1p7.brd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]
2021-11-15 update driver description
    [BOM.xlsx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]
2021-11-15 fix KiCad files
    [BOM.xls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]
2021-11-15 update v0p4
    [driver-B_Cu.gbl, driver-B_Mask.gbs, driver-B_SilkS.gbo, driver-Edge_Cuts.gbr, driver-F_Cu.gtl, driver-F_Mask.gts, driver-F_SilkS.gto, driver-Inner1_Cu.gbr]
2021-11-15 add v0p3
    [BOM.xls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]
2021-11-15 consistent file name
    [driver-B_Cu.gbl, driver-B_Mask.gbs, driver-B_SilkS.gbo, driver-Edge_Cuts.gbr, driver-F_Cu.gtl, driver-F_Mask.gts, driver-F_SilkS.gto, driver.drl]
2021-11-15 add driver v0p2
    [BOM.xls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]
2021-11-15 move atmel driver here
    [BOM.xls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]
2021-11-15 add 32mm driver
    [BOM.xls, driver_32mm_atmega_v0p1.kicad_pcb, driver_32mm_atmega_v0p1.sch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]
2021-11-15 add v0p2
    [BOM.xls, driver_32mm_atmega_v0p2.kicad_pcb, driver_32mm_atmega_v0p2.sch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]
2021-11-15 add 32mm v0p2
    [flypanels-B_Mask.gbs, flypanels-B_SilkS.gbo, flypanels-Back.gbl, flypanels-Edge_Cuts.gbr, flypanels-F_Mask.gts, flypanels-F_SilkS.gto, flypanels-Front.gtl, flypanels.drl]
2021-11-15 file naming
    [BOM.xlsx, driver_40mm_atmega_v1p7.brd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]
2021-11-15 move max6960 here
    [BOM.xls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]
2021-11-15 add max6960 32mm driver
    [driver_32mm_max6960_v0p1.kicad_pcb, driver_32mm_max6960_v0p1.sch, driver_40mm_max6960_v0p1.sch]
2021-11-15 consistent file naming
    [BOM.xls, adapter_32mm-64mm_v0p1.kicad_pcb, adapter_32mm-64mm_v0p1.sch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]
2021-11-15 add adapters to 40mm max
    [BOM.xls, adapter_20mm-40mm_v0p1.kicad_pcb, adapter_20mm-40mm_v0p1.sch, adapter_20mm-40mm_v0p2.kicad_pcb, adapter_20mm-40mm_v0p2.sch]
2021-11-16 add driver 32mm max6960
    [driver_32mm_max6960.kicad_pcb, driver_32mm_max6960.sch]
2021-11-16 add adapter for 32mm max
    [adapter_32mm-32mm.kicad_pcb, adapter_32mm-32mm.sch]
2021-11-16 add two-panel max version
    [driver_32-64mm_max6960.kicad_pcb, driver_32-64mm_max6960.sch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]
2021-11-16 add adapters
    [adapter_32-32mm-32-64mm.kicad_pcb, adapter_32-32mm-32-64mm.sch, adapter_32-64mm-32-64mm.kicad_pcb, adapter_32-64mm-32-64mm.sch]
2021-11-16 add diode adapter
    [adapter_32-32mm-32-64mm-D.kicad_pcb, adapter_32-32mm-32-64mm-D.sch]
2022-10-28 top silkscreen without feet
2022-10-28 new version → documentation
